mhz20031217/RISwitch/riswitch/vsrc/vga_ctrl.sv

`timescale 10ns/1ns
module vga_ctrl(
    input pclk,
    input reset,
    input [11:0] vga_data,
    output [9:0] h_addr,
    output [9:0] v_addr,
    output hsync,
    output vsync,
    output valid,
    output [3:0] vga_r,
    output [3:0] vga_g,
    output [3:0] vga_b
);

parameter h_frontporch = 96;
parameter h_active = 144;
parameter h_backporch = 784;
parameter h_total = 800;

parameter v_frontporch = 2;
parameter v_active = 35;
parameter v_backporch = 515;
parameter v_total = 525;

reg [9:0] x_cnt;
reg [9:0] y_cnt;
wire h_valid;
wire v_valid;

always @(posedge pclk) begin
    if (reset == 1'b1) begin
        x_cnt <= 1;
        y_cnt <= 1;
    end
    else begin
        if (x_cnt == h_total) begin
            x_cnt <= 1;
            if (y_cnt == v_total)
                y_cnt <= 1;
            else
                y_cnt <= y_cnt + 1;
        end
        else
            x_cnt <= x_cnt + 1;
    end
end

assign hsync = (x_cnt > h_frontporch);
assign vsync = (y_cnt > v_frontporch);

assign h_valid = (x_cnt > h_active) & (x_cnt <= h_backporch);
assign v_valid = (y_cnt > v_active) & (y_cnt <= v_backporch);
assign valid = h_valid & v_valid;

assign h_addr = h_valid ? (x_cnt - 10'd145) : {10{1'b0}};
assign v_addr = v_valid ? (y_cnt - 10'd36) : {10{1'b0}};

assign {vga_r, vga_g, vga_b} = (valid) ? vga_data : 12'b0;

endmodule
