mhz20031217/RISwitch/am-kernels/tests/fpga-simple/src/main.c

#include <am.h>
#include <klib.h>
#include <klib-macros.h>

void delay() {
  for (volatile int i = 0; i < 10; i ++);
}

void led_test() {
  for (volatile uint16_t i = 1; i; i <<= 1) {
    io_write(AM_LED, i);
    //delay();
  }
  io_write(AM_LED, 1234);
}

void seg_test() {
  volatile uint32_t v = 0xabcdef88;
  for (volatile int i = 0; i < 1000000; i ++) {
    io_write(AM_SEG, v);
    delay();
    v = (v << 4) | (v >> 28);
  }
}

int main(const char *args) {
  halt(SWITCH_EXIT_SUCCESS);
}
