mhz20031217/RISwitch/(commit log)

2023-09-10 NJU-ProjectN/fceux-am ics2021 initialized without tracing
    NJU-ProjectN/fceux-am c56157ba6627ae35eb1457c365ea7e6ed125aaf2 driver,sdl,sdl-video: fix the number of scanline
2023-09-10 > compile NEMU 221830012 茆弘之 Linux pc 5.15.0-79-generic #86-Ubuntu SMP Mon Jul 10 16:07:21 UTC 2023 x86_64 x86_64 x86_64 GNU/Linux 16:56:16 up 11 days, 22:02, 15 users, load average: 1.12, 0.72, 0.50
2023-09-10 > compile NEMU 221830012 茆弘之 Linux pc 5.15.0-79-generic #86-Ubuntu SMP Mon Jul 10 16:07:21 UTC 2023 x86_64 x86_64 x86_64 GNU/Linux 16:56:27 up 11 days, 22:02, 15 users, load average: 0.94, 0.70, 0.50
2023-09-10 > run NEMU 221830012 茆弘之 Linux pc 5.15.0-79-generic #86-Ubuntu SMP Mon Jul 10 16:07:21 UTC 2023 x86_64 x86_64 x86_64 GNU/Linux 16:56:28 up 11 days, 22:02, 15 users, load average: 0.94, 0.70, 0.50
2023-09-10 > compile NEMU 221830012 茆弘之 Linux pc 5.15.0-79-generic #86-Ubuntu SMP Mon Jul 10 16:07:21 UTC 2023 x86_64 x86_64 x86_64 GNU/Linux 16:56:39 up 11 days, 22:02, 15 users, load average: 1.10, 0.75, 0.52
2023-09-10 > gdb NEMU 221830012 茆弘之 Linux pc 5.15.0-79-generic #86-Ubuntu SMP Mon Jul 10 16:07:21 UTC 2023 x86_64 x86_64 x86_64 GNU/Linux 16:56:40 up 11 days, 22:02, 15 users, load average: 1.10, 0.75, 0.52
2023-09-10 > compile NEMU 221830012 茆弘之 Linux pc 5.15.0-79-generic #86-Ubuntu SMP Mon Jul 10 16:07:21 UTC 2023 x86_64 x86_64 x86_64 GNU/Linux 20:59:58 up 12 days, 2:05, 4 users, load average: 0.41, 0.45, 0.51
2023-09-10 > compile NEMU 221830012 茆弘之 Linux pc 5.15.0-79-generic #86-Ubuntu SMP Mon Jul 10 16:07:21 UTC 2023 x86_64 x86_64 x86_64 GNU/Linux 21:00:57 up 12 days, 2:06, 4 users, load average: 0.28, 0.41, 0.49
2023-09-10 > compile NEMU 221830012 茆弘之 Linux pc 5.15.0-79-generic #86-Ubuntu SMP Mon Jul 10 16:07:21 UTC 2023 x86_64 x86_64 x86_64 GNU/Linux 21:01:35 up 12 days, 2:07, 4 users, load average: 0.49, 0.44, 0.50
2023-09-10 > compile NEMU 221830012 茆弘之 Linux pc 5.15.0-79-generic #86-Ubuntu SMP Mon Jul 10 16:07:21 UTC 2023 x86_64 x86_64 x86_64 GNU/Linux 21:02:14 up 12 days, 2:08, 4 users, load average: 0.37, 0.41, 0.49
2023-09-10 > compile NEMU 221830012 茆弘之 Linux pc 5.15.0-79-generic #86-Ubuntu SMP Mon Jul 10 16:07:21 UTC 2023 x86_64 x86_64 x86_64 GNU/Linux 21:03:23 up 12 days, 2:09, 4 users, load average: 0.24, 0.36, 0.46
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2023-09-12 > compile NEMU 221830012 茆弘之 Linux pc 5.15.0-79-generic #86-Ubuntu SMP Mon Jul 10 16:07:21 UTC 2023 x86_64 x86_64 x86_64 GNU/Linux 11:46:47 up 13 days, 16:52, 4 users, load average: 1.14, 0.94, 0.77
2023-09-12 > compile NEMU 221830012 茆弘之 Linux pc 5.15.0-79-generic #86-Ubuntu SMP Mon Jul 10 16:07:21 UTC 2023 x86_64 x86_64 x86_64 GNU/Linux 11:48:33 up 13 days, 16:54, 4 users, load average: 1.05, 0.94, 0.79
2023-09-12 > compile NEMU 221830012 茆弘之 Linux pc 5.15.0-79-generic #86-Ubuntu SMP Mon Jul 10 16:07:21 UTC 2023 x86_64 x86_64 x86_64 GNU/Linux 11:49:17 up 13 days, 16:55, 4 users, load average: 0.63, 0.84, 0.76
2023-09-12 > run NEMU 221830012 茆弘之 Linux pc 5.15.0-79-generic #86-Ubuntu SMP Mon Jul 10 16:07:21 UTC 2023 x86_64 x86_64 x86_64 GNU/Linux 11:49:18 up 13 days, 16:55, 4 users, load average: 0.63, 0.84, 0.76
2023-09-12 > compile NEMU 221830012 茆弘之 Linux pc 5.15.0-79-generic #86-Ubuntu SMP Mon Jul 10 16:07:21 UTC 2023 x86_64 x86_64 x86_64 GNU/Linux 11:49:51 up 13 days, 16:55, 4 users, load average: 0.47, 0.78, 0.74
2023-09-12 > run NEMU 221830012 茆弘之 Linux pc 5.15.0-79-generic #86-Ubuntu SMP Mon Jul 10 16:07:21 UTC 2023 x86_64 x86_64 x86_64 GNU/Linux 11:49:52 up 13 days, 16:55, 4 users, load average: 0.47, 0.78, 0.74
2023-09-12 > compile NEMU 221830012 茆弘之 Linux pc 5.15.0-79-generic #86-Ubuntu SMP Mon Jul 10 16:07:21 UTC 2023 x86_64 x86_64 x86_64 GNU/Linux 11:50:08 up 13 days, 16:55, 4 users, load average: 0.69, 0.81, 0.75
2023-09-12 > run NEMU 221830012 茆弘之 Linux pc 5.15.0-79-generic #86-Ubuntu SMP Mon Jul 10 16:07:21 UTC 2023 x86_64 x86_64 x86_64 GNU/Linux 11:50:09 up 13 days, 16:55, 4 users, load average: 0.69, 0.81, 0.75
2023-09-12 > compile NEMU 221830012 茆弘之 Linux pc 5.15.0-79-generic #86-Ubuntu SMP Mon Jul 10 16:07:21 UTC 2023 x86_64 x86_64 x86_64 GNU/Linux 11:57:37 up 13 days, 17:03, 4 users, load average: 1.59, 1.10, 0.89
2023-09-12 > compile NEMU 221830012 茆弘之 Linux pc 5.15.0-79-generic #86-Ubuntu SMP Mon Jul 10 16:07:21 UTC 2023 x86_64 x86_64 x86_64 GNU/Linux 11:57:40 up 13 days, 17:03, 4 users, load average: 1.59, 1.10, 0.89
2023-09-12 > run NEMU 221830012 茆弘之 Linux pc 5.15.0-79-generic #86-Ubuntu SMP Mon Jul 10 16:07:21 UTC 2023 x86_64 x86_64 x86_64 GNU/Linux 11:57:41 up 13 days, 17:03, 4 users, load average: 1.55, 1.10, 0.89
2023-09-12 > compile NEMU 221830012 茆弘之 Linux pc 5.15.0-79-generic #86-Ubuntu SMP Mon Jul 10 16:07:21 UTC 2023 x86_64 x86_64 x86_64 GNU/Linux 13:32:41 up 13 days, 18:38, 4 users, load average: 0.21, 0.28, 0.44
2023-09-12 > run NEMU 221830012 茆弘之 Linux pc 5.15.0-79-generic #86-Ubuntu SMP Mon Jul 10 16:07:21 UTC 2023 x86_64 x86_64 x86_64 GNU/Linux 13:32:42 up 13 days, 18:38, 4 users, load average: 0.21, 0.28, 0.44
2023-09-12 > compile NEMU 221830012 茆弘之 Linux pc 5.15.0-79-generic #86-Ubuntu SMP Mon Jul 10 16:07:21 UTC 2023 x86_64 x86_64 x86_64 GNU/Linux 13:35:01 up 13 days, 18:40, 4 users, load average: 0.84, 0.43, 0.47
2023-09-12 > run NEMU 221830012 茆弘之 Linux pc 5.15.0-79-generic #86-Ubuntu SMP Mon Jul 10 16:07:21 UTC 2023 x86_64 x86_64 x86_64 GNU/Linux 13:35:01 up 13 days, 18:40, 4 users, load average: 0.84, 0.43, 0.47
2023-09-12 > compile NEMU 221830012 茆弘之 Linux pc 5.15.0-79-generic #86-Ubuntu SMP Mon Jul 10 16:07:21 UTC 2023 x86_64 x86_64 x86_64 GNU/Linux 13:35:54 up 13 days, 18:41, 4 users, load average: 0.70, 0.46, 0.48
2023-09-12 > run NEMU 221830012 茆弘之 Linux pc 5.15.0-79-generic #86-Ubuntu SMP Mon Jul 10 16:07:21 UTC 2023 x86_64 x86_64 x86_64 GNU/Linux 13:35:55 up 13 days, 18:41, 4 users, load average: 0.73, 0.47, 0.48
2023-09-12 > compile NEMU 221830012 茆弘之 Linux pc 5.15.0-79-generic #86-Ubuntu SMP Mon Jul 10 16:07:21 UTC 2023 x86_64 x86_64 x86_64 GNU/Linux 13:38:23 up 13 days, 18:44, 4 users, load average: 0.30, 0.41, 0.45
2023-09-12 > run NEMU 221830012 茆弘之 Linux pc 5.15.0-79-generic #86-Ubuntu SMP Mon Jul 10 16:07:21 UTC 2023 x86_64 x86_64 x86_64 GNU/Linux 13:38:23 up 13 days, 18:44, 4 users, load average: 0.30, 0.41, 0.45
2023-09-12 > compile NEMU 221830012 茆弘之 Linux pc 5.15.0-79-generic #86-Ubuntu SMP Mon Jul 10 16:07:21 UTC 2023 x86_64 x86_64 x86_64 GNU/Linux 13:39:31 up 13 days, 18:45, 4 users, load average: 0.52, 0.45, 0.46
2023-09-12 > run NEMU 221830012 茆弘之 Linux pc 5.15.0-79-generic #86-Ubuntu SMP Mon Jul 10 16:07:21 UTC 2023 x86_64 x86_64 x86_64 GNU/Linux 13:39:31 up 13 days, 18:45, 4 users, load average: 0.52, 0.45, 0.46
2023-09-12 > compile NEMU 221830012 茆弘之 Linux pc 5.15.0-79-generic #86-Ubuntu SMP Mon Jul 10 16:07:21 UTC 2023 x86_64 x86_64 x86_64 GNU/Linux 13:51:32 up 13 days, 18:57, 4 users, load average: 2.24, 1.31, 0.80
2023-09-12 > compile NEMU 221830012 茆弘之 Linux pc 5.15.0-79-generic #86-Ubuntu SMP Mon Jul 10 16:07:21 UTC 2023 x86_64 x86_64 x86_64 GNU/Linux 13:51:46 up 13 days, 18:57, 4 users, load average: 2.73, 1.46, 0.86
2023-09-12 > compile NEMU 221830012 茆弘之 Linux pc 5.15.0-79-generic #86-Ubuntu SMP Mon Jul 10 16:07:21 UTC 2023 x86_64 x86_64 x86_64 GNU/Linux 15:58:47 up 13 days, 21:04, 4 users, load average: 0.38, 0.58, 0.77
2023-09-12 > run NEMU 221830012 茆弘之 Linux pc 5.15.0-79-generic #86-Ubuntu SMP Mon Jul 10 16:07:21 UTC 2023 x86_64 x86_64 x86_64 GNU/Linux 15:58:47 up 13 days, 21:04, 4 users, load average: 0.38, 0.58, 0.77
2023-09-12 > compile NEMU 221830012 茆弘之 Linux pc 5.15.0-79-generic #86-Ubuntu SMP Mon Jul 10 16:07:21 UTC 2023 x86_64 x86_64 x86_64 GNU/Linux 16:04:29 up 13 days, 21:10, 4 users, load average: 0.41, 0.42, 0.63
2023-09-12 > run NEMU 221830012 茆弘之 Linux pc 5.15.0-79-generic #86-Ubuntu SMP Mon Jul 10 16:07:21 UTC 2023 x86_64 x86_64 x86_64 GNU/Linux 16:04:29 up 13 days, 21:10, 4 users, load average: 0.41, 0.42, 0.63
2023-09-12 > compile NEMU 221830012 茆弘之 Linux pc 5.15.0-79-generic #86-Ubuntu SMP Mon Jul 10 16:07:21 UTC 2023 x86_64 x86_64 x86_64 GNU/Linux 17:43:27 up 13 days, 22:49, 4 users, load average: 0.91, 0.77, 0.70
2023-09-12 > run NEMU 221830012 茆弘之 Linux pc 5.15.0-79-generic #86-Ubuntu SMP Mon Jul 10 16:07:21 UTC 2023 x86_64 x86_64 x86_64 GNU/Linux 17:43:28 up 13 days, 22:49, 4 users, load average: 0.91, 0.77, 0.70
2023-09-12 > compile NEMU 221830012 茆弘之 Linux pc 5.15.0-79-generic #86-Ubuntu SMP Mon Jul 10 16:07:21 UTC 2023 x86_64 x86_64 x86_64 GNU/Linux 17:44:16 up 13 days, 22:50, 4 users, load average: 0.89, 0.78, 0.71
2023-09-12 > run NEMU 221830012 茆弘之 Linux pc 5.15.0-79-generic #86-Ubuntu SMP Mon Jul 10 16:07:21 UTC 2023 x86_64 x86_64 x86_64 GNU/Linux 17:44:17 up 13 days, 22:50, 4 users, load average: 0.89, 0.78, 0.71
2023-09-12 > compile NEMU 221830012 茆弘之 Linux pc 5.15.0-79-generic #86-Ubuntu SMP Mon Jul 10 16:07:21 UTC 2023 x86_64 x86_64 x86_64 GNU/Linux 18:17:17 up 13 days, 23:23, 4 users, load average: 0.88, 0.65, 0.70
2023-09-12 > run NEMU 221830012 茆弘之 Linux pc 5.15.0-79-generic #86-Ubuntu SMP Mon Jul 10 16:07:21 UTC 2023 x86_64 x86_64 x86_64 GNU/Linux 18:17:17 up 13 days, 23:23, 4 users, load average: 0.88, 0.65, 0.70
2023-09-12 > compile NEMU 221830012 茆弘之 Linux pc 5.15.0-79-generic #86-Ubuntu SMP Mon Jul 10 16:07:21 UTC 2023 x86_64 x86_64 x86_64 GNU/Linux 22:28:09 up 14 days, 3:33, 4 users, load average: 1.01, 0.96, 0.79
2023-09-12 > run NEMU 221830012 茆弘之 Linux pc 5.15.0-79-generic #86-Ubuntu SMP Mon Jul 10 16:07:21 UTC 2023 x86_64 x86_64 x86_64 GNU/Linux 22:28:09 up 14 days, 3:33, 4 users, load average: 1.01, 0.96, 0.79
2023-09-14 > compile NEMU 221830012 茆弘之 Linux pc 5.15.0-82-generic #91-Ubuntu SMP Mon Aug 14 14:14:14 UTC 2023 x86_64 x86_64 x86_64 GNU/Linux 10:21:38 up 14:47, 4 users, load average: 0.67, 0.64, 0.70
2023-09-14 > run NEMU 221830012 茆弘之 Linux pc 5.15.0-82-generic #91-Ubuntu SMP Mon Aug 14 14:14:14 UTC 2023 x86_64 x86_64 x86_64 GNU/Linux 10:21:39 up 14:47, 4 users, load average: 0.70, 0.65, 0.70
2023-09-14 > compile NEMU 221830012 茆弘之 Linux pc 5.15.0-82-generic #91-Ubuntu SMP Mon Aug 14 14:14:14 UTC 2023 x86_64 x86_64 x86_64 GNU/Linux 10:24:07 up 14:50, 4 users, load average: 0.90, 0.78, 0.75
2023-09-14 > run NEMU 221830012 茆弘之 Linux pc 5.15.0-82-generic #91-Ubuntu SMP Mon Aug 14 14:14:14 UTC 2023 x86_64 x86_64 x86_64 GNU/Linux 10:24:08 up 14:50, 4 users, load average: 0.90, 0.78, 0.75
2023-09-14 > compile NEMU 221830012 茆弘之 Linux pc 5.15.0-82-generic #91-Ubuntu SMP Mon Aug 14 14:14:14 UTC 2023 x86_64 x86_64 x86_64 GNU/Linux 10:24:23 up 14:50, 4 users, load average: 0.70, 0.74, 0.73
2023-09-14 > gdb NEMU 221830012 茆弘之 Linux pc 5.15.0-82-generic #91-Ubuntu SMP Mon Aug 14 14:14:14 UTC 2023 x86_64 x86_64 x86_64 GNU/Linux 10:24:24 up 14:50, 4 users, load average: 0.73, 0.74, 0.73
2023-09-14 > compile NEMU 221830012 茆弘之 Linux pc 5.15.0-82-generic #91-Ubuntu SMP Mon Aug 14 14:14:14 UTC 2023 x86_64 x86_64 x86_64 GNU/Linux 10:31:03 up 14:57, 4 users, load average: 0.34, 0.51, 0.63
2023-09-14 > gdb NEMU 221830012 茆弘之 Linux pc 5.15.0-82-generic #91-Ubuntu SMP Mon Aug 14 14:14:14 UTC 2023 x86_64 x86_64 x86_64 GNU/Linux 10:31:04 up 14:57, 4 users, load average: 0.34, 0.51, 0.63
2023-09-14 > compile NEMU 221830012 茆弘之 Linux pc 5.15.0-82-generic #91-Ubuntu SMP Mon Aug 14 14:14:14 UTC 2023 x86_64 x86_64 x86_64 GNU/Linux 10:34:18 up 15:00, 4 users, load average: 0.25, 0.39, 0.56
2023-09-14 > gdb NEMU 221830012 茆弘之 Linux pc 5.15.0-82-generic #91-Ubuntu SMP Mon Aug 14 14:14:14 UTC 2023 x86_64 x86_64 x86_64 GNU/Linux 10:34:19 up 15:00, 4 users, load average: 0.31, 0.40, 0.56
2023-09-14 > compile NEMU 221830012 茆弘之 Linux pc 5.15.0-82-generic #91-Ubuntu SMP Mon Aug 14 14:14:14 UTC 2023 x86_64 x86_64 x86_64 GNU/Linux 10:34:57 up 15:00, 4 users, load average: 0.37, 0.40, 0.55
2023-09-14 > gdb NEMU 221830012 茆弘之 Linux pc 5.15.0-82-generic #91-Ubuntu SMP Mon Aug 14 14:14:14 UTC 2023 x86_64 x86_64 x86_64 GNU/Linux 10:34:58 up 15:00, 4 users, load average: 0.37, 0.40, 0.55
2023-09-14 > compile NEMU 221830012 茆弘之 Linux pc 5.15.0-82-generic #91-Ubuntu SMP Mon Aug 14 14:14:14 UTC 2023 x86_64 x86_64 x86_64 GNU/Linux 10:49:55 up 15:15, 4 users, load average: 0.55, 0.41, 0.45
2023-09-14 > gdb NEMU 221830012 茆弘之 Linux pc 5.15.0-82-generic #91-Ubuntu SMP Mon Aug 14 14:14:14 UTC 2023 x86_64 x86_64 x86_64 GNU/Linux 10:49:55 up 15:15, 4 users, load average: 0.59, 0.42, 0.46
2023-09-14 > compile NEMU 221830012 茆弘之 Linux pc 5.15.0-82-generic #91-Ubuntu SMP Mon Aug 14 14:14:14 UTC 2023 x86_64 x86_64 x86_64 GNU/Linux 10:56:26 up 15:22, 4 users, load average: 1.01, 0.79, 0.61
2023-09-14 > gdb NEMU 221830012 茆弘之 Linux pc 5.15.0-82-generic #91-Ubuntu SMP Mon Aug 14 14:14:14 UTC 2023 x86_64 x86_64 x86_64 GNU/Linux 10:56:27 up 15:22, 4 users, load average: 1.01, 0.79, 0.61
2023-09-14 > compile NEMU 221830012 茆弘之 Linux pc 5.15.0-82-generic #91-Ubuntu SMP Mon Aug 14 14:14:14 UTC 2023 x86_64 x86_64 x86_64 GNU/Linux 11:03:52 up 15:29, 4 users, load average: 0.86, 0.68, 0.60
2023-09-14 > gdb NEMU 221830012 茆弘之 Linux pc 5.15.0-82-generic #91-Ubuntu SMP Mon Aug 14 14:14:14 UTC 2023 x86_64 x86_64 x86_64 GNU/Linux 11:03:53 up 15:29, 4 users, load average: 0.86, 0.68, 0.60
2023-09-14 > compile NEMU 221830012 茆弘之 Linux pc 5.15.0-82-generic #91-Ubuntu SMP Mon Aug 14 14:14:14 UTC 2023 x86_64 x86_64 x86_64 GNU/Linux 11:07:00 up 15:33, 4 users, load average: 1.28, 1.20, 0.84
2023-09-14 > gdb NEMU 221830012 茆弘之 Linux pc 5.15.0-82-generic #91-Ubuntu SMP Mon Aug 14 14:14:14 UTC 2023 x86_64 x86_64 x86_64 GNU/Linux 11:07:01 up 15:33, 4 users, load average: 1.25, 1.19, 0.84
2023-09-14 > compile NEMU 221830012 茆弘之 Linux pc 5.15.0-82-generic #91-Ubuntu SMP Mon Aug 14 14:14:14 UTC 2023 x86_64 x86_64 x86_64 GNU/Linux 11:07:27 up 15:33, 4 users, load average: 2.45, 1.49, 0.95
2023-09-14 > gdb NEMU 221830012 茆弘之 Linux pc 5.15.0-82-generic #91-Ubuntu SMP Mon Aug 14 14:14:14 UTC 2023 x86_64 x86_64 x86_64 GNU/Linux 11:07:27 up 15:33, 4 users, load average: 2.45, 1.49, 0.95
2023-09-14 > compile NEMU 221830012 茆弘之 Linux pc 5.15.0-82-generic #91-Ubuntu SMP Mon Aug 14 14:14:14 UTC 2023 x86_64 x86_64 x86_64 GNU/Linux 11:10:14 up 15:36, 4 users, load average: 1.15, 1.32, 0.98
2023-09-14 > gdb NEMU 221830012 茆弘之 Linux pc 5.15.0-82-generic #91-Ubuntu SMP Mon Aug 14 14:14:14 UTC 2023 x86_64 x86_64 x86_64 GNU/Linux 11:10:15 up 15:36, 4 users, load average: 1.15, 1.32, 0.98
2023-09-14 > compile NEMU 221830012 茆弘之 Linux pc 5.15.0-82-generic #91-Ubuntu SMP Mon Aug 14 14:14:14 UTC 2023 x86_64 x86_64 x86_64 GNU/Linux 11:12:32 up 15:38, 4 users, load average: 0.38, 0.95, 0.89
2023-09-14 > gdb NEMU 221830012 茆弘之 Linux pc 5.15.0-82-generic #91-Ubuntu SMP Mon Aug 14 14:14:14 UTC 2023 x86_64 x86_64 x86_64 GNU/Linux 11:12:33 up 15:38, 4 users, load average: 0.38, 0.95, 0.89
2023-09-14 > compile NEMU 221830012 茆弘之 Linux pc 5.15.0-82-generic #91-Ubuntu SMP Mon Aug 14 14:14:14 UTC 2023 x86_64 x86_64 x86_64 GNU/Linux 11:14:28 up 15:40, 4 users, load average: 0.63, 0.82, 0.84
2023-09-14 > gdb NEMU 221830012 茆弘之 Linux pc 5.15.0-82-generic #91-Ubuntu SMP Mon Aug 14 14:14:14 UTC 2023 x86_64 x86_64 x86_64 GNU/Linux 11:14:29 up 15:40, 4 users, load average: 0.63, 0.82, 0.84
2023-09-14 > compile NEMU 221830012 茆弘之 Linux pc 5.15.0-82-generic #91-Ubuntu SMP Mon Aug 14 14:14:14 UTC 2023 x86_64 x86_64 x86_64 GNU/Linux 11:16:17 up 15:42, 4 users, load average: 0.90, 0.83, 0.84
2023-09-14 > gdb NEMU 221830012 茆弘之 Linux pc 5.15.0-82-generic #91-Ubuntu SMP Mon Aug 14 14:14:14 UTC 2023 x86_64 x86_64 x86_64 GNU/Linux 11:16:18 up 15:42, 4 users, load average: 0.90, 0.83, 0.84
2023-09-14 > compile NEMU 221830012 茆弘之 Linux pc 5.15.0-82-generic #91-Ubuntu SMP Mon Aug 14 14:14:14 UTC 2023 x86_64 x86_64 x86_64 GNU/Linux 11:27:33 up 15:53, 4 users, load average: 0.97, 0.68, 0.71
2023-09-14 > gdb NEMU 221830012 茆弘之 Linux pc 5.15.0-82-generic #91-Ubuntu SMP Mon Aug 14 14:14:14 UTC 2023 x86_64 x86_64 x86_64 GNU/Linux 11:27:34 up 15:53, 4 users, load average: 0.97, 0.68, 0.71
2023-09-14 > compile NEMU 221830012 茆弘之 Linux pc 5.15.0-82-generic #91-Ubuntu SMP Mon Aug 14 14:14:14 UTC 2023 x86_64 x86_64 x86_64 GNU/Linux 11:30:04 up 15:56, 4 users, load average: 0.99, 0.90, 0.79
2023-09-14 > gdb NEMU 221830012 茆弘之 Linux pc 5.15.0-82-generic #91-Ubuntu SMP Mon Aug 14 14:14:14 UTC 2023 x86_64 x86_64 x86_64 GNU/Linux 11:30:05 up 15:56, 4 users, load average: 0.99, 0.90, 0.79
2023-09-14 > compile NEMU 221830012 茆弘之 Linux pc 5.15.0-82-generic #91-Ubuntu SMP Mon Aug 14 14:14:14 UTC 2023 x86_64 x86_64 x86_64 GNU/Linux 11:30:32 up 15:56, 4 users, load average: 0.79, 0.86, 0.78
2023-09-14 > gdb NEMU 221830012 茆弘之 Linux pc 5.15.0-82-generic #91-Ubuntu SMP Mon Aug 14 14:14:14 UTC 2023 x86_64 x86_64 x86_64 GNU/Linux 11:30:33 up 15:56, 4 users, load average: 0.79, 0.86, 0.78
2023-09-14 > compile NEMU 221830012 茆弘之 Linux pc 5.15.0-82-generic #91-Ubuntu SMP Mon Aug 14 14:14:14 UTC 2023 x86_64 x86_64 x86_64 GNU/Linux 11:31:22 up 15:57, 4 users, load average: 0.66, 0.80, 0.77
2023-09-14 > gdb NEMU 221830012 茆弘之 Linux pc 5.15.0-82-generic #91-Ubuntu SMP Mon Aug 14 14:14:14 UTC 2023 x86_64 x86_64 x86_64 GNU/Linux 11:31:23 up 15:57, 4 users, load average: 0.66, 0.80, 0.77
2023-09-14 > compile NEMU 221830012 茆弘之 Linux pc 5.15.0-82-generic #91-Ubuntu SMP Mon Aug 14 14:14:14 UTC 2023 x86_64 x86_64 x86_64 GNU/Linux 11:31:58 up 15:57, 4 users, load average: 0.62, 0.78, 0.76
2023-09-14 > gdb NEMU 221830012 茆弘之 Linux pc 5.15.0-82-generic #91-Ubuntu SMP Mon Aug 14 14:14:14 UTC 2023 x86_64 x86_64 x86_64 GNU/Linux 11:31:58 up 15:57, 4 users, load average: 0.62, 0.78, 0.76
2023-09-14 > compile NEMU 221830012 茆弘之 Linux pc 5.15.0-82-generic #91-Ubuntu SMP Mon Aug 14 14:14:14 UTC 2023 x86_64 x86_64 x86_64 GNU/Linux 11:32:25 up 15:58, 4 users, load average: 0.98, 0.84, 0.78
2023-09-14 > gdb NEMU 221830012 茆弘之 Linux pc 5.15.0-82-generic #91-Ubuntu SMP Mon Aug 14 14:14:14 UTC 2023 x86_64 x86_64 x86_64 GNU/Linux 11:32:26 up 15:58, 4 users, load average: 0.98, 0.84, 0.78
2023-09-14 > compile NEMU 221830012 茆弘之 Linux pc 5.15.0-82-generic #91-Ubuntu SMP Mon Aug 14 14:14:14 UTC 2023 x86_64 x86_64 x86_64 GNU/Linux 11:34:51 up 16:00, 4 users, load average: 0.88, 0.82, 0.78
2023-09-14 > gdb NEMU 221830012 茆弘之 Linux pc 5.15.0-82-generic #91-Ubuntu SMP Mon Aug 14 14:14:14 UTC 2023 x86_64 x86_64 x86_64 GNU/Linux 11:34:52 up 16:00, 4 users, load average: 0.88, 0.82, 0.78
2023-09-14 > compile NEMU 221830012 茆弘之 Linux pc 5.15.0-82-generic #91-Ubuntu SMP Mon Aug 14 14:14:14 UTC 2023 x86_64 x86_64 x86_64 GNU/Linux 13:41:53 up 18:07, 4 users, load average: 0.36, 0.47, 0.59
2023-09-14 > run NEMU 221830012 茆弘之 Linux pc 5.15.0-82-generic #91-Ubuntu SMP Mon Aug 14 14:14:14 UTC 2023 x86_64 x86_64 x86_64 GNU/Linux 13:41:53 up 18:07, 4 users, load average: 0.41, 0.48, 0.59
2023-09-14 > compile NEMU 221830012 茆弘之 Linux pc 5.15.0-82-generic #91-Ubuntu SMP Mon Aug 14 14:14:14 UTC 2023 x86_64 x86_64 x86_64 GNU/Linux 14:22:02 up 18:48, 4 users, load average: 0.59, 0.60, 0.58
2023-09-14 > run NEMU 221830012 茆弘之 Linux pc 5.15.0-82-generic #91-Ubuntu SMP Mon Aug 14 14:14:14 UTC 2023 x86_64 x86_64 x86_64 GNU/Linux 14:22:03 up 18:48, 4 users, load average: 0.59, 0.60, 0.58
2023-09-14 > compile NEMU 221830012 茆弘之 Linux pc 5.15.0-82-generic #91-Ubuntu SMP Mon Aug 14 14:14:14 UTC 2023 x86_64 x86_64 x86_64 GNU/Linux 14:24:46 up 18:50, 4 users, load average: 1.18, 0.86, 0.68
2023-09-14 > run NEMU 221830012 茆弘之 Linux pc 5.15.0-82-generic #91-Ubuntu SMP Mon Aug 14 14:14:14 UTC 2023 x86_64 x86_64 x86_64 GNU/Linux 14:24:47 up 18:50, 4 users, load average: 1.18, 0.86, 0.68
2023-09-14 > compile NEMU 221830012 茆弘之 Linux pc 5.15.0-82-generic #91-Ubuntu SMP Mon Aug 14 14:14:14 UTC 2023 x86_64 x86_64 x86_64 GNU/Linux 14:25:02 up 18:51, 4 users, load average: 0.91, 0.81, 0.67
2023-09-14 > run NEMU 221830012 茆弘之 Linux pc 5.15.0-82-generic #91-Ubuntu SMP Mon Aug 14 14:14:14 UTC 2023 x86_64 x86_64 x86_64 GNU/Linux 14:25:03 up 18:51, 4 users, load average: 0.91, 0.81, 0.67
2023-09-14 > compile NEMU 221830012 茆弘之 Linux pc 5.15.0-82-generic #91-Ubuntu SMP Mon Aug 14 14:14:14 UTC 2023 x86_64 x86_64 x86_64 GNU/Linux 14:35:46 up 19:01, 4 users, load average: 0.41, 0.65, 0.67
2023-09-14 > run NEMU 221830012 茆弘之 Linux pc 5.15.0-82-generic #91-Ubuntu SMP Mon Aug 14 14:14:14 UTC 2023 x86_64 x86_64 x86_64 GNU/Linux 14:35:47 up 19:01, 4 users, load average: 0.41, 0.65, 0.67
2023-09-14 > compile NEMU 221830012 茆弘之 Linux pc 5.15.0-82-generic #91-Ubuntu SMP Mon Aug 14 14:14:14 UTC 2023 x86_64 x86_64 x86_64 GNU/Linux 14:59:49 up 19:25, 4 users, load average: 0.53, 0.53, 0.54
2023-09-14 > run NEMU 221830012 茆弘之 Linux pc 5.15.0-82-generic #91-Ubuntu SMP Mon Aug 14 14:14:14 UTC 2023 x86_64 x86_64 x86_64 GNU/Linux 14:59:49 up 19:25, 4 users, load average: 0.53, 0.53, 0.54
2023-09-14 > compile NEMU 221830012 茆弘之 Linux pc 5.15.0-82-generic #91-Ubuntu SMP Mon Aug 14 14:14:14 UTC 2023 x86_64 x86_64 x86_64 GNU/Linux 16:00:41 up 20:26, 4 users, load average: 1.18, 1.10, 0.73
2023-09-14 > run NEMU 221830012 茆弘之 Linux pc 5.15.0-82-generic #91-Ubuntu SMP Mon Aug 14 14:14:14 UTC 2023 x86_64 x86_64 x86_64 GNU/Linux 16:00:42 up 20:26, 4 users, load average: 1.18, 1.10, 0.73
2023-09-14 > compile NEMU 221830012 茆弘之 Linux pc 5.15.0-82-generic #91-Ubuntu SMP Mon Aug 14 14:14:14 UTC 2023 x86_64 x86_64 x86_64 GNU/Linux 22:26:35 up 1 day, 2:52, 4 users, load average: 0.61, 1.12, 0.98
2023-09-14 > run NEMU 221830012 茆弘之 Linux pc 5.15.0-82-generic #91-Ubuntu SMP Mon Aug 14 14:14:14 UTC 2023 x86_64 x86_64 x86_64 GNU/Linux 22:26:35 up 1 day, 2:52, 4 users, load average: 0.61, 1.12, 0.98
2023-09-14 > compile NEMU 221830012 茆弘之 Linux pc 5.15.0-82-generic #91-Ubuntu SMP Mon Aug 14 14:14:14 UTC 2023 x86_64 x86_64 x86_64 GNU/Linux 22:37:51 up 1 day, 3:03, 4 users, load average: 0.49, 0.59, 0.78
2023-09-14 > run NEMU 221830012 茆弘之 Linux pc 5.15.0-82-generic #91-Ubuntu SMP Mon Aug 14 14:14:14 UTC 2023 x86_64 x86_64 x86_64 GNU/Linux 22:37:51 up 1 day, 3:03, 4 users, load average: 0.49, 0.59, 0.78
2023-09-14 > compile NEMU 221830012 茆弘之 Linux pc 5.15.0-82-generic #91-Ubuntu SMP Mon Aug 14 14:14:14 UTC 2023 x86_64 x86_64 x86_64 GNU/Linux 23:07:08 up 1 day, 3:33, 4 users, load average: 0.20, 0.46, 0.58
2023-09-14 > run NEMU 221830012 茆弘之 Linux pc 5.15.0-82-generic #91-Ubuntu SMP Mon Aug 14 14:14:14 UTC 2023 x86_64 x86_64 x86_64 GNU/Linux 23:07:08 up 1 day, 3:33, 4 users, load average: 0.20, 0.46, 0.58
2023-09-14 > compile NEMU 221830012 茆弘之 Linux pc 5.15.0-82-generic #91-Ubuntu SMP Mon Aug 14 14:14:14 UTC 2023 x86_64 x86_64 x86_64 GNU/Linux 23:08:46 up 1 day, 3:34, 4 users, load average: 0.74, 0.53, 0.59
2023-09-14 > run NEMU 221830012 茆弘之 Linux pc 5.15.0-82-generic #91-Ubuntu SMP Mon Aug 14 14:14:14 UTC 2023 x86_64 x86_64 x86_64 GNU/Linux 23:08:46 up 1 day, 3:34, 4 users, load average: 0.74, 0.53, 0.59
2023-09-14 > compile NEMU 221830012 茆弘之 Linux pc 5.15.0-82-generic #91-Ubuntu SMP Mon Aug 14 14:14:14 UTC 2023 x86_64 x86_64 x86_64 GNU/Linux 23:09:20 up 1 day, 3:35, 4 users, load average: 0.96, 0.64, 0.62
2023-09-14 > run NEMU 221830012 茆弘之 Linux pc 5.15.0-82-generic #91-Ubuntu SMP Mon Aug 14 14:14:14 UTC 2023 x86_64 x86_64 x86_64 GNU/Linux 23:09:21 up 1 day, 3:35, 4 users, load average: 0.96, 0.64, 0.62
2023-09-14 > compile NEMU 221830012 茆弘之 Linux pc 5.15.0-82-generic #91-Ubuntu SMP Mon Aug 14 14:14:14 UTC 2023 x86_64 x86_64 x86_64 GNU/Linux 23:11:30 up 1 day, 3:37, 4 users, load average: 0.59, 0.64, 0.63
2023-09-14 > run NEMU 221830012 茆弘之 Linux pc 5.15.0-82-generic #91-Ubuntu SMP Mon Aug 14 14:14:14 UTC 2023 x86_64 x86_64 x86_64 GNU/Linux 23:11:31 up 1 day, 3:37, 4 users, load average: 0.59, 0.64, 0.63
2023-09-15 Fixed .gitignore to trace pa
2023-09-16 > compile NEMU 221830012 茆弘之 Linux pc 5.15.0-82-generic #91-Ubuntu SMP Mon Aug 14 14:14:14 UTC 2023 x86_64 x86_64 x86_64 GNU/Linux 19:06:25 up 2 days, 23:32, 4 users, load average: 0.65, 0.84, 0.81
2023-09-16 > run NEMU 221830012 茆弘之 Linux pc 5.15.0-82-generic #91-Ubuntu SMP Mon Aug 14 14:14:14 UTC 2023 x86_64 x86_64 x86_64 GNU/Linux 19:06:25 up 2 days, 23:32, 4 users, load average: 0.65, 0.84, 0.81
2023-09-16 > compile NEMU 221830012 茆弘之 Linux pc 5.15.0-82-generic #91-Ubuntu SMP Mon Aug 14 14:14:14 UTC 2023 x86_64 x86_64 x86_64 GNU/Linux 19:25:39 up 2 days, 23:51, 4 users, load average: 0.38, 0.49, 0.61
2023-09-16 > run NEMU 221830012 茆弘之 Linux pc 5.15.0-82-generic #91-Ubuntu SMP Mon Aug 14 14:14:14 UTC 2023 x86_64 x86_64 x86_64 GNU/Linux 19:25:40 up 2 days, 23:51, 4 users, load average: 0.38, 0.49, 0.61
2023-09-16 > compile NEMU 221830012 茆弘之 Linux pc 5.15.0-82-generic #91-Ubuntu SMP Mon Aug 14 14:14:14 UTC 2023 x86_64 x86_64 x86_64 GNU/Linux 20:04:58 up 3 days, 30 min, 4 users, load average: 0.54, 0.74, 0.78
2023-09-16 > run NEMU 221830012 茆弘之 Linux pc 5.15.0-82-generic #91-Ubuntu SMP Mon Aug 14 14:14:14 UTC 2023 x86_64 x86_64 x86_64 GNU/Linux 20:04:58 up 3 days, 30 min, 4 users, load average: 0.54, 0.74, 0.78
2023-09-16 > compile NEMU 221830012 茆弘之 Linux pc 5.15.0-82-generic #91-Ubuntu SMP Mon Aug 14 14:14:14 UTC 2023 x86_64 x86_64 x86_64 GNU/Linux 20:05:15 up 3 days, 31 min, 4 users, load average: 0.58, 0.74, 0.78
2023-09-16 > run NEMU 221830012 茆弘之 Linux pc 5.15.0-82-generic #91-Ubuntu SMP Mon Aug 14 14:14:14 UTC 2023 x86_64 x86_64 x86_64 GNU/Linux 20:05:16 up 3 days, 31 min, 4 users, load average: 0.58, 0.74, 0.78
2023-09-16 > compile NEMU 221830012 茆弘之 Linux pc 5.15.0-82-generic #91-Ubuntu SMP Mon Aug 14 14:14:14 UTC 2023 x86_64 x86_64 x86_64 GNU/Linux 20:08:42 up 3 days, 34 min, 4 users, load average: 0.69, 0.66, 0.73
2023-09-16 > run NEMU 221830012 茆弘之 Linux pc 5.15.0-82-generic #91-Ubuntu SMP Mon Aug 14 14:14:14 UTC 2023 x86_64 x86_64 x86_64 GNU/Linux 20:08:42 up 3 days, 34 min, 4 users, load average: 0.80, 0.68, 0.74
2023-09-16 > compile NEMU 221830012 茆弘之 Linux pc 5.15.0-82-generic #91-Ubuntu SMP Mon Aug 14 14:14:14 UTC 2023 x86_64 x86_64 x86_64 GNU/Linux 20:08:43 up 3 days, 34 min, 4 users, load average: 0.80, 0.68, 0.74
2023-09-16 > run NEMU 221830012 茆弘之 Linux pc 5.15.0-82-generic #91-Ubuntu SMP Mon Aug 14 14:14:14 UTC 2023 x86_64 x86_64 x86_64 GNU/Linux 20:08:43 up 3 days, 34 min, 4 users, load average: 0.80, 0.68, 0.74
2023-09-16 > compile NEMU 221830012 茆弘之 Linux pc 5.15.0-82-generic #91-Ubuntu SMP Mon Aug 14 14:14:14 UTC 2023 x86_64 x86_64 x86_64 GNU/Linux 20:08:44 up 3 days, 34 min, 4 users, load average: 0.80, 0.68, 0.74
2023-09-16 > run NEMU 221830012 茆弘之 Linux pc 5.15.0-82-generic #91-Ubuntu SMP Mon Aug 14 14:14:14 UTC 2023 x86_64 x86_64 x86_64 GNU/Linux 20:08:45 up 3 days, 34 min, 4 users, load average: 0.80, 0.68, 0.74
2023-09-16 > compile NEMU 221830012 茆弘之 Linux pc 5.15.0-82-generic #91-Ubuntu SMP Mon Aug 14 14:14:14 UTC 2023 x86_64 x86_64 x86_64 GNU/Linux 20:08:45 up 3 days, 34 min, 4 users, load average: 0.80, 0.68, 0.74
2023-09-16 > run NEMU 221830012 茆弘之 Linux pc 5.15.0-82-generic #91-Ubuntu SMP Mon Aug 14 14:14:14 UTC 2023 x86_64 x86_64 x86_64 GNU/Linux 20:08:46 up 3 days, 34 min, 4 users, load average: 0.80, 0.68, 0.74
2023-09-16 > compile NEMU 221830012 茆弘之 Linux pc 5.15.0-82-generic #91-Ubuntu SMP Mon Aug 14 14:14:14 UTC 2023 x86_64 x86_64 x86_64 GNU/Linux 20:08:46 up 3 days, 34 min, 4 users, load average: 0.80, 0.68, 0.74
2023-09-16 > run NEMU 221830012 茆弘之 Linux pc 5.15.0-82-generic #91-Ubuntu SMP Mon Aug 14 14:14:14 UTC 2023 x86_64 x86_64 x86_64 GNU/Linux 20:08:47 up 3 days, 34 min, 4 users, load average: 0.80, 0.68, 0.74
2023-09-16 > compile NEMU 221830012 茆弘之 Linux pc 5.15.0-82-generic #91-Ubuntu SMP Mon Aug 14 14:14:14 UTC 2023 x86_64 x86_64 x86_64 GNU/Linux 20:08:48 up 3 days, 34 min, 4 users, load average: 0.89, 0.71, 0.74
2023-09-16 > run NEMU 221830012 茆弘之 Linux pc 5.15.0-82-generic #91-Ubuntu SMP Mon Aug 14 14:14:14 UTC 2023 x86_64 x86_64 x86_64 GNU/Linux 20:08:48 up 3 days, 34 min, 4 users, load average: 0.89, 0.71, 0.74
2023-09-16 > compile NEMU 221830012 茆弘之 Linux pc 5.15.0-82-generic #91-Ubuntu SMP Mon Aug 14 14:14:14 UTC 2023 x86_64 x86_64 x86_64 GNU/Linux 20:08:49 up 3 days, 34 min, 4 users, load average: 0.89, 0.71, 0.74
2023-09-16 > run NEMU 221830012 茆弘之 Linux pc 5.15.0-82-generic #91-Ubuntu SMP Mon Aug 14 14:14:14 UTC 2023 x86_64 x86_64 x86_64 GNU/Linux 20:08:49 up 3 days, 34 min, 4 users, load average: 0.89, 0.71, 0.74
2023-09-16 > compile NEMU 221830012 茆弘之 Linux pc 5.15.0-82-generic #91-Ubuntu SMP Mon Aug 14 14:14:14 UTC 2023 x86_64 x86_64 x86_64 GNU/Linux 20:08:50 up 3 days, 34 min, 4 users, load average: 0.89, 0.71, 0.74
2023-09-16 > run NEMU 221830012 茆弘之 Linux pc 5.15.0-82-generic #91-Ubuntu SMP Mon Aug 14 14:14:14 UTC 2023 x86_64 x86_64 x86_64 GNU/Linux 20:08:50 up 3 days, 34 min, 4 users, load average: 0.89, 0.71, 0.74
2023-09-16 > compile NEMU 221830012 茆弘之 Linux pc 5.15.0-82-generic #91-Ubuntu SMP Mon Aug 14 14:14:14 UTC 2023 x86_64 x86_64 x86_64 GNU/Linux 20:08:51 up 3 days, 34 min, 4 users, load average: 0.89, 0.71, 0.74
2023-09-16 > run NEMU 221830012 茆弘之 Linux pc 5.15.0-82-generic #91-Ubuntu SMP Mon Aug 14 14:14:14 UTC 2023 x86_64 x86_64 x86_64 GNU/Linux 20:08:52 up 3 days, 34 min, 4 users, load average: 0.89, 0.71, 0.74
2023-09-16 > compile NEMU 221830012 茆弘之 Linux pc 5.15.0-82-generic #91-Ubuntu SMP Mon Aug 14 14:14:14 UTC 2023 x86_64 x86_64 x86_64 GNU/Linux 20:08:52 up 3 days, 34 min, 4 users, load average: 0.90, 0.71, 0.75
2023-09-16 > run NEMU 221830012 茆弘之 Linux pc 5.15.0-82-generic #91-Ubuntu SMP Mon Aug 14 14:14:14 UTC 2023 x86_64 x86_64 x86_64 GNU/Linux 20:08:53 up 3 days, 34 min, 4 users, load average: 0.90, 0.71, 0.75
2023-09-16 > compile NEMU 221830012 茆弘之 Linux pc 5.15.0-82-generic #91-Ubuntu SMP Mon Aug 14 14:14:14 UTC 2023 x86_64 x86_64 x86_64 GNU/Linux 20:08:54 up 3 days, 34 min, 4 users, load average: 0.90, 0.71, 0.75
2023-09-16 > run NEMU 221830012 茆弘之 Linux pc 5.15.0-82-generic #91-Ubuntu SMP Mon Aug 14 14:14:14 UTC 2023 x86_64 x86_64 x86_64 GNU/Linux 20:08:54 up 3 days, 34 min, 4 users, load average: 0.90, 0.71, 0.75
2023-09-16 > compile NEMU 221830012 茆弘之 Linux pc 5.15.0-82-generic #91-Ubuntu SMP Mon Aug 14 14:14:14 UTC 2023 x86_64 x86_64 x86_64 GNU/Linux 20:08:55 up 3 days, 34 min, 4 users, load average: 0.90, 0.71, 0.75
2023-09-16 > run NEMU 221830012 茆弘之 Linux pc 5.15.0-82-generic #91-Ubuntu SMP Mon Aug 14 14:14:14 UTC 2023 x86_64 x86_64 x86_64 GNU/Linux 20:08:55 up 3 days, 34 min, 4 users, load average: 0.90, 0.71, 0.75
2023-09-16 > compile NEMU 221830012 茆弘之 Linux pc 5.15.0-82-generic #91-Ubuntu SMP Mon Aug 14 14:14:14 UTC 2023 x86_64 x86_64 x86_64 GNU/Linux 20:08:56 up 3 days, 34 min, 4 users, load average: 0.90, 0.71, 0.75
2023-09-16 > run NEMU 221830012 茆弘之 Linux pc 5.15.0-82-generic #91-Ubuntu SMP Mon Aug 14 14:14:14 UTC 2023 x86_64 x86_64 x86_64 GNU/Linux 20:08:56 up 3 days, 34 min, 4 users, load average: 0.90, 0.71, 0.75
2023-09-16 > compile NEMU 221830012 茆弘之 Linux pc 5.15.0-82-generic #91-Ubuntu SMP Mon Aug 14 14:14:14 UTC 2023 x86_64 x86_64 x86_64 GNU/Linux 20:08:57 up 3 days, 34 min, 4 users, load average: 1.07, 0.75, 0.76
2023-09-16 > run NEMU 221830012 茆弘之 Linux pc 5.15.0-82-generic #91-Ubuntu SMP Mon Aug 14 14:14:14 UTC 2023 x86_64 x86_64 x86_64 GNU/Linux 20:08:58 up 3 days, 34 min, 4 users, load average: 1.07, 0.75, 0.76
2023-09-16 > compile NEMU 221830012 茆弘之 Linux pc 5.15.0-82-generic #91-Ubuntu SMP Mon Aug 14 14:14:14 UTC 2023 x86_64 x86_64 x86_64 GNU/Linux 20:08:58 up 3 days, 34 min, 4 users, load average: 1.07, 0.75, 0.76
2023-09-16 > run NEMU 221830012 茆弘之 Linux pc 5.15.0-82-generic #91-Ubuntu SMP Mon Aug 14 14:14:14 UTC 2023 x86_64 x86_64 x86_64 GNU/Linux 20:08:59 up 3 days, 34 min, 4 users, load average: 1.07, 0.75, 0.76
2023-09-16 > compile NEMU 221830012 茆弘之 Linux pc 5.15.0-82-generic #91-Ubuntu SMP Mon Aug 14 14:14:14 UTC 2023 x86_64 x86_64 x86_64 GNU/Linux 20:09:00 up 3 days, 34 min, 4 users, load average: 1.07, 0.75, 0.76
2023-09-16 > run NEMU 221830012 茆弘之 Linux pc 5.15.0-82-generic #91-Ubuntu SMP Mon Aug 14 14:14:14 UTC 2023 x86_64 x86_64 x86_64 GNU/Linux 20:09:00 up 3 days, 34 min, 4 users, load average: 1.07, 0.75, 0.76
2023-09-16 > compile NEMU 221830012 茆弘之 Linux pc 5.15.0-82-generic #91-Ubuntu SMP Mon Aug 14 14:14:14 UTC 2023 x86_64 x86_64 x86_64 GNU/Linux 20:09:01 up 3 days, 34 min, 4 users, load average: 1.07, 0.75, 0.76
2023-09-16 > run NEMU 221830012 茆弘之 Linux pc 5.15.0-82-generic #91-Ubuntu SMP Mon Aug 14 14:14:14 UTC 2023 x86_64 x86_64 x86_64 GNU/Linux 20:09:01 up 3 days, 34 min, 4 users, load average: 1.07, 0.75, 0.76
2023-09-16 > compile NEMU 221830012 茆弘之 Linux pc 5.15.0-82-generic #91-Ubuntu SMP Mon Aug 14 14:14:14 UTC 2023 x86_64 x86_64 x86_64 GNU/Linux 20:09:02 up 3 days, 34 min, 4 users, load average: 1.07, 0.75, 0.76
2023-09-16 > run NEMU 221830012 茆弘之 Linux pc 5.15.0-82-generic #91-Ubuntu SMP Mon Aug 14 14:14:14 UTC 2023 x86_64 x86_64 x86_64 GNU/Linux 20:09:02 up 3 days, 34 min, 4 users, load average: 1.06, 0.75, 0.76
2023-09-16 > compile NEMU 221830012 茆弘之 Linux pc 5.15.0-82-generic #91-Ubuntu SMP Mon Aug 14 14:14:14 UTC 2023 x86_64 x86_64 x86_64 GNU/Linux 20:09:03 up 3 days, 34 min, 4 users, load average: 1.06, 0.75, 0.76
2023-09-16 > run NEMU 221830012 茆弘之 Linux pc 5.15.0-82-generic #91-Ubuntu SMP Mon Aug 14 14:14:14 UTC 2023 x86_64 x86_64 x86_64 GNU/Linux 20:09:04 up 3 days, 34 min, 4 users, load average: 1.06, 0.75, 0.76
2023-09-16 > compile NEMU 221830012 茆弘之 Linux pc 5.15.0-82-generic #91-Ubuntu SMP Mon Aug 14 14:14:14 UTC 2023 x86_64 x86_64 x86_64 GNU/Linux 20:09:04 up 3 days, 34 min, 4 users, load average: 1.06, 0.75, 0.76
2023-09-16 > run NEMU 221830012 茆弘之 Linux pc 5.15.0-82-generic #91-Ubuntu SMP Mon Aug 14 14:14:14 UTC 2023 x86_64 x86_64 x86_64 GNU/Linux 20:09:05 up 3 days, 34 min, 4 users, load average: 1.06, 0.75, 0.76
2023-09-16 > compile NEMU 221830012 茆弘之 Linux pc 5.15.0-82-generic #91-Ubuntu SMP Mon Aug 14 14:14:14 UTC 2023 x86_64 x86_64 x86_64 GNU/Linux 20:09:06 up 3 days, 35 min, 4 users, load average: 1.06, 0.75, 0.76
2023-09-16 > run NEMU 221830012 茆弘之 Linux pc 5.15.0-82-generic #91-Ubuntu SMP Mon Aug 14 14:14:14 UTC 2023 x86_64 x86_64 x86_64 GNU/Linux 20:09:06 up 3 days, 35 min, 4 users, load average: 1.06, 0.75, 0.76
2023-09-16 > compile NEMU 221830012 茆弘之 Linux pc 5.15.0-82-generic #91-Ubuntu SMP Mon Aug 14 14:14:14 UTC 2023 x86_64 x86_64 x86_64 GNU/Linux 20:09:07 up 3 days, 35 min, 4 users, load average: 1.06, 0.75, 0.76
2023-09-16 > run NEMU 221830012 茆弘之 Linux pc 5.15.0-82-generic #91-Ubuntu SMP Mon Aug 14 14:14:14 UTC 2023 x86_64 x86_64 x86_64 GNU/Linux 20:09:07 up 3 days, 35 min, 4 users, load average: 1.06, 0.76, 0.76
2023-09-16 > compile NEMU 221830012 茆弘之 Linux pc 5.15.0-82-generic #91-Ubuntu SMP Mon Aug 14 14:14:14 UTC 2023 x86_64 x86_64 x86_64 GNU/Linux 20:09:08 up 3 days, 35 min, 4 users, load average: 1.06, 0.76, 0.76
2023-09-16 > run NEMU 221830012 茆弘之 Linux pc 5.15.0-82-generic #91-Ubuntu SMP Mon Aug 14 14:14:14 UTC 2023 x86_64 x86_64 x86_64 GNU/Linux 20:09:08 up 3 days, 35 min, 4 users, load average: 1.06, 0.76, 0.76
2023-09-16 > compile NEMU 221830012 茆弘之 Linux pc 5.15.0-82-generic #91-Ubuntu SMP Mon Aug 14 14:14:14 UTC 2023 x86_64 x86_64 x86_64 GNU/Linux 20:09:09 up 3 days, 35 min, 4 users, load average: 1.06, 0.76, 0.76
2023-09-16 > run NEMU 221830012 茆弘之 Linux pc 5.15.0-82-generic #91-Ubuntu SMP Mon Aug 14 14:14:14 UTC 2023 x86_64 x86_64 x86_64 GNU/Linux 20:09:10 up 3 days, 35 min, 4 users, load average: 1.06, 0.76, 0.76
2023-09-16 > compile NEMU 221830012 茆弘之 Linux pc 5.15.0-82-generic #91-Ubuntu SMP Mon Aug 14 14:14:14 UTC 2023 x86_64 x86_64 x86_64 GNU/Linux 20:09:10 up 3 days, 35 min, 4 users, load average: 1.06, 0.76, 0.76
2023-09-16 > run NEMU 221830012 茆弘之 Linux pc 5.15.0-82-generic #91-Ubuntu SMP Mon Aug 14 14:14:14 UTC 2023 x86_64 x86_64 x86_64 GNU/Linux 20:09:11 up 3 days, 35 min, 4 users, load average: 1.06, 0.76, 0.76
2023-09-16 > compile NEMU 221830012 茆弘之 Linux pc 5.15.0-82-generic #91-Ubuntu SMP Mon Aug 14 14:14:14 UTC 2023 x86_64 x86_64 x86_64 GNU/Linux 20:09:11 up 3 days, 35 min, 4 users, load average: 1.06, 0.76, 0.76
2023-09-16 > run NEMU 221830012 茆弘之 Linux pc 5.15.0-82-generic #91-Ubuntu SMP Mon Aug 14 14:14:14 UTC 2023 x86_64 x86_64 x86_64 GNU/Linux 20:09:12 up 3 days, 35 min, 4 users, load average: 1.06, 0.76, 0.76
2023-09-16 > compile NEMU 221830012 茆弘之 Linux pc 5.15.0-82-generic #91-Ubuntu SMP Mon Aug 14 14:14:14 UTC 2023 x86_64 x86_64 x86_64 GNU/Linux 20:09:13 up 3 days, 35 min, 4 users, load average: 1.22, 0.80, 0.77
2023-09-16 > run NEMU 221830012 茆弘之 Linux pc 5.15.0-82-generic #91-Ubuntu SMP Mon Aug 14 14:14:14 UTC 2023 x86_64 x86_64 x86_64 GNU/Linux 20:09:13 up 3 days, 35 min, 4 users, load average: 1.22, 0.80, 0.77
2023-09-16 > compile NEMU 221830012 茆弘之 Linux pc 5.15.0-82-generic #91-Ubuntu SMP Mon Aug 14 14:14:14 UTC 2023 x86_64 x86_64 x86_64 GNU/Linux 20:09:14 up 3 days, 35 min, 4 users, load average: 1.22, 0.80, 0.77
2023-09-16 > run NEMU 221830012 茆弘之 Linux pc 5.15.0-82-generic #91-Ubuntu SMP Mon Aug 14 14:14:14 UTC 2023 x86_64 x86_64 x86_64 GNU/Linux 20:09:14 up 3 days, 35 min, 4 users, load average: 1.22, 0.80, 0.77
2023-09-16 > compile NEMU 221830012 茆弘之 Linux pc 5.15.0-82-generic #91-Ubuntu SMP Mon Aug 14 14:14:14 UTC 2023 x86_64 x86_64 x86_64 GNU/Linux 20:09:15 up 3 days, 35 min, 4 users, load average: 1.22, 0.80, 0.77
2023-09-16 > run NEMU 221830012 茆弘之 Linux pc 5.15.0-82-generic #91-Ubuntu SMP Mon Aug 14 14:14:14 UTC 2023 x86_64 x86_64 x86_64 GNU/Linux 20:09:16 up 3 days, 35 min, 4 users, load average: 1.22, 0.80, 0.77
2023-09-16 > compile NEMU 221830012 茆弘之 Linux pc 5.15.0-82-generic #91-Ubuntu SMP Mon Aug 14 14:14:14 UTC 2023 x86_64 x86_64 x86_64 GNU/Linux 20:09:16 up 3 days, 35 min, 4 users, load average: 1.22, 0.80, 0.77
2023-09-16 > run NEMU 221830012 茆弘之 Linux pc 5.15.0-82-generic #91-Ubuntu SMP Mon Aug 14 14:14:14 UTC 2023 x86_64 x86_64 x86_64 GNU/Linux 20:09:17 up 3 days, 35 min, 4 users, load average: 1.22, 0.80, 0.77
2023-09-16 > compile NEMU 221830012 茆弘之 Linux pc 5.15.0-82-generic #91-Ubuntu SMP Mon Aug 14 14:14:14 UTC 2023 x86_64 x86_64 x86_64 GNU/Linux 20:09:17 up 3 days, 35 min, 4 users, load average: 1.20, 0.80, 0.77
2023-09-16 > run NEMU 221830012 茆弘之 Linux pc 5.15.0-82-generic #91-Ubuntu SMP Mon Aug 14 14:14:14 UTC 2023 x86_64 x86_64 x86_64 GNU/Linux 20:09:18 up 3 days, 35 min, 4 users, load average: 1.20, 0.80, 0.77
2023-09-16 > compile NEMU 221830012 茆弘之 Linux pc 5.15.0-82-generic #91-Ubuntu SMP Mon Aug 14 14:14:14 UTC 2023 x86_64 x86_64 x86_64 GNU/Linux 20:09:19 up 3 days, 35 min, 4 users, load average: 1.20, 0.80, 0.77
2023-09-16 > run NEMU 221830012 茆弘之 Linux pc 5.15.0-82-generic #91-Ubuntu SMP Mon Aug 14 14:14:14 UTC 2023 x86_64 x86_64 x86_64 GNU/Linux 20:09:19 up 3 days, 35 min, 4 users, load average: 1.20, 0.80, 0.77
2023-09-16 > compile NEMU 221830012 茆弘之 Linux pc 5.15.0-82-generic #91-Ubuntu SMP Mon Aug 14 14:14:14 UTC 2023 x86_64 x86_64 x86_64 GNU/Linux 20:09:20 up 3 days, 35 min, 4 users, load average: 1.20, 0.80, 0.77
2023-09-16 > compile NEMU 221830012 茆弘之 Linux pc 5.15.0-82-generic #91-Ubuntu SMP Mon Aug 14 14:14:14 UTC 2023 x86_64 x86_64 x86_64 GNU/Linux 20:09:25 up 3 days, 35 min, 4 users, load average: 1.10, 0.79, 0.77
2023-09-16 > compile NEMU 221830012 茆弘之 Linux pc 5.15.0-82-generic #91-Ubuntu SMP Mon Aug 14 14:14:14 UTC 2023 x86_64 x86_64 x86_64 GNU/Linux 20:09:26 up 3 days, 35 min, 4 users, load average: 1.10, 0.79, 0.77
2023-09-16 > run NEMU 221830012 茆弘之 Linux pc 5.15.0-82-generic #91-Ubuntu SMP Mon Aug 14 14:14:14 UTC 2023 x86_64 x86_64 x86_64 GNU/Linux 20:09:30 up 3 days, 35 min, 4 users, load average: 3.74, 1.34, 0.95
2023-09-16 > compile NEMU 221830012 茆弘之 Linux pc 5.15.0-82-generic #91-Ubuntu SMP Mon Aug 14 14:14:14 UTC 2023 x86_64 x86_64 x86_64 GNU/Linux 20:10:02 up 3 days, 35 min, 4 users, load average: 2.33, 1.22, 0.92
2023-09-16 > run NEMU 221830012 茆弘之 Linux pc 5.15.0-82-generic #91-Ubuntu SMP Mon Aug 14 14:14:14 UTC 2023 x86_64 x86_64 x86_64 GNU/Linux 20:10:02 up 3 days, 35 min, 4 users, load average: 2.22, 1.22, 0.92
2023-09-16 > compile NEMU 221830012 茆弘之 Linux pc 5.15.0-82-generic #91-Ubuntu SMP Mon Aug 14 14:14:14 UTC 2023 x86_64 x86_64 x86_64 GNU/Linux 20:10:03 up 3 days, 35 min, 4 users, load average: 2.22, 1.22, 0.92
2023-09-16 > run NEMU 221830012 茆弘之 Linux pc 5.15.0-82-generic #91-Ubuntu SMP Mon Aug 14 14:14:14 UTC 2023 x86_64 x86_64 x86_64 GNU/Linux 20:10:03 up 3 days, 35 min, 4 users, load average: 2.22, 1.22, 0.92
2023-09-16 > compile NEMU 221830012 茆弘之 Linux pc 5.15.0-82-generic #91-Ubuntu SMP Mon Aug 14 14:14:14 UTC 2023 x86_64 x86_64 x86_64 GNU/Linux 20:10:04 up 3 days, 35 min, 4 users, load average: 2.22, 1.22, 0.92
2023-09-16 > run NEMU 221830012 茆弘之 Linux pc 5.15.0-82-generic #91-Ubuntu SMP Mon Aug 14 14:14:14 UTC 2023 x86_64 x86_64 x86_64 GNU/Linux 20:10:05 up 3 days, 35 min, 4 users, load average: 2.22, 1.22, 0.92
2023-09-16 > compile NEMU 221830012 茆弘之 Linux pc 5.15.0-82-generic #91-Ubuntu SMP Mon Aug 14 14:14:14 UTC 2023 x86_64 x86_64 x86_64 GNU/Linux 20:10:05 up 3 days, 36 min, 4 users, load average: 2.22, 1.22, 0.92
2023-09-16 > run NEMU 221830012 茆弘之 Linux pc 5.15.0-82-generic #91-Ubuntu SMP Mon Aug 14 14:14:14 UTC 2023 x86_64 x86_64 x86_64 GNU/Linux 20:10:06 up 3 days, 36 min, 4 users, load average: 2.22, 1.22, 0.92
2023-09-16 > compile NEMU 221830012 茆弘之 Linux pc 5.15.0-82-generic #91-Ubuntu SMP Mon Aug 14 14:14:14 UTC 2023 x86_64 x86_64 x86_64 GNU/Linux 20:10:06 up 3 days, 36 min, 4 users, load average: 2.22, 1.22, 0.92
2023-09-16 > run NEMU 221830012 茆弘之 Linux pc 5.15.0-82-generic #91-Ubuntu SMP Mon Aug 14 14:14:14 UTC 2023 x86_64 x86_64 x86_64 GNU/Linux 20:10:07 up 3 days, 36 min, 4 users, load average: 2.22, 1.22, 0.92
2023-09-16 > compile NEMU 221830012 茆弘之 Linux pc 5.15.0-82-generic #91-Ubuntu SMP Mon Aug 14 14:14:14 UTC 2023 x86_64 x86_64 x86_64 GNU/Linux 20:10:08 up 3 days, 36 min, 4 users, load average: 2.28, 1.25, 0.93
2023-09-16 > run NEMU 221830012 茆弘之 Linux pc 5.15.0-82-generic #91-Ubuntu SMP Mon Aug 14 14:14:14 UTC 2023 x86_64 x86_64 x86_64 GNU/Linux 20:10:08 up 3 days, 36 min, 4 users, load average: 2.28, 1.25, 0.93
2023-09-16 > compile NEMU 221830012 茆弘之 Linux pc 5.15.0-82-generic #91-Ubuntu SMP Mon Aug 14 14:14:14 UTC 2023 x86_64 x86_64 x86_64 GNU/Linux 20:10:09 up 3 days, 36 min, 4 users, load average: 2.28, 1.25, 0.93
2023-09-16 > run NEMU 221830012 茆弘之 Linux pc 5.15.0-82-generic #91-Ubuntu SMP Mon Aug 14 14:14:14 UTC 2023 x86_64 x86_64 x86_64 GNU/Linux 20:10:09 up 3 days, 36 min, 4 users, load average: 2.28, 1.25, 0.93
2023-09-16 > compile NEMU 221830012 茆弘之 Linux pc 5.15.0-82-generic #91-Ubuntu SMP Mon Aug 14 14:14:14 UTC 2023 x86_64 x86_64 x86_64 GNU/Linux 20:10:10 up 3 days, 36 min, 4 users, load average: 2.28, 1.25, 0.93
2023-09-16 > run NEMU 221830012 茆弘之 Linux pc 5.15.0-82-generic #91-Ubuntu SMP Mon Aug 14 14:14:14 UTC 2023 x86_64 x86_64 x86_64 GNU/Linux 20:10:11 up 3 days, 36 min, 4 users, load average: 2.28, 1.25, 0.93
2023-09-16 > compile NEMU 221830012 茆弘之 Linux pc 5.15.0-82-generic #91-Ubuntu SMP Mon Aug 14 14:14:14 UTC 2023 x86_64 x86_64 x86_64 GNU/Linux 20:10:11 up 3 days, 36 min, 4 users, load average: 2.28, 1.25, 0.93
2023-09-16 > run NEMU 221830012 茆弘之 Linux pc 5.15.0-82-generic #91-Ubuntu SMP Mon Aug 14 14:14:14 UTC 2023 x86_64 x86_64 x86_64 GNU/Linux 20:10:12 up 3 days, 36 min, 4 users, load average: 2.28, 1.25, 0.93
2023-09-16 > compile NEMU 221830012 茆弘之 Linux pc 5.15.0-82-generic #91-Ubuntu SMP Mon Aug 14 14:14:14 UTC 2023 x86_64 x86_64 x86_64 GNU/Linux 20:10:12 up 3 days, 36 min, 4 users, load average: 2.18, 1.25, 0.93
2023-09-16 > run NEMU 221830012 茆弘之 Linux pc 5.15.0-82-generic #91-Ubuntu SMP Mon Aug 14 14:14:14 UTC 2023 x86_64 x86_64 x86_64 GNU/Linux 20:10:13 up 3 days, 36 min, 4 users, load average: 2.18, 1.25, 0.93
2023-09-16 > compile NEMU 221830012 茆弘之 Linux pc 5.15.0-82-generic #91-Ubuntu SMP Mon Aug 14 14:14:14 UTC 2023 x86_64 x86_64 x86_64 GNU/Linux 20:10:14 up 3 days, 36 min, 4 users, load average: 2.18, 1.25, 0.93
2023-09-16 > run NEMU 221830012 茆弘之 Linux pc 5.15.0-82-generic #91-Ubuntu SMP Mon Aug 14 14:14:14 UTC 2023 x86_64 x86_64 x86_64 GNU/Linux 20:10:14 up 3 days, 36 min, 4 users, load average: 2.18, 1.25, 0.93
2023-09-16 > compile NEMU 221830012 茆弘之 Linux pc 5.15.0-82-generic #91-Ubuntu SMP Mon Aug 14 14:14:14 UTC 2023 x86_64 x86_64 x86_64 GNU/Linux 20:10:15 up 3 days, 36 min, 4 users, load average: 2.18, 1.25, 0.93
2023-09-16 > run NEMU 221830012 茆弘之 Linux pc 5.15.0-82-generic #91-Ubuntu SMP Mon Aug 14 14:14:14 UTC 2023 x86_64 x86_64 x86_64 GNU/Linux 20:10:15 up 3 days, 36 min, 4 users, load average: 2.18, 1.25, 0.93
2023-09-16 > compile NEMU 221830012 茆弘之 Linux pc 5.15.0-82-generic #91-Ubuntu SMP Mon Aug 14 14:14:14 UTC 2023 x86_64 x86_64 x86_64 GNU/Linux 20:10:16 up 3 days, 36 min, 4 users, load average: 2.18, 1.25, 0.93
2023-09-16 > run NEMU 221830012 茆弘之 Linux pc 5.15.0-82-generic #91-Ubuntu SMP Mon Aug 14 14:14:14 UTC 2023 x86_64 x86_64 x86_64 GNU/Linux 20:10:16 up 3 days, 36 min, 4 users, load average: 2.18, 1.25, 0.93
2023-09-16 > compile NEMU 221830012 茆弘之 Linux pc 5.15.0-82-generic #91-Ubuntu SMP Mon Aug 14 14:14:14 UTC 2023 x86_64 x86_64 x86_64 GNU/Linux 20:10:17 up 3 days, 36 min, 4 users, load average: 2.25, 1.27, 0.95
2023-09-16 > run NEMU 221830012 茆弘之 Linux pc 5.15.0-82-generic #91-Ubuntu SMP Mon Aug 14 14:14:14 UTC 2023 x86_64 x86_64 x86_64 GNU/Linux 20:10:18 up 3 days, 36 min, 4 users, load average: 2.25, 1.27, 0.95
2023-09-16 > compile NEMU 221830012 茆弘之 Linux pc 5.15.0-82-generic #91-Ubuntu SMP Mon Aug 14 14:14:14 UTC 2023 x86_64 x86_64 x86_64 GNU/Linux 20:10:18 up 3 days, 36 min, 4 users, load average: 2.25, 1.27, 0.95
2023-09-16 > run NEMU 221830012 茆弘之 Linux pc 5.15.0-82-generic #91-Ubuntu SMP Mon Aug 14 14:14:14 UTC 2023 x86_64 x86_64 x86_64 GNU/Linux 20:10:19 up 3 days, 36 min, 4 users, load average: 2.25, 1.27, 0.95
2023-09-16 > compile NEMU 221830012 茆弘之 Linux pc 5.15.0-82-generic #91-Ubuntu SMP Mon Aug 14 14:14:14 UTC 2023 x86_64 x86_64 x86_64 GNU/Linux 20:10:19 up 3 days, 36 min, 4 users, load average: 2.25, 1.27, 0.95
2023-09-16 > run NEMU 221830012 茆弘之 Linux pc 5.15.0-82-generic #91-Ubuntu SMP Mon Aug 14 14:14:14 UTC 2023 x86_64 x86_64 x86_64 GNU/Linux 20:10:20 up 3 days, 36 min, 4 users, load average: 2.25, 1.27, 0.95
2023-09-16 > compile NEMU 221830012 茆弘之 Linux pc 5.15.0-82-generic #91-Ubuntu SMP Mon Aug 14 14:14:14 UTC 2023 x86_64 x86_64 x86_64 GNU/Linux 20:10:21 up 3 days, 36 min, 4 users, load average: 2.25, 1.27, 0.95
2023-09-16 > run NEMU 221830012 茆弘之 Linux pc 5.15.0-82-generic #91-Ubuntu SMP Mon Aug 14 14:14:14 UTC 2023 x86_64 x86_64 x86_64 GNU/Linux 20:10:21 up 3 days, 36 min, 4 users, load average: 2.25, 1.27, 0.95
2023-09-16 > compile NEMU 221830012 茆弘之 Linux pc 5.15.0-82-generic #91-Ubuntu SMP Mon Aug 14 14:14:14 UTC 2023 x86_64 x86_64 x86_64 GNU/Linux 20:10:22 up 3 days, 36 min, 4 users, load average: 2.25, 1.27, 0.95
2023-09-16 > run NEMU 221830012 茆弘之 Linux pc 5.15.0-82-generic #91-Ubuntu SMP Mon Aug 14 14:14:14 UTC 2023 x86_64 x86_64 x86_64 GNU/Linux 20:10:22 up 3 days, 36 min, 4 users, load average: 2.14, 1.27, 0.95
2023-09-16 > compile NEMU 221830012 茆弘之 Linux pc 5.15.0-82-generic #91-Ubuntu SMP Mon Aug 14 14:14:14 UTC 2023 x86_64 x86_64 x86_64 GNU/Linux 20:10:23 up 3 days, 36 min, 4 users, load average: 2.14, 1.27, 0.95
2023-09-16 > run NEMU 221830012 茆弘之 Linux pc 5.15.0-82-generic #91-Ubuntu SMP Mon Aug 14 14:14:14 UTC 2023 x86_64 x86_64 x86_64 GNU/Linux 20:10:24 up 3 days, 36 min, 4 users, load average: 2.14, 1.27, 0.95
2023-09-16 > compile NEMU 221830012 茆弘之 Linux pc 5.15.0-82-generic #91-Ubuntu SMP Mon Aug 14 14:14:14 UTC 2023 x86_64 x86_64 x86_64 GNU/Linux 20:10:24 up 3 days, 36 min, 4 users, load average: 2.14, 1.27, 0.95
2023-09-16 > run NEMU 221830012 茆弘之 Linux pc 5.15.0-82-generic #91-Ubuntu SMP Mon Aug 14 14:14:14 UTC 2023 x86_64 x86_64 x86_64 GNU/Linux 20:10:25 up 3 days, 36 min, 4 users, load average: 2.14, 1.27, 0.95
2023-09-16 > compile NEMU 221830012 茆弘之 Linux pc 5.15.0-82-generic #91-Ubuntu SMP Mon Aug 14 14:14:14 UTC 2023 x86_64 x86_64 x86_64 GNU/Linux 20:10:25 up 3 days, 36 min, 4 users, load average: 2.14, 1.27, 0.95
2023-09-16 > run NEMU 221830012 茆弘之 Linux pc 5.15.0-82-generic #91-Ubuntu SMP Mon Aug 14 14:14:14 UTC 2023 x86_64 x86_64 x86_64 GNU/Linux 20:10:26 up 3 days, 36 min, 4 users, load average: 2.14, 1.27, 0.95
2023-09-16 > compile NEMU 221830012 茆弘之 Linux pc 5.15.0-82-generic #91-Ubuntu SMP Mon Aug 14 14:14:14 UTC 2023 x86_64 x86_64 x86_64 GNU/Linux 20:10:27 up 3 days, 36 min, 4 users, load average: 2.14, 1.27, 0.95
2023-09-16 > run NEMU 221830012 茆弘之 Linux pc 5.15.0-82-generic #91-Ubuntu SMP Mon Aug 14 14:14:14 UTC 2023 x86_64 x86_64 x86_64 GNU/Linux 20:10:27 up 3 days, 36 min, 4 users, load average: 2.05, 1.26, 0.95
2023-09-16 > compile NEMU 221830012 茆弘之 Linux pc 5.15.0-82-generic #91-Ubuntu SMP Mon Aug 14 14:14:14 UTC 2023 x86_64 x86_64 x86_64 GNU/Linux 20:10:28 up 3 days, 36 min, 4 users, load average: 2.05, 1.26, 0.95
2023-09-16 > run NEMU 221830012 茆弘之 Linux pc 5.15.0-82-generic #91-Ubuntu SMP Mon Aug 14 14:14:14 UTC 2023 x86_64 x86_64 x86_64 GNU/Linux 20:10:28 up 3 days, 36 min, 4 users, load average: 2.05, 1.26, 0.95
2023-09-16 > compile NEMU 221830012 茆弘之 Linux pc 5.15.0-82-generic #91-Ubuntu SMP Mon Aug 14 14:14:14 UTC 2023 x86_64 x86_64 x86_64 GNU/Linux 20:10:29 up 3 days, 36 min, 4 users, load average: 2.05, 1.26, 0.95
2023-09-16 > run NEMU 221830012 茆弘之 Linux pc 5.15.0-82-generic #91-Ubuntu SMP Mon Aug 14 14:14:14 UTC 2023 x86_64 x86_64 x86_64 GNU/Linux 20:10:29 up 3 days, 36 min, 4 users, load average: 2.05, 1.26, 0.95
2023-09-16 > compile NEMU 221830012 茆弘之 Linux pc 5.15.0-82-generic #91-Ubuntu SMP Mon Aug 14 14:14:14 UTC 2023 x86_64 x86_64 x86_64 GNU/Linux 20:10:30 up 3 days, 36 min, 4 users, load average: 2.05, 1.26, 0.95
2023-09-16 > run NEMU 221830012 茆弘之 Linux pc 5.15.0-82-generic #91-Ubuntu SMP Mon Aug 14 14:14:14 UTC 2023 x86_64 x86_64 x86_64 GNU/Linux 20:10:31 up 3 days, 36 min, 4 users, load average: 2.05, 1.26, 0.95
2023-09-16 > compile NEMU 221830012 茆弘之 Linux pc 5.15.0-82-generic #91-Ubuntu SMP Mon Aug 14 14:14:14 UTC 2023 x86_64 x86_64 x86_64 GNU/Linux 20:10:31 up 3 days, 36 min, 4 users, load average: 2.05, 1.26, 0.95
2023-09-16 > run NEMU 221830012 茆弘之 Linux pc 5.15.0-82-generic #91-Ubuntu SMP Mon Aug 14 14:14:14 UTC 2023 x86_64 x86_64 x86_64 GNU/Linux 20:10:32 up 3 days, 36 min, 4 users, load average: 2.05, 1.26, 0.95
2023-09-16 > compile NEMU 221830012 茆弘之 Linux pc 5.15.0-82-generic #91-Ubuntu SMP Mon Aug 14 14:14:14 UTC 2023 x86_64 x86_64 x86_64 GNU/Linux 20:10:33 up 3 days, 36 min, 4 users, load average: 1.97, 1.26, 0.95
2023-09-16 > run NEMU 221830012 茆弘之 Linux pc 5.15.0-82-generic #91-Ubuntu SMP Mon Aug 14 14:14:14 UTC 2023 x86_64 x86_64 x86_64 GNU/Linux 20:10:33 up 3 days, 36 min, 4 users, load average: 1.97, 1.26, 0.95
2023-09-16 > compile NEMU 221830012 茆弘之 Linux pc 5.15.0-82-generic #91-Ubuntu SMP Mon Aug 14 14:14:14 UTC 2023 x86_64 x86_64 x86_64 GNU/Linux 20:10:34 up 3 days, 36 min, 4 users, load average: 1.97, 1.26, 0.95
2023-09-16 > run NEMU 221830012 茆弘之 Linux pc 5.15.0-82-generic #91-Ubuntu SMP Mon Aug 14 14:14:14 UTC 2023 x86_64 x86_64 x86_64 GNU/Linux 20:10:34 up 3 days, 36 min, 4 users, load average: 1.97, 1.26, 0.95
2023-09-16 > compile NEMU 221830012 茆弘之 Linux pc 5.15.0-82-generic #91-Ubuntu SMP Mon Aug 14 14:14:14 UTC 2023 x86_64 x86_64 x86_64 GNU/Linux 20:10:35 up 3 days, 36 min, 4 users, load average: 1.97, 1.26, 0.95
2023-09-16 > run NEMU 221830012 茆弘之 Linux pc 5.15.0-82-generic #91-Ubuntu SMP Mon Aug 14 14:14:14 UTC 2023 x86_64 x86_64 x86_64 GNU/Linux 20:10:35 up 3 days, 36 min, 4 users, load average: 1.97, 1.26, 0.95
2023-09-16 > compile NEMU 221830012 茆弘之 Linux pc 5.15.0-82-generic #91-Ubuntu SMP Mon Aug 14 14:14:14 UTC 2023 x86_64 x86_64 x86_64 GNU/Linux 20:10:36 up 3 days, 36 min, 4 users, load average: 1.97, 1.26, 0.95
2023-09-16 > run NEMU 221830012 茆弘之 Linux pc 5.15.0-82-generic #91-Ubuntu SMP Mon Aug 14 14:14:14 UTC 2023 x86_64 x86_64 x86_64 GNU/Linux 20:10:37 up 3 days, 36 min, 4 users, load average: 1.97, 1.26, 0.95
2023-09-16 > compile NEMU 221830012 茆弘之 Linux pc 5.15.0-82-generic #91-Ubuntu SMP Mon Aug 14 14:14:14 UTC 2023 x86_64 x86_64 x86_64 GNU/Linux 20:10:37 up 3 days, 36 min, 4 users, load average: 1.89, 1.26, 0.95
2023-09-16 > run NEMU 221830012 茆弘之 Linux pc 5.15.0-82-generic #91-Ubuntu SMP Mon Aug 14 14:14:14 UTC 2023 x86_64 x86_64 x86_64 GNU/Linux 20:10:38 up 3 days, 36 min, 4 users, load average: 1.89, 1.26, 0.95
2023-09-16 > compile NEMU 221830012 茆弘之 Linux pc 5.15.0-82-generic #91-Ubuntu SMP Mon Aug 14 14:14:14 UTC 2023 x86_64 x86_64 x86_64 GNU/Linux 20:10:38 up 3 days, 36 min, 4 users, load average: 1.89, 1.26, 0.95
2023-09-16 > run NEMU 221830012 茆弘之 Linux pc 5.15.0-82-generic #91-Ubuntu SMP Mon Aug 14 14:14:14 UTC 2023 x86_64 x86_64 x86_64 GNU/Linux 20:10:39 up 3 days, 36 min, 4 users, load average: 1.89, 1.26, 0.95
2023-09-16 > compile NEMU 221830012 茆弘之 Linux pc 5.15.0-82-generic #91-Ubuntu SMP Mon Aug 14 14:14:14 UTC 2023 x86_64 x86_64 x86_64 GNU/Linux 20:10:40 up 3 days, 36 min, 4 users, load average: 1.89, 1.26, 0.95
2023-09-16 > run NEMU 221830012 茆弘之 Linux pc 5.15.0-82-generic #91-Ubuntu SMP Mon Aug 14 14:14:14 UTC 2023 x86_64 x86_64 x86_64 GNU/Linux 20:10:40 up 3 days, 36 min, 4 users, load average: 1.89, 1.26, 0.95
2023-09-16 > compile NEMU 221830012 茆弘之 Linux pc 5.15.0-82-generic #91-Ubuntu SMP Mon Aug 14 14:14:14 UTC 2023 x86_64 x86_64 x86_64 GNU/Linux 20:10:41 up 3 days, 36 min, 4 users, load average: 1.89, 1.26, 0.95
2023-09-16 > run NEMU 221830012 茆弘之 Linux pc 5.15.0-82-generic #91-Ubuntu SMP Mon Aug 14 14:14:14 UTC 2023 x86_64 x86_64 x86_64 GNU/Linux 20:10:41 up 3 days, 36 min, 4 users, load average: 1.89, 1.26, 0.95
2023-09-16 > compile NEMU 221830012 茆弘之 Linux pc 5.15.0-82-generic #91-Ubuntu SMP Mon Aug 14 14:14:14 UTC 2023 x86_64 x86_64 x86_64 GNU/Linux 20:10:42 up 3 days, 36 min, 4 users, load average: 1.89, 1.26, 0.95
2023-09-16 > run NEMU 221830012 茆弘之 Linux pc 5.15.0-82-generic #91-Ubuntu SMP Mon Aug 14 14:14:14 UTC 2023 x86_64 x86_64 x86_64 GNU/Linux 20:10:43 up 3 days, 36 min, 4 users, load average: 1.90, 1.27, 0.95
2023-09-16 > compile NEMU 221830012 茆弘之 Linux pc 5.15.0-82-generic #91-Ubuntu SMP Mon Aug 14 14:14:14 UTC 2023 x86_64 x86_64 x86_64 GNU/Linux 20:52:41 up 3 days, 1:18, 4 users, load average: 0.28, 0.35, 0.61
2023-09-16 > run NEMU 221830012 茆弘之 Linux pc 5.15.0-82-generic #91-Ubuntu SMP Mon Aug 14 14:14:14 UTC 2023 x86_64 x86_64 x86_64 GNU/Linux 20:52:42 up 3 days, 1:18, 4 users, load average: 0.28, 0.35, 0.61
2023-09-16 > compile NEMU 221830012 茆弘之 Linux pc 5.15.0-82-generic #91-Ubuntu SMP Mon Aug 14 14:14:14 UTC 2023 x86_64 x86_64 x86_64 GNU/Linux 20:53:54 up 3 days, 1:19, 4 users, load average: 0.67, 0.45, 0.62
2023-09-16 > run NEMU 221830012 茆弘之 Linux pc 5.15.0-82-generic #91-Ubuntu SMP Mon Aug 14 14:14:14 UTC 2023 x86_64 x86_64 x86_64 GNU/Linux 20:53:55 up 3 days, 1:19, 4 users, load average: 0.67, 0.45, 0.62
2023-09-16 > compile NEMU 221830012 茆弘之 Linux pc 5.15.0-82-generic #91-Ubuntu SMP Mon Aug 14 14:14:14 UTC 2023 x86_64 x86_64 x86_64 GNU/Linux 20:54:39 up 3 days, 1:20, 4 users, load average: 0.73, 0.50, 0.64
2023-09-16 > run NEMU 221830012 茆弘之 Linux pc 5.15.0-82-generic #91-Ubuntu SMP Mon Aug 14 14:14:14 UTC 2023 x86_64 x86_64 x86_64 GNU/Linux 20:54:39 up 3 days, 1:20, 4 users, load average: 0.76, 0.51, 0.64
2023-09-16 > compile NEMU 221830012 茆弘之 Linux pc 5.15.0-82-generic #91-Ubuntu SMP Mon Aug 14 14:14:14 UTC 2023 x86_64 x86_64 x86_64 GNU/Linux 21:00:56 up 3 days, 1:26, 4 users, load average: 0.46, 0.59, 0.64
2023-09-16 > run NEMU 221830012 茆弘之 Linux pc 5.15.0-82-generic #91-Ubuntu SMP Mon Aug 14 14:14:14 UTC 2023 x86_64 x86_64 x86_64 GNU/Linux 21:00:57 up 3 days, 1:26, 4 users, load average: 0.46, 0.59, 0.64
2023-09-16 > compile NEMU 221830012 茆弘之 Linux pc 5.15.0-82-generic #91-Ubuntu SMP Mon Aug 14 14:14:14 UTC 2023 x86_64 x86_64 x86_64 GNU/Linux 21:01:06 up 3 days, 1:27, 4 users, load average: 0.39, 0.57, 0.63
2023-09-16 > run NEMU 221830012 茆弘之 Linux pc 5.15.0-82-generic #91-Ubuntu SMP Mon Aug 14 14:14:14 UTC 2023 x86_64 x86_64 x86_64 GNU/Linux 21:01:07 up 3 days, 1:27, 4 users, load average: 0.39, 0.57, 0.63
2023-09-16 > compile NEMU 221830012 茆弘之 Linux pc 5.15.0-82-generic #91-Ubuntu SMP Mon Aug 14 14:14:14 UTC 2023 x86_64 x86_64 x86_64 GNU/Linux 21:25:59 up 3 days, 1:51, 4 users, load average: 0.37, 0.69, 0.71
2023-09-16 > run NEMU 221830012 茆弘之 Linux pc 5.15.0-82-generic #91-Ubuntu SMP Mon Aug 14 14:14:14 UTC 2023 x86_64 x86_64 x86_64 GNU/Linux 21:25:59 up 3 days, 1:51, 4 users, load average: 0.37, 0.69, 0.71
2023-09-16 > compile NEMU 221830012 茆弘之 Linux pc 5.15.0-82-generic #91-Ubuntu SMP Mon Aug 14 14:14:14 UTC 2023 x86_64 x86_64 x86_64 GNU/Linux 21:26:00 up 3 days, 1:51, 4 users, load average: 0.37, 0.69, 0.71
2023-09-16 > run NEMU 221830012 茆弘之 Linux pc 5.15.0-82-generic #91-Ubuntu SMP Mon Aug 14 14:14:14 UTC 2023 x86_64 x86_64 x86_64 GNU/Linux 21:26:01 up 3 days, 1:51, 4 users, load average: 0.37, 0.69, 0.71
2023-09-16 > compile NEMU 221830012 茆弘之 Linux pc 5.15.0-82-generic #91-Ubuntu SMP Mon Aug 14 14:14:14 UTC 2023 x86_64 x86_64 x86_64 GNU/Linux 21:26:01 up 3 days, 1:51, 4 users, load average: 0.50, 0.71, 0.72
2023-09-16 > run NEMU 221830012 茆弘之 Linux pc 5.15.0-82-generic #91-Ubuntu SMP Mon Aug 14 14:14:14 UTC 2023 x86_64 x86_64 x86_64 GNU/Linux 21:26:02 up 3 days, 1:51, 4 users, load average: 0.50, 0.71, 0.72
2023-09-16 > compile NEMU 221830012 茆弘之 Linux pc 5.15.0-82-generic #91-Ubuntu SMP Mon Aug 14 14:14:14 UTC 2023 x86_64 x86_64 x86_64 GNU/Linux 21:26:02 up 3 days, 1:51, 4 users, load average: 0.50, 0.71, 0.72
2023-09-16 > run NEMU 221830012 茆弘之 Linux pc 5.15.0-82-generic #91-Ubuntu SMP Mon Aug 14 14:14:14 UTC 2023 x86_64 x86_64 x86_64 GNU/Linux 21:26:03 up 3 days, 1:51, 4 users, load average: 0.50, 0.71, 0.72
2023-09-16 > compile NEMU 221830012 茆弘之 Linux pc 5.15.0-82-generic #91-Ubuntu SMP Mon Aug 14 14:14:14 UTC 2023 x86_64 x86_64 x86_64 GNU/Linux 21:26:04 up 3 days, 1:51, 4 users, load average: 0.50, 0.71, 0.72
2023-09-16 > run NEMU 221830012 茆弘之 Linux pc 5.15.0-82-generic #91-Ubuntu SMP Mon Aug 14 14:14:14 UTC 2023 x86_64 x86_64 x86_64 GNU/Linux 21:26:04 up 3 days, 1:51, 4 users, load average: 0.50, 0.71, 0.72
2023-09-16 > compile NEMU 221830012 茆弘之 Linux pc 5.15.0-82-generic #91-Ubuntu SMP Mon Aug 14 14:14:14 UTC 2023 x86_64 x86_64 x86_64 GNU/Linux 21:26:05 up 3 days, 1:51, 4 users, load average: 0.50, 0.71, 0.72
2023-09-16 > run NEMU 221830012 茆弘之 Linux pc 5.15.0-82-generic #91-Ubuntu SMP Mon Aug 14 14:14:14 UTC 2023 x86_64 x86_64 x86_64 GNU/Linux 21:26:05 up 3 days, 1:52, 4 users, load average: 0.50, 0.71, 0.72
2023-09-16 > compile NEMU 221830012 茆弘之 Linux pc 5.15.0-82-generic #91-Ubuntu SMP Mon Aug 14 14:14:14 UTC 2023 x86_64 x86_64 x86_64 GNU/Linux 21:26:06 up 3 days, 1:52, 4 users, load average: 0.62, 0.74, 0.73
2023-09-16 > run NEMU 221830012 茆弘之 Linux pc 5.15.0-82-generic #91-Ubuntu SMP Mon Aug 14 14:14:14 UTC 2023 x86_64 x86_64 x86_64 GNU/Linux 21:26:07 up 3 days, 1:52, 4 users, load average: 0.62, 0.74, 0.73
2023-09-16 > compile NEMU 221830012 茆弘之 Linux pc 5.15.0-82-generic #91-Ubuntu SMP Mon Aug 14 14:14:14 UTC 2023 x86_64 x86_64 x86_64 GNU/Linux 21:26:07 up 3 days, 1:52, 4 users, load average: 0.62, 0.74, 0.73
2023-09-16 > run NEMU 221830012 茆弘之 Linux pc 5.15.0-82-generic #91-Ubuntu SMP Mon Aug 14 14:14:14 UTC 2023 x86_64 x86_64 x86_64 GNU/Linux 21:26:08 up 3 days, 1:52, 4 users, load average: 0.62, 0.74, 0.73
2023-09-16 > compile NEMU 221830012 茆弘之 Linux pc 5.15.0-82-generic #91-Ubuntu SMP Mon Aug 14 14:14:14 UTC 2023 x86_64 x86_64 x86_64 GNU/Linux 21:26:08 up 3 days, 1:52, 4 users, load average: 0.62, 0.74, 0.73
2023-09-16 > run NEMU 221830012 茆弘之 Linux pc 5.15.0-82-generic #91-Ubuntu SMP Mon Aug 14 14:14:14 UTC 2023 x86_64 x86_64 x86_64 GNU/Linux 21:26:09 up 3 days, 1:52, 4 users, load average: 0.62, 0.74, 0.73
2023-09-16 > compile NEMU 221830012 茆弘之 Linux pc 5.15.0-82-generic #91-Ubuntu SMP Mon Aug 14 14:14:14 UTC 2023 x86_64 x86_64 x86_64 GNU/Linux 21:26:10 up 3 days, 1:52, 4 users, load average: 0.62, 0.74, 0.73
2023-09-16 > run NEMU 221830012 茆弘之 Linux pc 5.15.0-82-generic #91-Ubuntu SMP Mon Aug 14 14:14:14 UTC 2023 x86_64 x86_64 x86_64 GNU/Linux 21:26:10 up 3 days, 1:52, 4 users, load average: 0.62, 0.74, 0.73
2023-09-16 > compile NEMU 221830012 茆弘之 Linux pc 5.15.0-82-generic #91-Ubuntu SMP Mon Aug 14 14:14:14 UTC 2023 x86_64 x86_64 x86_64 GNU/Linux 21:26:11 up 3 days, 1:52, 4 users, load average: 0.81, 0.77, 0.74
2023-09-16 > run NEMU 221830012 茆弘之 Linux pc 5.15.0-82-generic #91-Ubuntu SMP Mon Aug 14 14:14:14 UTC 2023 x86_64 x86_64 x86_64 GNU/Linux 21:26:11 up 3 days, 1:52, 4 users, load average: 0.81, 0.77, 0.74
2023-09-16 > compile NEMU 221830012 茆弘之 Linux pc 5.15.0-82-generic #91-Ubuntu SMP Mon Aug 14 14:14:14 UTC 2023 x86_64 x86_64 x86_64 GNU/Linux 21:26:12 up 3 days, 1:52, 4 users, load average: 0.81, 0.77, 0.74
2023-09-16 > run NEMU 221830012 茆弘之 Linux pc 5.15.0-82-generic #91-Ubuntu SMP Mon Aug 14 14:14:14 UTC 2023 x86_64 x86_64 x86_64 GNU/Linux 21:26:12 up 3 days, 1:52, 4 users, load average: 0.81, 0.77, 0.74
2023-09-16 > compile NEMU 221830012 茆弘之 Linux pc 5.15.0-82-generic #91-Ubuntu SMP Mon Aug 14 14:14:14 UTC 2023 x86_64 x86_64 x86_64 GNU/Linux 21:26:13 up 3 days, 1:52, 4 users, load average: 0.81, 0.77, 0.74
2023-09-16 > run NEMU 221830012 茆弘之 Linux pc 5.15.0-82-generic #91-Ubuntu SMP Mon Aug 14 14:14:14 UTC 2023 x86_64 x86_64 x86_64 GNU/Linux 21:26:14 up 3 days, 1:52, 4 users, load average: 0.81, 0.77, 0.74
2023-09-16 > compile NEMU 221830012 茆弘之 Linux pc 5.15.0-82-generic #91-Ubuntu SMP Mon Aug 14 14:14:14 UTC 2023 x86_64 x86_64 x86_64 GNU/Linux 21:26:14 up 3 days, 1:52, 4 users, load average: 0.81, 0.77, 0.74
2023-09-16 > run NEMU 221830012 茆弘之 Linux pc 5.15.0-82-generic #91-Ubuntu SMP Mon Aug 14 14:14:14 UTC 2023 x86_64 x86_64 x86_64 GNU/Linux 21:26:15 up 3 days, 1:52, 4 users, load average: 0.81, 0.77, 0.74
2023-09-16 > compile NEMU 221830012 茆弘之 Linux pc 5.15.0-82-generic #91-Ubuntu SMP Mon Aug 14 14:14:14 UTC 2023 x86_64 x86_64 x86_64 GNU/Linux 21:26:15 up 3 days, 1:52, 4 users, load average: 0.81, 0.77, 0.74
2023-09-16 > run NEMU 221830012 茆弘之 Linux pc 5.15.0-82-generic #91-Ubuntu SMP Mon Aug 14 14:14:14 UTC 2023 x86_64 x86_64 x86_64 GNU/Linux 21:26:16 up 3 days, 1:52, 4 users, load average: 0.83, 0.78, 0.74
2023-09-16 > compile NEMU 221830012 茆弘之 Linux pc 5.15.0-82-generic #91-Ubuntu SMP Mon Aug 14 14:14:14 UTC 2023 x86_64 x86_64 x86_64 GNU/Linux 21:26:17 up 3 days, 1:52, 4 users, load average: 0.83, 0.78, 0.74
2023-09-16 > run NEMU 221830012 茆弘之 Linux pc 5.15.0-82-generic #91-Ubuntu SMP Mon Aug 14 14:14:14 UTC 2023 x86_64 x86_64 x86_64 GNU/Linux 21:26:17 up 3 days, 1:52, 4 users, load average: 0.83, 0.78, 0.74
2023-09-16 > compile NEMU 221830012 茆弘之 Linux pc 5.15.0-82-generic #91-Ubuntu SMP Mon Aug 14 14:14:14 UTC 2023 x86_64 x86_64 x86_64 GNU/Linux 21:26:18 up 3 days, 1:52, 4 users, load average: 0.83, 0.78, 0.74
2023-09-16 > run NEMU 221830012 茆弘之 Linux pc 5.15.0-82-generic #91-Ubuntu SMP Mon Aug 14 14:14:14 UTC 2023 x86_64 x86_64 x86_64 GNU/Linux 21:26:18 up 3 days, 1:52, 4 users, load average: 0.83, 0.78, 0.74
2023-09-16 > compile NEMU 221830012 茆弘之 Linux pc 5.15.0-82-generic #91-Ubuntu SMP Mon Aug 14 14:14:14 UTC 2023 x86_64 x86_64 x86_64 GNU/Linux 21:26:19 up 3 days, 1:52, 4 users, load average: 0.83, 0.78, 0.74
2023-09-16 > run NEMU 221830012 茆弘之 Linux pc 5.15.0-82-generic #91-Ubuntu SMP Mon Aug 14 14:14:14 UTC 2023 x86_64 x86_64 x86_64 GNU/Linux 21:26:19 up 3 days, 1:52, 4 users, load average: 0.83, 0.78, 0.74
2023-09-16 > compile NEMU 221830012 茆弘之 Linux pc 5.15.0-82-generic #91-Ubuntu SMP Mon Aug 14 14:14:14 UTC 2023 x86_64 x86_64 x86_64 GNU/Linux 21:26:20 up 3 days, 1:52, 4 users, load average: 0.83, 0.78, 0.74
2023-09-16 > run NEMU 221830012 茆弘之 Linux pc 5.15.0-82-generic #91-Ubuntu SMP Mon Aug 14 14:14:14 UTC 2023 x86_64 x86_64 x86_64 GNU/Linux 21:26:21 up 3 days, 1:52, 4 users, load average: 0.92, 0.80, 0.75
2023-09-16 > compile NEMU 221830012 茆弘之 Linux pc 5.15.0-82-generic #91-Ubuntu SMP Mon Aug 14 14:14:14 UTC 2023 x86_64 x86_64 x86_64 GNU/Linux 21:26:21 up 3 days, 1:52, 4 users, load average: 0.92, 0.80, 0.75
2023-09-16 > run NEMU 221830012 茆弘之 Linux pc 5.15.0-82-generic #91-Ubuntu SMP Mon Aug 14 14:14:14 UTC 2023 x86_64 x86_64 x86_64 GNU/Linux 21:26:22 up 3 days, 1:52, 4 users, load average: 0.92, 0.80, 0.75
2023-09-16 > compile NEMU 221830012 茆弘之 Linux pc 5.15.0-82-generic #91-Ubuntu SMP Mon Aug 14 14:14:14 UTC 2023 x86_64 x86_64 x86_64 GNU/Linux 21:26:23 up 3 days, 1:52, 4 users, load average: 0.92, 0.80, 0.75
2023-09-16 > run NEMU 221830012 茆弘之 Linux pc 5.15.0-82-generic #91-Ubuntu SMP Mon Aug 14 14:14:14 UTC 2023 x86_64 x86_64 x86_64 GNU/Linux 21:26:23 up 3 days, 1:52, 4 users, load average: 0.92, 0.80, 0.75
2023-09-16 > compile NEMU 221830012 茆弘之 Linux pc 5.15.0-82-generic #91-Ubuntu SMP Mon Aug 14 14:14:14 UTC 2023 x86_64 x86_64 x86_64 GNU/Linux 21:26:24 up 3 days, 1:52, 4 users, load average: 0.92, 0.80, 0.75
2023-09-16 > run NEMU 221830012 茆弘之 Linux pc 5.15.0-82-generic #91-Ubuntu SMP Mon Aug 14 14:14:14 UTC 2023 x86_64 x86_64 x86_64 GNU/Linux 21:26:24 up 3 days, 1:52, 4 users, load average: 0.92, 0.80, 0.75
2023-09-16 > compile NEMU 221830012 茆弘之 Linux pc 5.15.0-82-generic #91-Ubuntu SMP Mon Aug 14 14:14:14 UTC 2023 x86_64 x86_64 x86_64 GNU/Linux 21:26:25 up 3 days, 1:52, 4 users, load average: 0.92, 0.80, 0.75
2023-09-16 > run NEMU 221830012 茆弘之 Linux pc 5.15.0-82-generic #91-Ubuntu SMP Mon Aug 14 14:14:14 UTC 2023 x86_64 x86_64 x86_64 GNU/Linux 21:26:25 up 3 days, 1:52, 4 users, load average: 0.92, 0.80, 0.75
2023-09-16 > compile NEMU 221830012 茆弘之 Linux pc 5.15.0-82-generic #91-Ubuntu SMP Mon Aug 14 14:14:14 UTC 2023 x86_64 x86_64 x86_64 GNU/Linux 21:26:26 up 3 days, 1:52, 4 users, load average: 0.93, 0.80, 0.75
2023-09-16 > run NEMU 221830012 茆弘之 Linux pc 5.15.0-82-generic #91-Ubuntu SMP Mon Aug 14 14:14:14 UTC 2023 x86_64 x86_64 x86_64 GNU/Linux 21:26:27 up 3 days, 1:52, 4 users, load average: 0.93, 0.80, 0.75
2023-09-16 > compile NEMU 221830012 茆弘之 Linux pc 5.15.0-82-generic #91-Ubuntu SMP Mon Aug 14 14:14:14 UTC 2023 x86_64 x86_64 x86_64 GNU/Linux 21:26:27 up 3 days, 1:52, 4 users, load average: 0.93, 0.80, 0.75
2023-09-16 > run NEMU 221830012 茆弘之 Linux pc 5.15.0-82-generic #91-Ubuntu SMP Mon Aug 14 14:14:14 UTC 2023 x86_64 x86_64 x86_64 GNU/Linux 21:26:28 up 3 days, 1:52, 4 users, load average: 0.93, 0.80, 0.75
2023-09-16 > compile NEMU 221830012 茆弘之 Linux pc 5.15.0-82-generic #91-Ubuntu SMP Mon Aug 14 14:14:14 UTC 2023 x86_64 x86_64 x86_64 GNU/Linux 21:26:28 up 3 days, 1:52, 4 users, load average: 0.93, 0.80, 0.75
2023-09-16 > run NEMU 221830012 茆弘之 Linux pc 5.15.0-82-generic #91-Ubuntu SMP Mon Aug 14 14:14:14 UTC 2023 x86_64 x86_64 x86_64 GNU/Linux 21:26:29 up 3 days, 1:52, 4 users, load average: 0.93, 0.80, 0.75
2023-09-16 > compile NEMU 221830012 茆弘之 Linux pc 5.15.0-82-generic #91-Ubuntu SMP Mon Aug 14 14:14:14 UTC 2023 x86_64 x86_64 x86_64 GNU/Linux 21:26:30 up 3 days, 1:52, 4 users, load average: 0.93, 0.80, 0.75
2023-09-16 > run NEMU 221830012 茆弘之 Linux pc 5.15.0-82-generic #91-Ubuntu SMP Mon Aug 14 14:14:14 UTC 2023 x86_64 x86_64 x86_64 GNU/Linux 21:26:30 up 3 days, 1:52, 4 users, load average: 0.93, 0.80, 0.75
2023-09-16 > compile NEMU 221830012 茆弘之 Linux pc 5.15.0-82-generic #91-Ubuntu SMP Mon Aug 14 14:14:14 UTC 2023 x86_64 x86_64 x86_64 GNU/Linux 21:26:31 up 3 days, 1:52, 4 users, load average: 1.01, 0.82, 0.75
2023-09-16 > run NEMU 221830012 茆弘之 Linux pc 5.15.0-82-generic #91-Ubuntu SMP Mon Aug 14 14:14:14 UTC 2023 x86_64 x86_64 x86_64 GNU/Linux 21:26:31 up 3 days, 1:52, 4 users, load average: 1.01, 0.82, 0.75
2023-09-16 > compile NEMU 221830012 茆弘之 Linux pc 5.15.0-82-generic #91-Ubuntu SMP Mon Aug 14 14:14:14 UTC 2023 x86_64 x86_64 x86_64 GNU/Linux 21:26:32 up 3 days, 1:52, 4 users, load average: 1.01, 0.82, 0.75
2023-09-16 > run NEMU 221830012 茆弘之 Linux pc 5.15.0-82-generic #91-Ubuntu SMP Mon Aug 14 14:14:14 UTC 2023 x86_64 x86_64 x86_64 GNU/Linux 21:26:33 up 3 days, 1:52, 4 users, load average: 1.01, 0.82, 0.75
2023-09-16 > compile NEMU 221830012 茆弘之 Linux pc 5.15.0-82-generic #91-Ubuntu SMP Mon Aug 14 14:14:14 UTC 2023 x86_64 x86_64 x86_64 GNU/Linux 21:26:33 up 3 days, 1:52, 4 users, load average: 1.01, 0.82, 0.75
2023-09-16 > run NEMU 221830012 茆弘之 Linux pc 5.15.0-82-generic #91-Ubuntu SMP Mon Aug 14 14:14:14 UTC 2023 x86_64 x86_64 x86_64 GNU/Linux 21:26:34 up 3 days, 1:52, 4 users, load average: 1.01, 0.82, 0.75
2023-09-16 > compile NEMU 221830012 茆弘之 Linux pc 5.15.0-82-generic #91-Ubuntu SMP Mon Aug 14 14:14:14 UTC 2023 x86_64 x86_64 x86_64 GNU/Linux 21:26:34 up 3 days, 1:52, 4 users, load average: 1.01, 0.82, 0.75
2023-09-16 > run NEMU 221830012 茆弘之 Linux pc 5.15.0-82-generic #91-Ubuntu SMP Mon Aug 14 14:14:14 UTC 2023 x86_64 x86_64 x86_64 GNU/Linux 21:26:35 up 3 days, 1:52, 4 users, load average: 1.01, 0.82, 0.75
2023-09-16 > compile NEMU 221830012 茆弘之 Linux pc 5.15.0-82-generic #91-Ubuntu SMP Mon Aug 14 14:14:14 UTC 2023 x86_64 x86_64 x86_64 GNU/Linux 21:26:36 up 3 days, 1:52, 4 users, load average: 1.01, 0.82, 0.75
2023-09-16 > run NEMU 221830012 茆弘之 Linux pc 5.15.0-82-generic #91-Ubuntu SMP Mon Aug 14 14:14:14 UTC 2023 x86_64 x86_64 x86_64 GNU/Linux 21:26:36 up 3 days, 1:52, 4 users, load average: 1.09, 0.84, 0.76
2023-09-16 > compile NEMU 221830012 茆弘之 Linux pc 5.15.0-82-generic #91-Ubuntu SMP Mon Aug 14 14:14:14 UTC 2023 x86_64 x86_64 x86_64 GNU/Linux 21:26:37 up 3 days, 1:52, 4 users, load average: 1.09, 0.84, 0.76
2023-09-16 > run NEMU 221830012 茆弘之 Linux pc 5.15.0-82-generic #91-Ubuntu SMP Mon Aug 14 14:14:14 UTC 2023 x86_64 x86_64 x86_64 GNU/Linux 21:26:37 up 3 days, 1:52, 4 users, load average: 1.09, 0.84, 0.76
2023-09-16 > compile NEMU 221830012 茆弘之 Linux pc 5.15.0-82-generic #91-Ubuntu SMP Mon Aug 14 14:14:14 UTC 2023 x86_64 x86_64 x86_64 GNU/Linux 21:26:38 up 3 days, 1:52, 4 users, load average: 1.09, 0.84, 0.76
2023-09-16 > run NEMU 221830012 茆弘之 Linux pc 5.15.0-82-generic #91-Ubuntu SMP Mon Aug 14 14:14:14 UTC 2023 x86_64 x86_64 x86_64 GNU/Linux 21:26:38 up 3 days, 1:52, 4 users, load average: 1.09, 0.84, 0.76
2023-09-16 > compile NEMU 221830012 茆弘之 Linux pc 5.15.0-82-generic #91-Ubuntu SMP Mon Aug 14 14:14:14 UTC 2023 x86_64 x86_64 x86_64 GNU/Linux 21:26:39 up 3 days, 1:52, 4 users, load average: 1.09, 0.84, 0.76
2023-09-16 > run NEMU 221830012 茆弘之 Linux pc 5.15.0-82-generic #91-Ubuntu SMP Mon Aug 14 14:14:14 UTC 2023 x86_64 x86_64 x86_64 GNU/Linux 21:26:40 up 3 days, 1:52, 4 users, load average: 1.09, 0.84, 0.76
2023-09-16 > compile NEMU 221830012 茆弘之 Linux pc 5.15.0-82-generic #91-Ubuntu SMP Mon Aug 14 14:14:14 UTC 2023 x86_64 x86_64 x86_64 GNU/Linux 21:49:54 up 3 days, 2:15, 4 users, load average: 0.61, 0.52, 0.55
2023-09-16 > run NEMU 221830012 茆弘之 Linux pc 5.15.0-82-generic #91-Ubuntu SMP Mon Aug 14 14:14:14 UTC 2023 x86_64 x86_64 x86_64 GNU/Linux 21:49:55 up 3 days, 2:15, 4 users, load average: 0.61, 0.52, 0.55
2023-09-17 > compile NEMU 221830012 茆弘之 Linux pc 5.15.0-82-generic #91-Ubuntu SMP Mon Aug 14 14:14:14 UTC 2023 x86_64 x86_64 x86_64 GNU/Linux 13:08:31 up 3 days, 17:34, 4 users, load average: 0.85, 0.73, 0.67
2023-09-17 > compile NEMU 221830012 茆弘之 Linux pc 5.15.0-82-generic #91-Ubuntu SMP Mon Aug 14 14:14:14 UTC 2023 x86_64 x86_64 x86_64 GNU/Linux 13:08:42 up 3 days, 17:34, 4 users, load average: 0.88, 0.73, 0.67
2023-09-17 > compile NEMU 221830012 茆弘之 Linux pc 5.15.0-82-generic #91-Ubuntu SMP Mon Aug 14 14:14:14 UTC 2023 x86_64 x86_64 x86_64 GNU/Linux 13:43:34 up 3 days, 18:09, 4 users, load average: 0.66, 0.64, 0.58
2023-09-17 > compile NEMU 221830012 茆弘之 Linux pc 5.15.0-82-generic #91-Ubuntu SMP Mon Aug 14 14:14:14 UTC 2023 x86_64 x86_64 x86_64 GNU/Linux 13:43:58 up 3 days, 18:09, 4 users, load average: 0.71, 0.66, 0.58
2023-09-17 > compile NEMU 221830012 茆弘之 Linux pc 5.15.0-82-generic #91-Ubuntu SMP Mon Aug 14 14:14:14 UTC 2023 x86_64 x86_64 x86_64 GNU/Linux 16:39:57 up 3 days, 21:05, 6 users, load average: 0.76, 0.90, 0.89
2023-09-17 > compile NEMU 221830012 茆弘之 Linux pc 5.15.0-82-generic #91-Ubuntu SMP Mon Aug 14 14:14:14 UTC 2023 x86_64 x86_64 x86_64 GNU/Linux 16:41:37 up 3 days, 21:07, 6 users, load average: 0.56, 0.80, 0.85
2023-09-17 > compile NEMU 221830012 茆弘之 Linux pc 5.15.0-82-generic #91-Ubuntu SMP Mon Aug 14 14:14:14 UTC 2023 x86_64 x86_64 x86_64 GNU/Linux 17:14:20 up 3 days, 21:40, 6 users, load average: 0.47, 0.69, 0.70
2023-09-17 > run NEMU 221830012 茆弘之 Linux pc 5.15.0-82-generic #91-Ubuntu SMP Mon Aug 14 14:14:14 UTC 2023 x86_64 x86_64 x86_64 GNU/Linux 17:14:20 up 3 days, 21:40, 6 users, load average: 0.47, 0.69, 0.70
2023-09-17 > compile NEMU 221830012 茆弘之 Linux pc 5.15.0-82-generic #91-Ubuntu SMP Mon Aug 14 14:14:14 UTC 2023 x86_64 x86_64 x86_64 GNU/Linux 18:09:01 up 3 days, 22:34, 6 users, load average: 0.57, 0.57, 0.52
2023-09-17 > run NEMU 221830012 茆弘之 Linux pc 5.15.0-82-generic #91-Ubuntu SMP Mon Aug 14 14:14:14 UTC 2023 x86_64 x86_64 x86_64 GNU/Linux 18:09:02 up 3 days, 22:34, 6 users, load average: 0.57, 0.57, 0.52
2023-09-17 > compile NEMU 221830012 茆弘之 Linux pc 5.15.0-82-generic #91-Ubuntu SMP Mon Aug 14 14:14:14 UTC 2023 x86_64 x86_64 x86_64 GNU/Linux 18:10:43 up 3 days, 22:36, 6 users, load average: 0.54, 0.57, 0.52
2023-09-17 > run NEMU 221830012 茆弘之 Linux pc 5.15.0-82-generic #91-Ubuntu SMP Mon Aug 14 14:14:14 UTC 2023 x86_64 x86_64 x86_64 GNU/Linux 18:10:44 up 3 days, 22:36, 6 users, load average: 0.54, 0.57, 0.52
2023-09-17 > compile NEMU 221830012 茆弘之 Linux pc 5.15.0-82-generic #91-Ubuntu SMP Mon Aug 14 14:14:14 UTC 2023 x86_64 x86_64 x86_64 GNU/Linux 18:12:22 up 3 days, 22:38, 6 users, load average: 0.60, 0.58, 0.54
2023-09-17 > run NEMU 221830012 茆弘之 Linux pc 5.15.0-82-generic #91-Ubuntu SMP Mon Aug 14 14:14:14 UTC 2023 x86_64 x86_64 x86_64 GNU/Linux 18:12:22 up 3 days, 22:38, 6 users, load average: 0.60, 0.58, 0.54
2023-09-17 > compile NEMU 221830012 茆弘之 Linux pc 5.15.0-82-generic #91-Ubuntu SMP Mon Aug 14 14:14:14 UTC 2023 x86_64 x86_64 x86_64 GNU/Linux 18:20:14 up 3 days, 22:46, 6 users, load average: 0.77, 0.57, 0.52
2023-09-17 > run NEMU 221830012 茆弘之 Linux pc 5.15.0-82-generic #91-Ubuntu SMP Mon Aug 14 14:14:14 UTC 2023 x86_64 x86_64 x86_64 GNU/Linux 18:20:14 up 3 days, 22:46, 6 users, load average: 0.77, 0.57, 0.52
2023-09-17 > compile NEMU 221830012 茆弘之 Linux pc 5.15.0-82-generic #91-Ubuntu SMP Mon Aug 14 14:14:14 UTC 2023 x86_64 x86_64 x86_64 GNU/Linux 18:23:02 up 3 days, 22:48, 6 users, load average: 0.74, 0.58, 0.53
2023-09-17 > gdb NEMU 221830012 茆弘之 Linux pc 5.15.0-82-generic #91-Ubuntu SMP Mon Aug 14 14:14:14 UTC 2023 x86_64 x86_64 x86_64 GNU/Linux 18:23:02 up 3 days, 22:48, 6 users, load average: 0.74, 0.58, 0.53
2023-09-17 > compile NEMU 221830012 茆弘之 Linux pc 5.15.0-82-generic #91-Ubuntu SMP Mon Aug 14 14:14:14 UTC 2023 x86_64 x86_64 x86_64 GNU/Linux 18:25:13 up 3 days, 22:51, 6 users, load average: 0.82, 0.73, 0.60
2023-09-17 > gdb NEMU 221830012 茆弘之 Linux pc 5.15.0-82-generic #91-Ubuntu SMP Mon Aug 14 14:14:14 UTC 2023 x86_64 x86_64 x86_64 GNU/Linux 18:25:13 up 3 days, 22:51, 6 users, load average: 0.82, 0.73, 0.60
2023-09-17 > compile NEMU 221830012 茆弘之 Linux pc 5.15.0-82-generic #91-Ubuntu SMP Mon Aug 14 14:14:14 UTC 2023 x86_64 x86_64 x86_64 GNU/Linux 18:26:03 up 3 days, 22:51, 6 users, load average: 0.55, 0.66, 0.58
2023-09-17 > gdb NEMU 221830012 茆弘之 Linux pc 5.15.0-82-generic #91-Ubuntu SMP Mon Aug 14 14:14:14 UTC 2023 x86_64 x86_64 x86_64 GNU/Linux 18:26:04 up 3 days, 22:51, 6 users, load average: 0.55, 0.66, 0.58
2023-09-17 > compile NEMU 221830012 茆弘之 Linux pc 5.15.0-82-generic #91-Ubuntu SMP Mon Aug 14 14:14:14 UTC 2023 x86_64 x86_64 x86_64 GNU/Linux 19:04:00 up 3 days, 23:29, 6 users, load average: 0.94, 0.49, 0.35
2023-09-17 > run NEMU 221830012 茆弘之 Linux pc 5.15.0-82-generic #91-Ubuntu SMP Mon Aug 14 14:14:14 UTC 2023 x86_64 x86_64 x86_64 GNU/Linux 19:04:00 up 3 days, 23:29, 6 users, load average: 0.94, 0.49, 0.35
2023-09-17 > compile NEMU 221830012 茆弘之 Linux pc 5.15.0-82-generic #91-Ubuntu SMP Mon Aug 14 14:14:14 UTC 2023 x86_64 x86_64 x86_64 GNU/Linux 19:05:00 up 3 days, 23:30, 6 users, load average: 0.93, 0.57, 0.38
2023-09-17 > gdb NEMU 221830012 茆弘之 Linux pc 5.15.0-82-generic #91-Ubuntu SMP Mon Aug 14 14:14:14 UTC 2023 x86_64 x86_64 x86_64 GNU/Linux 19:05:01 up 3 days, 23:30, 6 users, load average: 0.93, 0.57, 0.38
2023-09-17 > compile NEMU 221830012 茆弘之 Linux pc 5.15.0-82-generic #91-Ubuntu SMP Mon Aug 14 14:14:14 UTC 2023 x86_64 x86_64 x86_64 GNU/Linux 19:15:51 up 3 days, 23:41, 6 users, load average: 1.40, 0.91, 0.60
2023-09-17 > run NEMU 221830012 茆弘之 Linux pc 5.15.0-82-generic #91-Ubuntu SMP Mon Aug 14 14:14:14 UTC 2023 x86_64 x86_64 x86_64 GNU/Linux 19:15:52 up 3 days, 23:41, 6 users, load average: 1.40, 0.91, 0.60
2023-09-17 > compile NEMU 221830012 茆弘之 Linux pc 5.15.0-82-generic #91-Ubuntu SMP Mon Aug 14 14:14:14 UTC 2023 x86_64 x86_64 x86_64 GNU/Linux 19:17:38 up 3 days, 23:43, 6 users, load average: 0.85, 0.90, 0.64
2023-09-17 > gdb NEMU 221830012 茆弘之 Linux pc 5.15.0-82-generic #91-Ubuntu SMP Mon Aug 14 14:14:14 UTC 2023 x86_64 x86_64 x86_64 GNU/Linux 19:17:39 up 3 days, 23:43, 6 users, load average: 0.85, 0.90, 0.64
2023-09-17 > compile NEMU 221830012 茆弘之 Linux pc 5.15.0-82-generic #91-Ubuntu SMP Mon Aug 14 14:14:14 UTC 2023 x86_64 x86_64 x86_64 GNU/Linux 19:17:45 up 3 days, 23:43, 6 users, load average: 0.78, 0.89, 0.63
2023-09-17 > run NEMU 221830012 茆弘之 Linux pc 5.15.0-82-generic #91-Ubuntu SMP Mon Aug 14 14:14:14 UTC 2023 x86_64 x86_64 x86_64 GNU/Linux 19:17:46 up 3 days, 23:43, 6 users, load average: 0.78, 0.89, 0.63
2023-09-17 > compile NEMU 221830012 茆弘之 Linux pc 5.15.0-82-generic #91-Ubuntu SMP Mon Aug 14 14:14:14 UTC 2023 x86_64 x86_64 x86_64 GNU/Linux 19:25:04 up 3 days, 23:50, 6 users, load average: 0.51, 0.66, 0.63
2023-09-17 > run NEMU 221830012 茆弘之 Linux pc 5.15.0-82-generic #91-Ubuntu SMP Mon Aug 14 14:14:14 UTC 2023 x86_64 x86_64 x86_64 GNU/Linux 19:25:05 up 3 days, 23:50, 6 users, load average: 0.51, 0.66, 0.63
2023-09-17 > compile NEMU 221830012 茆弘之 Linux pc 5.15.0-82-generic #91-Ubuntu SMP Mon Aug 14 14:14:14 UTC 2023 x86_64 x86_64 x86_64 GNU/Linux 19:27:38 up 3 days, 23:53, 6 users, load average: 0.65, 0.68, 0.64
2023-09-17 > run NEMU 221830012 茆弘之 Linux pc 5.15.0-82-generic #91-Ubuntu SMP Mon Aug 14 14:14:14 UTC 2023 x86_64 x86_64 x86_64 GNU/Linux 19:27:39 up 3 days, 23:53, 6 users, load average: 0.65, 0.68, 0.64
2023-09-17 > compile NEMU 221830012 茆弘之 Linux pc 5.15.0-82-generic #91-Ubuntu SMP Mon Aug 14 14:14:14 UTC 2023 x86_64 x86_64 x86_64 GNU/Linux 19:29:32 up 3 days, 23:55, 6 users, load average: 0.90, 0.76, 0.67
2023-09-17 > run NEMU 221830012 茆弘之 Linux pc 5.15.0-82-generic #91-Ubuntu SMP Mon Aug 14 14:14:14 UTC 2023 x86_64 x86_64 x86_64 GNU/Linux 19:29:33 up 3 days, 23:55, 6 users, load average: 0.90, 0.76, 0.67
2023-09-17 > compile NEMU 221830012 茆弘之 Linux pc 5.15.0-82-generic #91-Ubuntu SMP Mon Aug 14 14:14:14 UTC 2023 x86_64 x86_64 x86_64 GNU/Linux 19:37:26 up 4 days, 3 min, 6 users, load average: 0.74, 0.73, 0.71
2023-09-17 > run NEMU 221830012 茆弘之 Linux pc 5.15.0-82-generic #91-Ubuntu SMP Mon Aug 14 14:14:14 UTC 2023 x86_64 x86_64 x86_64 GNU/Linux 19:37:27 up 4 days, 3 min, 6 users, load average: 0.74, 0.73, 0.71
2023-09-17 > compile NEMU 221830012 茆弘之 Linux pc 5.15.0-82-generic #91-Ubuntu SMP Mon Aug 14 14:14:14 UTC 2023 x86_64 x86_64 x86_64 GNU/Linux 19:39:35 up 4 days, 5 min, 6 users, load average: 1.11, 0.86, 0.76
2023-09-17 > run NEMU 221830012 茆弘之 Linux pc 5.15.0-82-generic #91-Ubuntu SMP Mon Aug 14 14:14:14 UTC 2023 x86_64 x86_64 x86_64 GNU/Linux 19:39:35 up 4 days, 5 min, 6 users, load average: 1.11, 0.86, 0.76
2023-09-17 > compile NEMU 221830012 茆弘之 Linux pc 5.15.0-82-generic #91-Ubuntu SMP Mon Aug 14 14:14:14 UTC 2023 x86_64 x86_64 x86_64 GNU/Linux 19:46:02 up 4 days, 11 min, 6 users, load average: 0.60, 0.69, 0.72
2023-09-17 > run NEMU 221830012 茆弘之 Linux pc 5.15.0-82-generic #91-Ubuntu SMP Mon Aug 14 14:14:14 UTC 2023 x86_64 x86_64 x86_64 GNU/Linux 19:46:03 up 4 days, 11 min, 6 users, load average: 0.60, 0.69, 0.72
2023-09-17 > compile NEMU 221830012 茆弘之 Linux pc 5.15.0-82-generic #91-Ubuntu SMP Mon Aug 14 14:14:14 UTC 2023 x86_64 x86_64 x86_64 GNU/Linux 19:50:09 up 4 days, 16 min, 6 users, load average: 0.71, 0.71, 0.73
2023-09-17 > run NEMU 221830012 茆弘之 Linux pc 5.15.0-82-generic #91-Ubuntu SMP Mon Aug 14 14:14:14 UTC 2023 x86_64 x86_64 x86_64 GNU/Linux 19:50:09 up 4 days, 16 min, 6 users, load average: 0.90, 0.75, 0.74
2023-09-17 > compile NEMU 221830012 茆弘之 Linux pc 5.15.0-82-generic #91-Ubuntu SMP Mon Aug 14 14:14:14 UTC 2023 x86_64 x86_64 x86_64 GNU/Linux 19:51:17 up 4 days, 17 min, 6 users, load average: 1.32, 0.91, 0.79
2023-09-17 > run NEMU 221830012 茆弘之 Linux pc 5.15.0-82-generic #91-Ubuntu SMP Mon Aug 14 14:14:14 UTC 2023 x86_64 x86_64 x86_64 GNU/Linux 19:51:17 up 4 days, 17 min, 6 users, load average: 1.32, 0.91, 0.79
2023-09-17 > compile NEMU 221830012 茆弘之 Linux pc 5.15.0-82-generic #91-Ubuntu SMP Mon Aug 14 14:14:14 UTC 2023 x86_64 x86_64 x86_64 GNU/Linux 19:51:43 up 4 days, 17 min, 6 users, load average: 0.98, 0.86, 0.78
2023-09-17 > run NEMU 221830012 茆弘之 Linux pc 5.15.0-82-generic #91-Ubuntu SMP Mon Aug 14 14:14:14 UTC 2023 x86_64 x86_64 x86_64 GNU/Linux 19:51:44 up 4 days, 17 min, 6 users, load average: 0.98, 0.86, 0.78
2023-09-17 > compile NEMU 221830012 茆弘之 Linux pc 5.15.0-82-generic #91-Ubuntu SMP Mon Aug 14 14:14:14 UTC 2023 x86_64 x86_64 x86_64 GNU/Linux 19:52:01 up 4 days, 17 min, 6 users, load average: 0.91, 0.86, 0.78
2023-09-17 > run NEMU 221830012 茆弘之 Linux pc 5.15.0-82-generic #91-Ubuntu SMP Mon Aug 14 14:14:14 UTC 2023 x86_64 x86_64 x86_64 GNU/Linux 19:52:01 up 4 days, 17 min, 6 users, load average: 0.91, 0.86, 0.78
2023-09-17 > compile NEMU 221830012 茆弘之 Linux pc 5.15.0-82-generic #91-Ubuntu SMP Mon Aug 14 14:14:14 UTC 2023 x86_64 x86_64 x86_64 GNU/Linux 19:52:02 up 4 days, 17 min, 6 users, load average: 0.91, 0.86, 0.78
2023-09-17 > run NEMU 221830012 茆弘之 Linux pc 5.15.0-82-generic #91-Ubuntu SMP Mon Aug 14 14:14:14 UTC 2023 x86_64 x86_64 x86_64 GNU/Linux 19:52:02 up 4 days, 17 min, 6 users, load average: 0.91, 0.86, 0.78
2023-09-17 > compile NEMU 221830012 茆弘之 Linux pc 5.15.0-82-generic #91-Ubuntu SMP Mon Aug 14 14:14:14 UTC 2023 x86_64 x86_64 x86_64 GNU/Linux 19:52:03 up 4 days, 17 min, 6 users, load average: 0.91, 0.86, 0.78
2023-09-17 > run NEMU 221830012 茆弘之 Linux pc 5.15.0-82-generic #91-Ubuntu SMP Mon Aug 14 14:14:14 UTC 2023 x86_64 x86_64 x86_64 GNU/Linux 19:52:04 up 4 days, 17 min, 6 users, load average: 0.91, 0.86, 0.78
2023-09-17 > compile NEMU 221830012 茆弘之 Linux pc 5.15.0-82-generic #91-Ubuntu SMP Mon Aug 14 14:14:14 UTC 2023 x86_64 x86_64 x86_64 GNU/Linux 19:52:04 up 4 days, 17 min, 6 users, load average: 0.91, 0.86, 0.78
2023-09-17 > run NEMU 221830012 茆弘之 Linux pc 5.15.0-82-generic #91-Ubuntu SMP Mon Aug 14 14:14:14 UTC 2023 x86_64 x86_64 x86_64 GNU/Linux 19:52:05 up 4 days, 17 min, 6 users, load average: 1.24, 0.92, 0.81
2023-09-17 > compile NEMU 221830012 茆弘之 Linux pc 5.15.0-82-generic #91-Ubuntu SMP Mon Aug 14 14:14:14 UTC 2023 x86_64 x86_64 x86_64 GNU/Linux 19:52:05 up 4 days, 18 min, 6 users, load average: 1.24, 0.92, 0.81
2023-09-17 > run NEMU 221830012 茆弘之 Linux pc 5.15.0-82-generic #91-Ubuntu SMP Mon Aug 14 14:14:14 UTC 2023 x86_64 x86_64 x86_64 GNU/Linux 19:52:06 up 4 days, 18 min, 6 users, load average: 1.24, 0.92, 0.81
2023-09-17 > compile NEMU 221830012 茆弘之 Linux pc 5.15.0-82-generic #91-Ubuntu SMP Mon Aug 14 14:14:14 UTC 2023 x86_64 x86_64 x86_64 GNU/Linux 19:52:07 up 4 days, 18 min, 6 users, load average: 1.24, 0.92, 0.81
2023-09-17 > run NEMU 221830012 茆弘之 Linux pc 5.15.0-82-generic #91-Ubuntu SMP Mon Aug 14 14:14:14 UTC 2023 x86_64 x86_64 x86_64 GNU/Linux 19:52:07 up 4 days, 18 min, 6 users, load average: 1.24, 0.92, 0.81
2023-09-17 > compile NEMU 221830012 茆弘之 Linux pc 5.15.0-82-generic #91-Ubuntu SMP Mon Aug 14 14:14:14 UTC 2023 x86_64 x86_64 x86_64 GNU/Linux 19:52:08 up 4 days, 18 min, 6 users, load average: 1.24, 0.92, 0.81
2023-09-17 > run NEMU 221830012 茆弘之 Linux pc 5.15.0-82-generic #91-Ubuntu SMP Mon Aug 14 14:14:14 UTC 2023 x86_64 x86_64 x86_64 GNU/Linux 19:52:08 up 4 days, 18 min, 6 users, load average: 1.24, 0.92, 0.81
2023-09-17 > compile NEMU 221830012 茆弘之 Linux pc 5.15.0-82-generic #91-Ubuntu SMP Mon Aug 14 14:14:14 UTC 2023 x86_64 x86_64 x86_64 GNU/Linux 19:52:09 up 4 days, 18 min, 6 users, load average: 1.24, 0.92, 0.81
2023-09-17 > run NEMU 221830012 茆弘之 Linux pc 5.15.0-82-generic #91-Ubuntu SMP Mon Aug 14 14:14:14 UTC 2023 x86_64 x86_64 x86_64 GNU/Linux 19:52:09 up 4 days, 18 min, 6 users, load average: 1.22, 0.93, 0.81
2023-09-17 > compile NEMU 221830012 茆弘之 Linux pc 5.15.0-82-generic #91-Ubuntu SMP Mon Aug 14 14:14:14 UTC 2023 x86_64 x86_64 x86_64 GNU/Linux 19:52:10 up 4 days, 18 min, 6 users, load average: 1.22, 0.93, 0.81
2023-09-17 > run NEMU 221830012 茆弘之 Linux pc 5.15.0-82-generic #91-Ubuntu SMP Mon Aug 14 14:14:14 UTC 2023 x86_64 x86_64 x86_64 GNU/Linux 19:52:10 up 4 days, 18 min, 6 users, load average: 1.22, 0.93, 0.81
2023-09-17 > compile NEMU 221830012 茆弘之 Linux pc 5.15.0-82-generic #91-Ubuntu SMP Mon Aug 14 14:14:14 UTC 2023 x86_64 x86_64 x86_64 GNU/Linux 19:52:11 up 4 days, 18 min, 6 users, load average: 1.22, 0.93, 0.81
2023-09-17 > run NEMU 221830012 茆弘之 Linux pc 5.15.0-82-generic #91-Ubuntu SMP Mon Aug 14 14:14:14 UTC 2023 x86_64 x86_64 x86_64 GNU/Linux 19:52:12 up 4 days, 18 min, 6 users, load average: 1.22, 0.93, 0.81
2023-09-17 > compile NEMU 221830012 茆弘之 Linux pc 5.15.0-82-generic #91-Ubuntu SMP Mon Aug 14 14:14:14 UTC 2023 x86_64 x86_64 x86_64 GNU/Linux 19:52:12 up 4 days, 18 min, 6 users, load average: 1.22, 0.93, 0.81
2023-09-17 > run NEMU 221830012 茆弘之 Linux pc 5.15.0-82-generic #91-Ubuntu SMP Mon Aug 14 14:14:14 UTC 2023 x86_64 x86_64 x86_64 GNU/Linux 19:52:13 up 4 days, 18 min, 6 users, load average: 1.22, 0.93, 0.81
2023-09-17 > compile NEMU 221830012 茆弘之 Linux pc 5.15.0-82-generic #91-Ubuntu SMP Mon Aug 14 14:14:14 UTC 2023 x86_64 x86_64 x86_64 GNU/Linux 19:52:13 up 4 days, 18 min, 6 users, load average: 1.22, 0.93, 0.81
2023-09-17 > run NEMU 221830012 茆弘之 Linux pc 5.15.0-82-generic #91-Ubuntu SMP Mon Aug 14 14:14:14 UTC 2023 x86_64 x86_64 x86_64 GNU/Linux 19:52:14 up 4 days, 18 min, 6 users, load average: 1.22, 0.93, 0.81
2023-09-17 > compile NEMU 221830012 茆弘之 Linux pc 5.15.0-82-generic #91-Ubuntu SMP Mon Aug 14 14:14:14 UTC 2023 x86_64 x86_64 x86_64 GNU/Linux 19:52:14 up 4 days, 18 min, 6 users, load average: 1.20, 0.93, 0.81
2023-09-17 > run NEMU 221830012 茆弘之 Linux pc 5.15.0-82-generic #91-Ubuntu SMP Mon Aug 14 14:14:14 UTC 2023 x86_64 x86_64 x86_64 GNU/Linux 19:52:15 up 4 days, 18 min, 6 users, load average: 1.20, 0.93, 0.81
2023-09-17 > compile NEMU 221830012 茆弘之 Linux pc 5.15.0-82-generic #91-Ubuntu SMP Mon Aug 14 14:14:14 UTC 2023 x86_64 x86_64 x86_64 GNU/Linux 19:52:16 up 4 days, 18 min, 6 users, load average: 1.20, 0.93, 0.81
2023-09-17 > run NEMU 221830012 茆弘之 Linux pc 5.15.0-82-generic #91-Ubuntu SMP Mon Aug 14 14:14:14 UTC 2023 x86_64 x86_64 x86_64 GNU/Linux 19:52:16 up 4 days, 18 min, 6 users, load average: 1.20, 0.93, 0.81
2023-09-17 > compile NEMU 221830012 茆弘之 Linux pc 5.15.0-82-generic #91-Ubuntu SMP Mon Aug 14 14:14:14 UTC 2023 x86_64 x86_64 x86_64 GNU/Linux 19:52:17 up 4 days, 18 min, 6 users, load average: 1.20, 0.93, 0.81
2023-09-17 > run NEMU 221830012 茆弘之 Linux pc 5.15.0-82-generic #91-Ubuntu SMP Mon Aug 14 14:14:14 UTC 2023 x86_64 x86_64 x86_64 GNU/Linux 19:52:17 up 4 days, 18 min, 6 users, load average: 1.20, 0.93, 0.81
2023-09-17 > compile NEMU 221830012 茆弘之 Linux pc 5.15.0-82-generic #91-Ubuntu SMP Mon Aug 14 14:14:14 UTC 2023 x86_64 x86_64 x86_64 GNU/Linux 19:52:18 up 4 days, 18 min, 6 users, load average: 1.20, 0.93, 0.81
2023-09-17 > run NEMU 221830012 茆弘之 Linux pc 5.15.0-82-generic #91-Ubuntu SMP Mon Aug 14 14:14:14 UTC 2023 x86_64 x86_64 x86_64 GNU/Linux 19:52:18 up 4 days, 18 min, 6 users, load average: 1.20, 0.93, 0.81
2023-09-17 > compile NEMU 221830012 茆弘之 Linux pc 5.15.0-82-generic #91-Ubuntu SMP Mon Aug 14 14:14:14 UTC 2023 x86_64 x86_64 x86_64 GNU/Linux 19:52:19 up 4 days, 18 min, 6 users, load average: 1.20, 0.93, 0.81
2023-09-17 > run NEMU 221830012 茆弘之 Linux pc 5.15.0-82-generic #91-Ubuntu SMP Mon Aug 14 14:14:14 UTC 2023 x86_64 x86_64 x86_64 GNU/Linux 19:52:20 up 4 days, 18 min, 6 users, load average: 1.26, 0.95, 0.82
2023-09-17 > compile NEMU 221830012 茆弘之 Linux pc 5.15.0-82-generic #91-Ubuntu SMP Mon Aug 14 14:14:14 UTC 2023 x86_64 x86_64 x86_64 GNU/Linux 19:52:20 up 4 days, 18 min, 6 users, load average: 1.26, 0.95, 0.82
2023-09-17 > run NEMU 221830012 茆弘之 Linux pc 5.15.0-82-generic #91-Ubuntu SMP Mon Aug 14 14:14:14 UTC 2023 x86_64 x86_64 x86_64 GNU/Linux 19:52:21 up 4 days, 18 min, 6 users, load average: 1.26, 0.95, 0.82
2023-09-17 > compile NEMU 221830012 茆弘之 Linux pc 5.15.0-82-generic #91-Ubuntu SMP Mon Aug 14 14:14:14 UTC 2023 x86_64 x86_64 x86_64 GNU/Linux 19:52:21 up 4 days, 18 min, 6 users, load average: 1.26, 0.95, 0.82
2023-09-17 > run NEMU 221830012 茆弘之 Linux pc 5.15.0-82-generic #91-Ubuntu SMP Mon Aug 14 14:14:14 UTC 2023 x86_64 x86_64 x86_64 GNU/Linux 19:52:22 up 4 days, 18 min, 6 users, load average: 1.26, 0.95, 0.82
2023-09-17 > compile NEMU 221830012 茆弘之 Linux pc 5.15.0-82-generic #91-Ubuntu SMP Mon Aug 14 14:14:14 UTC 2023 x86_64 x86_64 x86_64 GNU/Linux 19:52:23 up 4 days, 18 min, 6 users, load average: 1.26, 0.95, 0.82
2023-09-17 > run NEMU 221830012 茆弘之 Linux pc 5.15.0-82-generic #91-Ubuntu SMP Mon Aug 14 14:14:14 UTC 2023 x86_64 x86_64 x86_64 GNU/Linux 19:52:23 up 4 days, 18 min, 6 users, load average: 1.26, 0.95, 0.82
2023-09-17 > compile NEMU 221830012 茆弘之 Linux pc 5.15.0-82-generic #91-Ubuntu SMP Mon Aug 14 14:14:14 UTC 2023 x86_64 x86_64 x86_64 GNU/Linux 19:52:24 up 4 days, 18 min, 6 users, load average: 1.26, 0.95, 0.82
2023-09-17 > run NEMU 221830012 茆弘之 Linux pc 5.15.0-82-generic #91-Ubuntu SMP Mon Aug 14 14:14:14 UTC 2023 x86_64 x86_64 x86_64 GNU/Linux 19:52:24 up 4 days, 18 min, 6 users, load average: 1.26, 0.95, 0.82
2023-09-17 > compile NEMU 221830012 茆弘之 Linux pc 5.15.0-82-generic #91-Ubuntu SMP Mon Aug 14 14:14:14 UTC 2023 x86_64 x86_64 x86_64 GNU/Linux 19:52:25 up 4 days, 18 min, 6 users, load average: 1.40, 0.98, 0.83
2023-09-17 > run NEMU 221830012 茆弘之 Linux pc 5.15.0-82-generic #91-Ubuntu SMP Mon Aug 14 14:14:14 UTC 2023 x86_64 x86_64 x86_64 GNU/Linux 19:52:25 up 4 days, 18 min, 6 users, load average: 1.40, 0.98, 0.83
2023-09-17 > compile NEMU 221830012 茆弘之 Linux pc 5.15.0-82-generic #91-Ubuntu SMP Mon Aug 14 14:14:14 UTC 2023 x86_64 x86_64 x86_64 GNU/Linux 19:52:26 up 4 days, 18 min, 6 users, load average: 1.40, 0.98, 0.83
2023-09-17 > run NEMU 221830012 茆弘之 Linux pc 5.15.0-82-generic #91-Ubuntu SMP Mon Aug 14 14:14:14 UTC 2023 x86_64 x86_64 x86_64 GNU/Linux 19:52:26 up 4 days, 18 min, 6 users, load average: 1.40, 0.98, 0.83
2023-09-17 > compile NEMU 221830012 茆弘之 Linux pc 5.15.0-82-generic #91-Ubuntu SMP Mon Aug 14 14:14:14 UTC 2023 x86_64 x86_64 x86_64 GNU/Linux 19:52:27 up 4 days, 18 min, 6 users, load average: 1.40, 0.98, 0.83
2023-09-17 > run NEMU 221830012 茆弘之 Linux pc 5.15.0-82-generic #91-Ubuntu SMP Mon Aug 14 14:14:14 UTC 2023 x86_64 x86_64 x86_64 GNU/Linux 19:52:27 up 4 days, 18 min, 6 users, load average: 1.40, 0.98, 0.83
2023-09-17 > compile NEMU 221830012 茆弘之 Linux pc 5.15.0-82-generic #91-Ubuntu SMP Mon Aug 14 14:14:14 UTC 2023 x86_64 x86_64 x86_64 GNU/Linux 19:52:28 up 4 days, 18 min, 6 users, load average: 1.40, 0.98, 0.83
2023-09-17 > run NEMU 221830012 茆弘之 Linux pc 5.15.0-82-generic #91-Ubuntu SMP Mon Aug 14 14:14:14 UTC 2023 x86_64 x86_64 x86_64 GNU/Linux 19:52:29 up 4 days, 18 min, 6 users, load average: 1.40, 0.98, 0.83
2023-09-17 > compile NEMU 221830012 茆弘之 Linux pc 5.15.0-82-generic #91-Ubuntu SMP Mon Aug 14 14:14:14 UTC 2023 x86_64 x86_64 x86_64 GNU/Linux 19:52:29 up 4 days, 18 min, 6 users, load average: 1.53, 1.01, 0.84
2023-09-17 > run NEMU 221830012 茆弘之 Linux pc 5.15.0-82-generic #91-Ubuntu SMP Mon Aug 14 14:14:14 UTC 2023 x86_64 x86_64 x86_64 GNU/Linux 19:52:30 up 4 days, 18 min, 6 users, load average: 1.53, 1.01, 0.84
2023-09-17 > compile NEMU 221830012 茆弘之 Linux pc 5.15.0-82-generic #91-Ubuntu SMP Mon Aug 14 14:14:14 UTC 2023 x86_64 x86_64 x86_64 GNU/Linux 19:52:30 up 4 days, 18 min, 6 users, load average: 1.53, 1.01, 0.84
2023-09-17 > run NEMU 221830012 茆弘之 Linux pc 5.15.0-82-generic #91-Ubuntu SMP Mon Aug 14 14:14:14 UTC 2023 x86_64 x86_64 x86_64 GNU/Linux 19:52:31 up 4 days, 18 min, 6 users, load average: 1.53, 1.01, 0.84
2023-09-17 > compile NEMU 221830012 茆弘之 Linux pc 5.15.0-82-generic #91-Ubuntu SMP Mon Aug 14 14:14:14 UTC 2023 x86_64 x86_64 x86_64 GNU/Linux 19:52:32 up 4 days, 18 min, 6 users, load average: 1.53, 1.01, 0.84
2023-09-17 > run NEMU 221830012 茆弘之 Linux pc 5.15.0-82-generic #91-Ubuntu SMP Mon Aug 14 14:14:14 UTC 2023 x86_64 x86_64 x86_64 GNU/Linux 19:52:32 up 4 days, 18 min, 6 users, load average: 1.53, 1.01, 0.84
2023-09-17 > compile NEMU 221830012 茆弘之 Linux pc 5.15.0-82-generic #91-Ubuntu SMP Mon Aug 14 14:14:14 UTC 2023 x86_64 x86_64 x86_64 GNU/Linux 19:52:33 up 4 days, 18 min, 6 users, load average: 1.53, 1.01, 0.84
2023-09-17 > run NEMU 221830012 茆弘之 Linux pc 5.15.0-82-generic #91-Ubuntu SMP Mon Aug 14 14:14:14 UTC 2023 x86_64 x86_64 x86_64 GNU/Linux 19:52:33 up 4 days, 18 min, 6 users, load average: 1.53, 1.01, 0.84
2023-09-17 > compile NEMU 221830012 茆弘之 Linux pc 5.15.0-82-generic #91-Ubuntu SMP Mon Aug 14 14:14:14 UTC 2023 x86_64 x86_64 x86_64 GNU/Linux 19:52:34 up 4 days, 18 min, 6 users, load average: 1.53, 1.01, 0.84
2023-09-17 > run NEMU 221830012 茆弘之 Linux pc 5.15.0-82-generic #91-Ubuntu SMP Mon Aug 14 14:14:14 UTC 2023 x86_64 x86_64 x86_64 GNU/Linux 19:52:34 up 4 days, 18 min, 6 users, load average: 1.65, 1.05, 0.85
2023-09-17 > compile NEMU 221830012 茆弘之 Linux pc 5.15.0-82-generic #91-Ubuntu SMP Mon Aug 14 14:14:14 UTC 2023 x86_64 x86_64 x86_64 GNU/Linux 19:52:35 up 4 days, 18 min, 6 users, load average: 1.65, 1.05, 0.85
2023-09-17 > run NEMU 221830012 茆弘之 Linux pc 5.15.0-82-generic #91-Ubuntu SMP Mon Aug 14 14:14:14 UTC 2023 x86_64 x86_64 x86_64 GNU/Linux 19:52:35 up 4 days, 18 min, 6 users, load average: 1.65, 1.05, 0.85
2023-09-17 > compile NEMU 221830012 茆弘之 Linux pc 5.15.0-82-generic #91-Ubuntu SMP Mon Aug 14 14:14:14 UTC 2023 x86_64 x86_64 x86_64 GNU/Linux 19:52:36 up 4 days, 18 min, 6 users, load average: 1.65, 1.05, 0.85
2023-09-17 > run NEMU 221830012 茆弘之 Linux pc 5.15.0-82-generic #91-Ubuntu SMP Mon Aug 14 14:14:14 UTC 2023 x86_64 x86_64 x86_64 GNU/Linux 19:52:37 up 4 days, 18 min, 6 users, load average: 1.65, 1.05, 0.85
2023-09-17 > compile NEMU 221830012 茆弘之 Linux pc 5.15.0-82-generic #91-Ubuntu SMP Mon Aug 14 14:14:14 UTC 2023 x86_64 x86_64 x86_64 GNU/Linux 19:52:37 up 4 days, 18 min, 6 users, load average: 1.65, 1.05, 0.85
2023-09-17 > run NEMU 221830012 茆弘之 Linux pc 5.15.0-82-generic #91-Ubuntu SMP Mon Aug 14 14:14:14 UTC 2023 x86_64 x86_64 x86_64 GNU/Linux 19:52:38 up 4 days, 18 min, 6 users, load average: 1.65, 1.05, 0.85
2023-09-17 > compile NEMU 221830012 茆弘之 Linux pc 5.15.0-82-generic #91-Ubuntu SMP Mon Aug 14 14:14:14 UTC 2023 x86_64 x86_64 x86_64 GNU/Linux 19:52:38 up 4 days, 18 min, 6 users, load average: 1.65, 1.05, 0.85
2023-09-17 > run NEMU 221830012 茆弘之 Linux pc 5.15.0-82-generic #91-Ubuntu SMP Mon Aug 14 14:14:14 UTC 2023 x86_64 x86_64 x86_64 GNU/Linux 19:52:39 up 4 days, 18 min, 6 users, load average: 1.65, 1.05, 0.85
2023-09-17 > compile NEMU 221830012 茆弘之 Linux pc 5.15.0-82-generic #91-Ubuntu SMP Mon Aug 14 14:14:14 UTC 2023 x86_64 x86_64 x86_64 GNU/Linux 19:52:39 up 4 days, 18 min, 6 users, load average: 1.68, 1.06, 0.86
2023-09-17 > run NEMU 221830012 茆弘之 Linux pc 5.15.0-82-generic #91-Ubuntu SMP Mon Aug 14 14:14:14 UTC 2023 x86_64 x86_64 x86_64 GNU/Linux 19:52:40 up 4 days, 18 min, 6 users, load average: 1.68, 1.06, 0.86
2023-09-17 > compile NEMU 221830012 茆弘之 Linux pc 5.15.0-82-generic #91-Ubuntu SMP Mon Aug 14 14:14:14 UTC 2023 x86_64 x86_64 x86_64 GNU/Linux 19:52:41 up 4 days, 18 min, 6 users, load average: 1.68, 1.06, 0.86
2023-09-17 > run NEMU 221830012 茆弘之 Linux pc 5.15.0-82-generic #91-Ubuntu SMP Mon Aug 14 14:14:14 UTC 2023 x86_64 x86_64 x86_64 GNU/Linux 19:52:41 up 4 days, 18 min, 6 users, load average: 1.68, 1.06, 0.86
2023-09-17 > compile NEMU 221830012 茆弘之 Linux pc 5.15.0-82-generic #91-Ubuntu SMP Mon Aug 14 14:14:14 UTC 2023 x86_64 x86_64 x86_64 GNU/Linux 19:53:42 up 4 days, 19 min, 6 users, load average: 1.00, 0.99, 0.84
2023-09-17 > run NEMU 221830012 茆弘之 Linux pc 5.15.0-82-generic #91-Ubuntu SMP Mon Aug 14 14:14:14 UTC 2023 x86_64 x86_64 x86_64 GNU/Linux 19:53:43 up 4 days, 19 min, 6 users, load average: 1.00, 0.99, 0.84
2023-09-17 > compile NEMU 221830012 茆弘之 Linux pc 5.15.0-82-generic #91-Ubuntu SMP Mon Aug 14 14:14:14 UTC 2023 x86_64 x86_64 x86_64 GNU/Linux 19:53:43 up 4 days, 19 min, 6 users, load average: 1.00, 0.99, 0.84
2023-09-17 > run NEMU 221830012 茆弘之 Linux pc 5.15.0-82-generic #91-Ubuntu SMP Mon Aug 14 14:14:14 UTC 2023 x86_64 x86_64 x86_64 GNU/Linux 19:53:44 up 4 days, 19 min, 6 users, load average: 1.00, 0.99, 0.84
2023-09-17 > compile NEMU 221830012 茆弘之 Linux pc 5.15.0-82-generic #91-Ubuntu SMP Mon Aug 14 14:14:14 UTC 2023 x86_64 x86_64 x86_64 GNU/Linux 19:53:44 up 4 days, 19 min, 6 users, load average: 1.08, 1.00, 0.85
2023-09-17 > run NEMU 221830012 茆弘之 Linux pc 5.15.0-82-generic #91-Ubuntu SMP Mon Aug 14 14:14:14 UTC 2023 x86_64 x86_64 x86_64 GNU/Linux 19:53:45 up 4 days, 19 min, 6 users, load average: 1.08, 1.00, 0.85
2023-09-17 > compile NEMU 221830012 茆弘之 Linux pc 5.15.0-82-generic #91-Ubuntu SMP Mon Aug 14 14:14:14 UTC 2023 x86_64 x86_64 x86_64 GNU/Linux 19:53:46 up 4 days, 19 min, 6 users, load average: 1.08, 1.00, 0.85
2023-09-17 > run NEMU 221830012 茆弘之 Linux pc 5.15.0-82-generic #91-Ubuntu SMP Mon Aug 14 14:14:14 UTC 2023 x86_64 x86_64 x86_64 GNU/Linux 19:53:46 up 4 days, 19 min, 6 users, load average: 1.08, 1.00, 0.85
2023-09-17 > compile NEMU 221830012 茆弘之 Linux pc 5.15.0-82-generic #91-Ubuntu SMP Mon Aug 14 14:14:14 UTC 2023 x86_64 x86_64 x86_64 GNU/Linux 19:53:47 up 4 days, 19 min, 6 users, load average: 1.08, 1.00, 0.85
2023-09-17 > run NEMU 221830012 茆弘之 Linux pc 5.15.0-82-generic #91-Ubuntu SMP Mon Aug 14 14:14:14 UTC 2023 x86_64 x86_64 x86_64 GNU/Linux 19:53:47 up 4 days, 19 min, 6 users, load average: 1.08, 1.00, 0.85
2023-09-17 > compile NEMU 221830012 茆弘之 Linux pc 5.15.0-82-generic #91-Ubuntu SMP Mon Aug 14 14:14:14 UTC 2023 x86_64 x86_64 x86_64 GNU/Linux 19:53:48 up 4 days, 19 min, 6 users, load average: 1.08, 1.00, 0.85
2023-09-17 > run NEMU 221830012 茆弘之 Linux pc 5.15.0-82-generic #91-Ubuntu SMP Mon Aug 14 14:14:14 UTC 2023 x86_64 x86_64 x86_64 GNU/Linux 19:53:48 up 4 days, 19 min, 6 users, load average: 1.08, 1.00, 0.85
2023-09-17 > compile NEMU 221830012 茆弘之 Linux pc 5.15.0-82-generic #91-Ubuntu SMP Mon Aug 14 14:14:14 UTC 2023 x86_64 x86_64 x86_64 GNU/Linux 19:53:49 up 4 days, 19 min, 6 users, load average: 1.08, 1.00, 0.85
2023-09-17 > run NEMU 221830012 茆弘之 Linux pc 5.15.0-82-generic #91-Ubuntu SMP Mon Aug 14 14:14:14 UTC 2023 x86_64 x86_64 x86_64 GNU/Linux 19:53:49 up 4 days, 19 min, 6 users, load average: 1.07, 1.00, 0.85
2023-09-17 > compile NEMU 221830012 茆弘之 Linux pc 5.15.0-82-generic #91-Ubuntu SMP Mon Aug 14 14:14:14 UTC 2023 x86_64 x86_64 x86_64 GNU/Linux 19:53:50 up 4 days, 19 min, 6 users, load average: 1.07, 1.00, 0.85
2023-09-17 > run NEMU 221830012 茆弘之 Linux pc 5.15.0-82-generic #91-Ubuntu SMP Mon Aug 14 14:14:14 UTC 2023 x86_64 x86_64 x86_64 GNU/Linux 19:53:51 up 4 days, 19 min, 6 users, load average: 1.07, 1.00, 0.85
2023-09-17 > compile NEMU 221830012 茆弘之 Linux pc 5.15.0-82-generic #91-Ubuntu SMP Mon Aug 14 14:14:14 UTC 2023 x86_64 x86_64 x86_64 GNU/Linux 19:53:51 up 4 days, 19 min, 6 users, load average: 1.07, 1.00, 0.85
2023-09-17 > run NEMU 221830012 茆弘之 Linux pc 5.15.0-82-generic #91-Ubuntu SMP Mon Aug 14 14:14:14 UTC 2023 x86_64 x86_64 x86_64 GNU/Linux 19:53:52 up 4 days, 19 min, 6 users, load average: 1.07, 1.00, 0.85
2023-09-17 > compile NEMU 221830012 茆弘之 Linux pc 5.15.0-82-generic #91-Ubuntu SMP Mon Aug 14 14:14:14 UTC 2023 x86_64 x86_64 x86_64 GNU/Linux 19:53:52 up 4 days, 19 min, 6 users, load average: 1.07, 1.00, 0.85
2023-09-17 > run NEMU 221830012 茆弘之 Linux pc 5.15.0-82-generic #91-Ubuntu SMP Mon Aug 14 14:14:14 UTC 2023 x86_64 x86_64 x86_64 GNU/Linux 19:53:53 up 4 days, 19 min, 6 users, load average: 1.07, 1.00, 0.85
2023-09-17 > compile NEMU 221830012 茆弘之 Linux pc 5.15.0-82-generic #91-Ubuntu SMP Mon Aug 14 14:14:14 UTC 2023 x86_64 x86_64 x86_64 GNU/Linux 19:53:53 up 4 days, 19 min, 6 users, load average: 1.07, 1.00, 0.85
2023-09-17 > run NEMU 221830012 茆弘之 Linux pc 5.15.0-82-generic #91-Ubuntu SMP Mon Aug 14 14:14:14 UTC 2023 x86_64 x86_64 x86_64 GNU/Linux 19:53:54 up 4 days, 19 min, 6 users, load average: 1.07, 1.00, 0.85
2023-09-17 > compile NEMU 221830012 茆弘之 Linux pc 5.15.0-82-generic #91-Ubuntu SMP Mon Aug 14 14:14:14 UTC 2023 x86_64 x86_64 x86_64 GNU/Linux 19:53:55 up 4 days, 19 min, 6 users, load average: 1.06, 1.00, 0.85
2023-09-17 > run NEMU 221830012 茆弘之 Linux pc 5.15.0-82-generic #91-Ubuntu SMP Mon Aug 14 14:14:14 UTC 2023 x86_64 x86_64 x86_64 GNU/Linux 19:53:55 up 4 days, 19 min, 6 users, load average: 1.06, 1.00, 0.85
2023-09-17 > compile NEMU 221830012 茆弘之 Linux pc 5.15.0-82-generic #91-Ubuntu SMP Mon Aug 14 14:14:14 UTC 2023 x86_64 x86_64 x86_64 GNU/Linux 19:53:56 up 4 days, 19 min, 6 users, load average: 1.06, 1.00, 0.85
2023-09-17 > run NEMU 221830012 茆弘之 Linux pc 5.15.0-82-generic #91-Ubuntu SMP Mon Aug 14 14:14:14 UTC 2023 x86_64 x86_64 x86_64 GNU/Linux 19:53:56 up 4 days, 19 min, 6 users, load average: 1.06, 1.00, 0.85
2023-09-17 > compile NEMU 221830012 茆弘之 Linux pc 5.15.0-82-generic #91-Ubuntu SMP Mon Aug 14 14:14:14 UTC 2023 x86_64 x86_64 x86_64 GNU/Linux 19:53:57 up 4 days, 19 min, 6 users, load average: 1.06, 1.00, 0.85
2023-09-17 > run NEMU 221830012 茆弘之 Linux pc 5.15.0-82-generic #91-Ubuntu SMP Mon Aug 14 14:14:14 UTC 2023 x86_64 x86_64 x86_64 GNU/Linux 19:53:57 up 4 days, 19 min, 6 users, load average: 1.06, 1.00, 0.85
2023-09-17 > compile NEMU 221830012 茆弘之 Linux pc 5.15.0-82-generic #91-Ubuntu SMP Mon Aug 14 14:14:14 UTC 2023 x86_64 x86_64 x86_64 GNU/Linux 19:53:58 up 4 days, 19 min, 6 users, load average: 1.06, 1.00, 0.85
2023-09-17 > run NEMU 221830012 茆弘之 Linux pc 5.15.0-82-generic #91-Ubuntu SMP Mon Aug 14 14:14:14 UTC 2023 x86_64 x86_64 x86_64 GNU/Linux 19:53:58 up 4 days, 19 min, 6 users, load average: 1.06, 1.00, 0.85
2023-09-17 > compile NEMU 221830012 茆弘之 Linux pc 5.15.0-82-generic #91-Ubuntu SMP Mon Aug 14 14:14:14 UTC 2023 x86_64 x86_64 x86_64 GNU/Linux 19:53:59 up 4 days, 19 min, 6 users, load average: 1.06, 1.00, 0.85
2023-09-17 > run NEMU 221830012 茆弘之 Linux pc 5.15.0-82-generic #91-Ubuntu SMP Mon Aug 14 14:14:14 UTC 2023 x86_64 x86_64 x86_64 GNU/Linux 19:54:00 up 4 days, 19 min, 6 users, load average: 1.06, 1.00, 0.85
2023-09-17 > compile NEMU 221830012 茆弘之 Linux pc 5.15.0-82-generic #91-Ubuntu SMP Mon Aug 14 14:14:14 UTC 2023 x86_64 x86_64 x86_64 GNU/Linux 19:54:00 up 4 days, 19 min, 6 users, load average: 1.06, 1.00, 0.85
2023-09-17 > run NEMU 221830012 茆弘之 Linux pc 5.15.0-82-generic #91-Ubuntu SMP Mon Aug 14 14:14:14 UTC 2023 x86_64 x86_64 x86_64 GNU/Linux 19:54:01 up 4 days, 19 min, 6 users, load average: 1.06, 1.00, 0.85
2023-09-17 > compile NEMU 221830012 茆弘之 Linux pc 5.15.0-82-generic #91-Ubuntu SMP Mon Aug 14 14:14:14 UTC 2023 x86_64 x86_64 x86_64 GNU/Linux 19:54:02 up 4 days, 19 min, 6 users, load average: 1.06, 1.00, 0.85
2023-09-17 > run NEMU 221830012 茆弘之 Linux pc 5.15.0-82-generic #91-Ubuntu SMP Mon Aug 14 14:14:14 UTC 2023 x86_64 x86_64 x86_64 GNU/Linux 19:54:02 up 4 days, 19 min, 6 users, load average: 1.06, 1.00, 0.85
2023-09-17 > compile NEMU 221830012 茆弘之 Linux pc 5.15.0-82-generic #91-Ubuntu SMP Mon Aug 14 14:14:14 UTC 2023 x86_64 x86_64 x86_64 GNU/Linux 19:54:03 up 4 days, 19 min, 6 users, load average: 1.06, 1.00, 0.85
2023-09-17 > run NEMU 221830012 茆弘之 Linux pc 5.15.0-82-generic #91-Ubuntu SMP Mon Aug 14 14:14:14 UTC 2023 x86_64 x86_64 x86_64 GNU/Linux 19:54:03 up 4 days, 19 min, 6 users, load average: 1.06, 1.00, 0.85
2023-09-17 > compile NEMU 221830012 茆弘之 Linux pc 5.15.0-82-generic #91-Ubuntu SMP Mon Aug 14 14:14:14 UTC 2023 x86_64 x86_64 x86_64 GNU/Linux 19:54:04 up 4 days, 19 min, 6 users, load average: 1.06, 1.00, 0.85
2023-09-17 > run NEMU 221830012 茆弘之 Linux pc 5.15.0-82-generic #91-Ubuntu SMP Mon Aug 14 14:14:14 UTC 2023 x86_64 x86_64 x86_64 GNU/Linux 19:54:04 up 4 days, 19 min, 6 users, load average: 1.06, 1.00, 0.85
2023-09-17 > compile NEMU 221830012 茆弘之 Linux pc 5.15.0-82-generic #91-Ubuntu SMP Mon Aug 14 14:14:14 UTC 2023 x86_64 x86_64 x86_64 GNU/Linux 19:54:05 up 4 days, 19 min, 6 users, load average: 1.13, 1.02, 0.86
2023-09-17 > run NEMU 221830012 茆弘之 Linux pc 5.15.0-82-generic #91-Ubuntu SMP Mon Aug 14 14:14:14 UTC 2023 x86_64 x86_64 x86_64 GNU/Linux 19:54:05 up 4 days, 20 min, 6 users, load average: 1.13, 1.02, 0.86
2023-09-17 > compile NEMU 221830012 茆弘之 Linux pc 5.15.0-82-generic #91-Ubuntu SMP Mon Aug 14 14:14:14 UTC 2023 x86_64 x86_64 x86_64 GNU/Linux 19:54:06 up 4 days, 20 min, 6 users, load average: 1.13, 1.02, 0.86
2023-09-17 > run NEMU 221830012 茆弘之 Linux pc 5.15.0-82-generic #91-Ubuntu SMP Mon Aug 14 14:14:14 UTC 2023 x86_64 x86_64 x86_64 GNU/Linux 19:54:06 up 4 days, 20 min, 6 users, load average: 1.13, 1.02, 0.86
2023-09-17 > compile NEMU 221830012 茆弘之 Linux pc 5.15.0-82-generic #91-Ubuntu SMP Mon Aug 14 14:14:14 UTC 2023 x86_64 x86_64 x86_64 GNU/Linux 19:54:07 up 4 days, 20 min, 6 users, load average: 1.13, 1.02, 0.86
2023-09-17 > run NEMU 221830012 茆弘之 Linux pc 5.15.0-82-generic #91-Ubuntu SMP Mon Aug 14 14:14:14 UTC 2023 x86_64 x86_64 x86_64 GNU/Linux 19:54:08 up 4 days, 20 min, 6 users, load average: 1.13, 1.02, 0.86
2023-09-17 > compile NEMU 221830012 茆弘之 Linux pc 5.15.0-82-generic #91-Ubuntu SMP Mon Aug 14 14:14:14 UTC 2023 x86_64 x86_64 x86_64 GNU/Linux 19:54:08 up 4 days, 20 min, 6 users, load average: 1.13, 1.02, 0.86
2023-09-17 > run NEMU 221830012 茆弘之 Linux pc 5.15.0-82-generic #91-Ubuntu SMP Mon Aug 14 14:14:14 UTC 2023 x86_64 x86_64 x86_64 GNU/Linux 19:54:09 up 4 days, 20 min, 6 users, load average: 1.13, 1.02, 0.86
2023-09-17 > compile NEMU 221830012 茆弘之 Linux pc 5.15.0-82-generic #91-Ubuntu SMP Mon Aug 14 14:14:14 UTC 2023 x86_64 x86_64 x86_64 GNU/Linux 19:54:09 up 4 days, 20 min, 6 users, load average: 1.20, 1.04, 0.87
2023-09-17 > run NEMU 221830012 茆弘之 Linux pc 5.15.0-82-generic #91-Ubuntu SMP Mon Aug 14 14:14:14 UTC 2023 x86_64 x86_64 x86_64 GNU/Linux 19:54:10 up 4 days, 20 min, 6 users, load average: 1.20, 1.04, 0.87
2023-09-17 > compile NEMU 221830012 茆弘之 Linux pc 5.15.0-82-generic #91-Ubuntu SMP Mon Aug 14 14:14:14 UTC 2023 x86_64 x86_64 x86_64 GNU/Linux 19:54:10 up 4 days, 20 min, 6 users, load average: 1.20, 1.04, 0.87
2023-09-17 > run NEMU 221830012 茆弘之 Linux pc 5.15.0-82-generic #91-Ubuntu SMP Mon Aug 14 14:14:14 UTC 2023 x86_64 x86_64 x86_64 GNU/Linux 19:54:11 up 4 days, 20 min, 6 users, load average: 1.20, 1.04, 0.87
2023-09-17 > compile NEMU 221830012 茆弘之 Linux pc 5.15.0-82-generic #91-Ubuntu SMP Mon Aug 14 14:14:14 UTC 2023 x86_64 x86_64 x86_64 GNU/Linux 19:54:12 up 4 days, 20 min, 6 users, load average: 1.20, 1.04, 0.87
2023-09-17 > run NEMU 221830012 茆弘之 Linux pc 5.15.0-82-generic #91-Ubuntu SMP Mon Aug 14 14:14:14 UTC 2023 x86_64 x86_64 x86_64 GNU/Linux 19:54:12 up 4 days, 20 min, 6 users, load average: 1.20, 1.04, 0.87
2023-09-17 > compile NEMU 221830012 茆弘之 Linux pc 5.15.0-82-generic #91-Ubuntu SMP Mon Aug 14 14:14:14 UTC 2023 x86_64 x86_64 x86_64 GNU/Linux 19:54:13 up 4 days, 20 min, 6 users, load average: 1.20, 1.04, 0.87
2023-09-17 > run NEMU 221830012 茆弘之 Linux pc 5.15.0-82-generic #91-Ubuntu SMP Mon Aug 14 14:14:14 UTC 2023 x86_64 x86_64 x86_64 GNU/Linux 19:54:13 up 4 days, 20 min, 6 users, load average: 1.20, 1.04, 0.87
2023-09-17 > compile NEMU 221830012 茆弘之 Linux pc 5.15.0-82-generic #91-Ubuntu SMP Mon Aug 14 14:14:14 UTC 2023 x86_64 x86_64 x86_64 GNU/Linux 19:54:14 up 4 days, 20 min, 6 users, load average: 1.20, 1.04, 0.87
2023-09-17 > run NEMU 221830012 茆弘之 Linux pc 5.15.0-82-generic #91-Ubuntu SMP Mon Aug 14 14:14:14 UTC 2023 x86_64 x86_64 x86_64 GNU/Linux 19:54:14 up 4 days, 20 min, 6 users, load average: 1.20, 1.04, 0.87
2023-09-17 > compile NEMU 221830012 茆弘之 Linux pc 5.15.0-82-generic #91-Ubuntu SMP Mon Aug 14 14:14:14 UTC 2023 x86_64 x86_64 x86_64 GNU/Linux 19:54:15 up 4 days, 20 min, 6 users, load average: 1.19, 1.04, 0.87
2023-09-17 > run NEMU 221830012 茆弘之 Linux pc 5.15.0-82-generic #91-Ubuntu SMP Mon Aug 14 14:14:14 UTC 2023 x86_64 x86_64 x86_64 GNU/Linux 19:54:15 up 4 days, 20 min, 6 users, load average: 1.19, 1.04, 0.87
2023-09-17 > compile NEMU 221830012 茆弘之 Linux pc 5.15.0-82-generic #91-Ubuntu SMP Mon Aug 14 14:14:14 UTC 2023 x86_64 x86_64 x86_64 GNU/Linux 19:54:16 up 4 days, 20 min, 6 users, load average: 1.19, 1.04, 0.87
2023-09-17 > run NEMU 221830012 茆弘之 Linux pc 5.15.0-82-generic #91-Ubuntu SMP Mon Aug 14 14:14:14 UTC 2023 x86_64 x86_64 x86_64 GNU/Linux 19:54:17 up 4 days, 20 min, 6 users, load average: 1.19, 1.04, 0.87
2023-09-17 > compile NEMU 221830012 茆弘之 Linux pc 5.15.0-82-generic #91-Ubuntu SMP Mon Aug 14 14:14:14 UTC 2023 x86_64 x86_64 x86_64 GNU/Linux 19:54:17 up 4 days, 20 min, 6 users, load average: 1.19, 1.04, 0.87
2023-09-17 > run NEMU 221830012 茆弘之 Linux pc 5.15.0-82-generic #91-Ubuntu SMP Mon Aug 14 14:14:14 UTC 2023 x86_64 x86_64 x86_64 GNU/Linux 19:54:18 up 4 days, 20 min, 6 users, load average: 1.19, 1.04, 0.87
2023-09-17 > compile NEMU 221830012 茆弘之 Linux pc 5.15.0-82-generic #91-Ubuntu SMP Mon Aug 14 14:14:14 UTC 2023 x86_64 x86_64 x86_64 GNU/Linux 19:54:18 up 4 days, 20 min, 6 users, load average: 1.19, 1.04, 0.87
2023-09-17 > run NEMU 221830012 茆弘之 Linux pc 5.15.0-82-generic #91-Ubuntu SMP Mon Aug 14 14:14:14 UTC 2023 x86_64 x86_64 x86_64 GNU/Linux 19:54:19 up 4 days, 20 min, 6 users, load average: 1.19, 1.04, 0.87
2023-09-17 > compile NEMU 221830012 茆弘之 Linux pc 5.15.0-82-generic #91-Ubuntu SMP Mon Aug 14 14:14:14 UTC 2023 x86_64 x86_64 x86_64 GNU/Linux 19:54:20 up 4 days, 20 min, 6 users, load average: 1.33, 1.07, 0.88
2023-09-17 > run NEMU 221830012 茆弘之 Linux pc 5.15.0-82-generic #91-Ubuntu SMP Mon Aug 14 14:14:14 UTC 2023 x86_64 x86_64 x86_64 GNU/Linux 19:54:20 up 4 days, 20 min, 6 users, load average: 1.33, 1.07, 0.88
2023-09-17 > compile NEMU 221830012 茆弘之 Linux pc 5.15.0-82-generic #91-Ubuntu SMP Mon Aug 14 14:14:14 UTC 2023 x86_64 x86_64 x86_64 GNU/Linux 19:54:21 up 4 days, 20 min, 6 users, load average: 1.33, 1.07, 0.88
2023-09-17 > run NEMU 221830012 茆弘之 Linux pc 5.15.0-82-generic #91-Ubuntu SMP Mon Aug 14 14:14:14 UTC 2023 x86_64 x86_64 x86_64 GNU/Linux 19:54:21 up 4 days, 20 min, 6 users, load average: 1.33, 1.07, 0.88
2023-09-17 > compile NEMU 221830012 茆弘之 Linux pc 5.15.0-82-generic #91-Ubuntu SMP Mon Aug 14 14:14:14 UTC 2023 x86_64 x86_64 x86_64 GNU/Linux 19:54:22 up 4 days, 20 min, 6 users, load average: 1.33, 1.07, 0.88
2023-09-17 > compile NEMU 221830012 茆弘之 Linux pc 5.15.0-82-generic #91-Ubuntu SMP Mon Aug 14 14:14:14 UTC 2023 x86_64 x86_64 x86_64 GNU/Linux 19:54:30 up 4 days, 20 min, 6 users, load average: 1.20, 1.05, 0.87
2023-09-17 > run NEMU 221830012 茆弘之 Linux pc 5.15.0-82-generic #91-Ubuntu SMP Mon Aug 14 14:14:14 UTC 2023 x86_64 x86_64 x86_64 GNU/Linux 19:54:30 up 4 days, 20 min, 6 users, load average: 1.20, 1.05, 0.87
2023-09-17 > compile NEMU 221830012 茆弘之 Linux pc 5.15.0-82-generic #91-Ubuntu SMP Mon Aug 14 14:14:14 UTC 2023 x86_64 x86_64 x86_64 GNU/Linux 19:54:37 up 4 days, 20 min, 6 users, load average: 1.10, 1.03, 0.87
2023-09-17 > run NEMU 221830012 茆弘之 Linux pc 5.15.0-82-generic #91-Ubuntu SMP Mon Aug 14 14:14:14 UTC 2023 x86_64 x86_64 x86_64 GNU/Linux 19:54:37 up 4 days, 20 min, 6 users, load average: 1.10, 1.03, 0.87
2023-09-17 > compile NEMU 221830012 茆弘之 Linux pc 5.15.0-82-generic #91-Ubuntu SMP Mon Aug 14 14:14:14 UTC 2023 x86_64 x86_64 x86_64 GNU/Linux 19:57:09 up 4 days, 23 min, 6 users, load average: 0.33, 0.75, 0.79
2023-09-17 > run NEMU 221830012 茆弘之 Linux pc 5.15.0-82-generic #91-Ubuntu SMP Mon Aug 14 14:14:14 UTC 2023 x86_64 x86_64 x86_64 GNU/Linux 19:57:10 up 4 days, 23 min, 6 users, load average: 0.46, 0.78, 0.80
2023-09-17 > compile NEMU 221830012 茆弘之 Linux pc 5.15.0-82-generic #91-Ubuntu SMP Mon Aug 14 14:14:14 UTC 2023 x86_64 x86_64 x86_64 GNU/Linux 19:57:19 up 4 days, 23 min, 6 users, load average: 0.50, 0.78, 0.80
2023-09-17 > run NEMU 221830012 茆弘之 Linux pc 5.15.0-82-generic #91-Ubuntu SMP Mon Aug 14 14:14:14 UTC 2023 x86_64 x86_64 x86_64 GNU/Linux 19:57:19 up 4 days, 23 min, 6 users, load average: 0.50, 0.78, 0.80
2023-09-17 > compile NEMU 221830012 茆弘之 Linux pc 5.15.0-82-generic #91-Ubuntu SMP Mon Aug 14 14:14:14 UTC 2023 x86_64 x86_64 x86_64 GNU/Linux 20:02:27 up 4 days, 28 min, 6 users, load average: 0.51, 0.69, 0.76
2023-09-17 > compile NEMU 221830012 茆弘之 Linux pc 5.15.0-82-generic #91-Ubuntu SMP Mon Aug 14 14:14:14 UTC 2023 x86_64 x86_64 x86_64 GNU/Linux 20:02:54 up 4 days, 28 min, 6 users, load average: 0.75, 0.73, 0.77
2023-09-17 > compile NEMU 221830012 茆弘之 Linux pc 5.15.0-82-generic #91-Ubuntu SMP Mon Aug 14 14:14:14 UTC 2023 x86_64 x86_64 x86_64 GNU/Linux 20:05:47 up 4 days, 31 min, 6 users, load average: 0.34, 0.57, 0.70
2023-09-17 > run NEMU 221830012 茆弘之 Linux pc 5.15.0-82-generic #91-Ubuntu SMP Mon Aug 14 14:14:14 UTC 2023 x86_64 x86_64 x86_64 GNU/Linux 20:07:25 up 4 days, 33 min, 6 users, load average: 1.62, 0.92, 0.82
2023-09-17 > compile NEMU 221830012 茆弘之 Linux pc 5.15.0-82-generic #91-Ubuntu SMP Mon Aug 14 14:14:14 UTC 2023 x86_64 x86_64 x86_64 GNU/Linux 20:52:35 up 4 days, 1:18, 6 users, load average: 0.53, 0.63, 0.64
2023-09-17 > run NEMU 221830012 茆弘之 Linux pc 5.15.0-82-generic #91-Ubuntu SMP Mon Aug 14 14:14:14 UTC 2023 x86_64 x86_64 x86_64 GNU/Linux 20:52:36 up 4 days, 1:18, 6 users, load average: 0.53, 0.63, 0.64
2023-09-17 > compile NEMU 221830012 茆弘之 Linux pc 5.15.0-82-generic #91-Ubuntu SMP Mon Aug 14 14:14:14 UTC 2023 x86_64 x86_64 x86_64 GNU/Linux 22:12:01 up 4 days, 2:37, 6 users, load average: 0.95, 0.96, 0.85
2023-09-17 > run NEMU 221830012 茆弘之 Linux pc 5.15.0-82-generic #91-Ubuntu SMP Mon Aug 14 14:14:14 UTC 2023 x86_64 x86_64 x86_64 GNU/Linux 22:12:03 up 4 days, 2:37, 6 users, load average: 0.95, 0.96, 0.85
2023-09-17 > compile NEMU 221830012 茆弘之 Linux pc 5.15.0-82-generic #91-Ubuntu SMP Mon Aug 14 14:14:14 UTC 2023 x86_64 x86_64 x86_64 GNU/Linux 22:12:05 up 4 days, 2:37, 6 users, load average: 0.95, 0.96, 0.85
2023-09-17 > run NEMU 221830012 茆弘之 Linux pc 5.15.0-82-generic #91-Ubuntu SMP Mon Aug 14 14:14:14 UTC 2023 x86_64 x86_64 x86_64 GNU/Linux 22:12:07 up 4 days, 2:38, 6 users, load average: 0.96, 0.96, 0.85
2023-09-17 > compile NEMU 221830012 茆弘之 Linux pc 5.15.0-82-generic #91-Ubuntu SMP Mon Aug 14 14:14:14 UTC 2023 x86_64 x86_64 x86_64 GNU/Linux 22:12:08 up 4 days, 2:38, 6 users, load average: 0.96, 0.96, 0.85
2023-09-17 > run NEMU 221830012 茆弘之 Linux pc 5.15.0-82-generic #91-Ubuntu SMP Mon Aug 14 14:14:14 UTC 2023 x86_64 x86_64 x86_64 GNU/Linux 22:12:10 up 4 days, 2:38, 6 users, load average: 0.96, 0.96, 0.85
2023-09-17 > compile NEMU 221830012 茆弘之 Linux pc 5.15.0-82-generic #91-Ubuntu SMP Mon Aug 14 14:14:14 UTC 2023 x86_64 x86_64 x86_64 GNU/Linux 22:12:11 up 4 days, 2:38, 6 users, load average: 0.96, 0.96, 0.85
2023-09-17 > run NEMU 221830012 茆弘之 Linux pc 5.15.0-82-generic #91-Ubuntu SMP Mon Aug 14 14:14:14 UTC 2023 x86_64 x86_64 x86_64 GNU/Linux 22:12:13 up 4 days, 2:38, 6 users, load average: 0.96, 0.96, 0.85
2023-09-17 > compile NEMU 221830012 茆弘之 Linux pc 5.15.0-82-generic #91-Ubuntu SMP Mon Aug 14 14:14:14 UTC 2023 x86_64 x86_64 x86_64 GNU/Linux 22:12:14 up 4 days, 2:38, 6 users, load average: 0.96, 0.96, 0.85
2023-09-17 > run NEMU 221830012 茆弘之 Linux pc 5.15.0-82-generic #91-Ubuntu SMP Mon Aug 14 14:14:14 UTC 2023 x86_64 x86_64 x86_64 GNU/Linux 22:12:16 up 4 days, 2:38, 6 users, load average: 0.96, 0.96, 0.85
2023-09-17 > compile NEMU 221830012 茆弘之 Linux pc 5.15.0-82-generic #91-Ubuntu SMP Mon Aug 14 14:14:14 UTC 2023 x86_64 x86_64 x86_64 GNU/Linux 22:12:17 up 4 days, 2:38, 6 users, load average: 1.04, 0.98, 0.85
2023-09-17 > run NEMU 221830012 茆弘之 Linux pc 5.15.0-82-generic #91-Ubuntu SMP Mon Aug 14 14:14:14 UTC 2023 x86_64 x86_64 x86_64 GNU/Linux 22:12:19 up 4 days, 2:38, 6 users, load average: 1.04, 0.98, 0.85
2023-09-17 > compile NEMU 221830012 茆弘之 Linux pc 5.15.0-82-generic #91-Ubuntu SMP Mon Aug 14 14:14:14 UTC 2023 x86_64 x86_64 x86_64 GNU/Linux 22:12:20 up 4 days, 2:38, 6 users, load average: 1.04, 0.98, 0.85
2023-09-17 > run NEMU 221830012 茆弘之 Linux pc 5.15.0-82-generic #91-Ubuntu SMP Mon Aug 14 14:14:14 UTC 2023 x86_64 x86_64 x86_64 GNU/Linux 22:12:22 up 4 days, 2:38, 6 users, load average: 1.12, 1.00, 0.86
2023-09-17 > compile NEMU 221830012 茆弘之 Linux pc 5.15.0-82-generic #91-Ubuntu SMP Mon Aug 14 14:14:14 UTC 2023 x86_64 x86_64 x86_64 GNU/Linux 22:12:23 up 4 days, 2:38, 6 users, load average: 1.12, 1.00, 0.86
2023-09-17 > run NEMU 221830012 茆弘之 Linux pc 5.15.0-82-generic #91-Ubuntu SMP Mon Aug 14 14:14:14 UTC 2023 x86_64 x86_64 x86_64 GNU/Linux 22:12:25 up 4 days, 2:38, 6 users, load average: 1.12, 1.00, 0.86
2023-09-17 > compile NEMU 221830012 茆弘之 Linux pc 5.15.0-82-generic #91-Ubuntu SMP Mon Aug 14 14:14:14 UTC 2023 x86_64 x86_64 x86_64 GNU/Linux 22:12:26 up 4 days, 2:38, 6 users, load average: 1.19, 1.01, 0.87
2023-09-17 > run NEMU 221830012 茆弘之 Linux pc 5.15.0-82-generic #91-Ubuntu SMP Mon Aug 14 14:14:14 UTC 2023 x86_64 x86_64 x86_64 GNU/Linux 22:12:28 up 4 days, 2:38, 6 users, load average: 1.19, 1.01, 0.87
2023-09-17 > compile NEMU 221830012 茆弘之 Linux pc 5.15.0-82-generic #91-Ubuntu SMP Mon Aug 14 14:14:14 UTC 2023 x86_64 x86_64 x86_64 GNU/Linux 22:12:30 up 4 days, 2:38, 6 users, load average: 1.19, 1.01, 0.87
2023-09-17 > run NEMU 221830012 茆弘之 Linux pc 5.15.0-82-generic #91-Ubuntu SMP Mon Aug 14 14:14:14 UTC 2023 x86_64 x86_64 x86_64 GNU/Linux 22:12:31 up 4 days, 2:38, 6 users, load average: 1.26, 1.03, 0.87
2023-09-17 > compile NEMU 221830012 茆弘之 Linux pc 5.15.0-82-generic #91-Ubuntu SMP Mon Aug 14 14:14:14 UTC 2023 x86_64 x86_64 x86_64 GNU/Linux 22:12:33 up 4 days, 2:38, 6 users, load average: 1.26, 1.03, 0.87
2023-09-17 > run NEMU 221830012 茆弘之 Linux pc 5.15.0-82-generic #91-Ubuntu SMP Mon Aug 14 14:14:14 UTC 2023 x86_64 x86_64 x86_64 GNU/Linux 22:12:35 up 4 days, 2:38, 6 users, load average: 1.26, 1.03, 0.87
2023-09-17 > compile NEMU 221830012 茆弘之 Linux pc 5.15.0-82-generic #91-Ubuntu SMP Mon Aug 14 14:14:14 UTC 2023 x86_64 x86_64 x86_64 GNU/Linux 22:12:36 up 4 days, 2:38, 6 users, load average: 1.26, 1.03, 0.87
2023-09-17 > run NEMU 221830012 茆弘之 Linux pc 5.15.0-82-generic #91-Ubuntu SMP Mon Aug 14 14:14:14 UTC 2023 x86_64 x86_64 x86_64 GNU/Linux 22:12:38 up 4 days, 2:38, 6 users, load average: 1.48, 1.08, 0.89
2023-09-17 > compile NEMU 221830012 茆弘之 Linux pc 5.15.0-82-generic #91-Ubuntu SMP Mon Aug 14 14:14:14 UTC 2023 x86_64 x86_64 x86_64 GNU/Linux 22:12:39 up 4 days, 2:38, 6 users, load average: 1.48, 1.08, 0.89
2023-09-17 > run NEMU 221830012 茆弘之 Linux pc 5.15.0-82-generic #91-Ubuntu SMP Mon Aug 14 14:14:14 UTC 2023 x86_64 x86_64 x86_64 GNU/Linux 22:12:41 up 4 days, 2:38, 6 users, load average: 1.48, 1.08, 0.89
2023-09-17 > compile NEMU 221830012 茆弘之 Linux pc 5.15.0-82-generic #91-Ubuntu SMP Mon Aug 14 14:14:14 UTC 2023 x86_64 x86_64 x86_64 GNU/Linux 22:12:42 up 4 days, 2:38, 6 users, load average: 1.52, 1.10, 0.90
2023-09-17 > run NEMU 221830012 茆弘之 Linux pc 5.15.0-82-generic #91-Ubuntu SMP Mon Aug 14 14:14:14 UTC 2023 x86_64 x86_64 x86_64 GNU/Linux 22:12:44 up 4 days, 2:38, 6 users, load average: 1.52, 1.10, 0.90
2023-09-17 > compile NEMU 221830012 茆弘之 Linux pc 5.15.0-82-generic #91-Ubuntu SMP Mon Aug 14 14:14:14 UTC 2023 x86_64 x86_64 x86_64 GNU/Linux 22:12:45 up 4 days, 2:38, 6 users, load average: 1.52, 1.10, 0.90
2023-09-17 > run NEMU 221830012 茆弘之 Linux pc 5.15.0-82-generic #91-Ubuntu SMP Mon Aug 14 14:14:14 UTC 2023 x86_64 x86_64 x86_64 GNU/Linux 22:12:47 up 4 days, 2:38, 6 users, load average: 1.72, 1.14, 0.91
2023-09-17 > compile NEMU 221830012 茆弘之 Linux pc 5.15.0-82-generic #91-Ubuntu SMP Mon Aug 14 14:14:14 UTC 2023 x86_64 x86_64 x86_64 GNU/Linux 22:12:49 up 4 days, 2:38, 6 users, load average: 1.72, 1.14, 0.91
2023-09-17 > run NEMU 221830012 茆弘之 Linux pc 5.15.0-82-generic #91-Ubuntu SMP Mon Aug 14 14:14:14 UTC 2023 x86_64 x86_64 x86_64 GNU/Linux 22:12:50 up 4 days, 2:38, 6 users, load average: 1.72, 1.14, 0.91
2023-09-17 > compile NEMU 221830012 茆弘之 Linux pc 5.15.0-82-generic #91-Ubuntu SMP Mon Aug 14 14:14:14 UTC 2023 x86_64 x86_64 x86_64 GNU/Linux 22:12:52 up 4 days, 2:38, 6 users, load average: 1.66, 1.14, 0.91
2023-09-17 > run NEMU 221830012 茆弘之 Linux pc 5.15.0-82-generic #91-Ubuntu SMP Mon Aug 14 14:14:14 UTC 2023 x86_64 x86_64 x86_64 GNU/Linux 22:12:54 up 4 days, 2:38, 6 users, load average: 1.66, 1.14, 0.91
2023-09-17 > compile NEMU 221830012 茆弘之 Linux pc 5.15.0-82-generic #91-Ubuntu SMP Mon Aug 14 14:14:14 UTC 2023 x86_64 x86_64 x86_64 GNU/Linux 22:12:55 up 4 days, 2:38, 6 users, load average: 1.66, 1.14, 0.91
2023-09-17 > run NEMU 221830012 茆弘之 Linux pc 5.15.0-82-generic #91-Ubuntu SMP Mon Aug 14 14:14:14 UTC 2023 x86_64 x86_64 x86_64 GNU/Linux 22:12:57 up 4 days, 2:38, 6 users, load average: 1.61, 1.14, 0.92
2023-09-17 > compile NEMU 221830012 茆弘之 Linux pc 5.15.0-82-generic #91-Ubuntu SMP Mon Aug 14 14:14:14 UTC 2023 x86_64 x86_64 x86_64 GNU/Linux 22:12:58 up 4 days, 2:38, 6 users, load average: 1.61, 1.14, 0.92
2023-09-17 > run NEMU 221830012 茆弘之 Linux pc 5.15.0-82-generic #91-Ubuntu SMP Mon Aug 14 14:14:14 UTC 2023 x86_64 x86_64 x86_64 GNU/Linux 22:13:00 up 4 days, 2:38, 6 users, load average: 1.61, 1.14, 0.92
2023-09-17 > compile NEMU 221830012 茆弘之 Linux pc 5.15.0-82-generic #91-Ubuntu SMP Mon Aug 14 14:14:14 UTC 2023 x86_64 x86_64 x86_64 GNU/Linux 22:13:01 up 4 days, 2:38, 6 users, load average: 1.56, 1.14, 0.92
2023-09-17 > run NEMU 221830012 茆弘之 Linux pc 5.15.0-82-generic #91-Ubuntu SMP Mon Aug 14 14:14:14 UTC 2023 x86_64 x86_64 x86_64 GNU/Linux 22:13:03 up 4 days, 2:38, 6 users, load average: 1.56, 1.14, 0.92
2023-09-17 > compile NEMU 221830012 茆弘之 Linux pc 5.15.0-82-generic #91-Ubuntu SMP Mon Aug 14 14:14:14 UTC 2023 x86_64 x86_64 x86_64 GNU/Linux 22:13:04 up 4 days, 2:38, 6 users, load average: 1.56, 1.14, 0.92
2023-09-17 > run NEMU 221830012 茆弘之 Linux pc 5.15.0-82-generic #91-Ubuntu SMP Mon Aug 14 14:14:14 UTC 2023 x86_64 x86_64 x86_64 GNU/Linux 22:13:06 up 4 days, 2:39, 6 users, load average: 1.59, 1.15, 0.92
2023-09-17 > compile NEMU 221830012 茆弘之 Linux pc 5.15.0-82-generic #91-Ubuntu SMP Mon Aug 14 14:14:14 UTC 2023 x86_64 x86_64 x86_64 GNU/Linux 22:13:08 up 4 days, 2:39, 6 users, load average: 1.59, 1.15, 0.92
2023-09-17 > run NEMU 221830012 茆弘之 Linux pc 5.15.0-82-generic #91-Ubuntu SMP Mon Aug 14 14:14:14 UTC 2023 x86_64 x86_64 x86_64 GNU/Linux 22:13:10 up 4 days, 2:39, 6 users, load average: 1.59, 1.15, 0.92
2023-09-17 > compile NEMU 221830012 茆弘之 Linux pc 5.15.0-82-generic #91-Ubuntu SMP Mon Aug 14 14:14:14 UTC 2023 x86_64 x86_64 x86_64 GNU/Linux 22:13:11 up 4 days, 2:39, 6 users, load average: 1.59, 1.15, 0.92
2023-09-17 > run NEMU 221830012 茆弘之 Linux pc 5.15.0-82-generic #91-Ubuntu SMP Mon Aug 14 14:14:14 UTC 2023 x86_64 x86_64 x86_64 GNU/Linux 22:13:13 up 4 days, 2:39, 6 users, load average: 1.55, 1.15, 0.92
2023-09-17 > compile NEMU 221830012 茆弘之 Linux pc 5.15.0-82-generic #91-Ubuntu SMP Mon Aug 14 14:14:14 UTC 2023 x86_64 x86_64 x86_64 GNU/Linux 22:13:14 up 4 days, 2:39, 6 users, load average: 1.55, 1.15, 0.92
2023-09-17 > run NEMU 221830012 茆弘之 Linux pc 5.15.0-82-generic #91-Ubuntu SMP Mon Aug 14 14:14:14 UTC 2023 x86_64 x86_64 x86_64 GNU/Linux 22:13:16 up 4 days, 2:39, 6 users, load average: 1.50, 1.14, 0.92
2023-09-17 > compile NEMU 221830012 茆弘之 Linux pc 5.15.0-82-generic #91-Ubuntu SMP Mon Aug 14 14:14:14 UTC 2023 x86_64 x86_64 x86_64 GNU/Linux 22:13:17 up 4 days, 2:39, 6 users, load average: 1.50, 1.14, 0.92
2023-09-17 > run NEMU 221830012 茆弘之 Linux pc 5.15.0-82-generic #91-Ubuntu SMP Mon Aug 14 14:14:14 UTC 2023 x86_64 x86_64 x86_64 GNU/Linux 22:13:19 up 4 days, 2:39, 6 users, load average: 1.50, 1.14, 0.92
2023-09-17 > compile NEMU 221830012 茆弘之 Linux pc 5.15.0-82-generic #91-Ubuntu SMP Mon Aug 14 14:14:14 UTC 2023 x86_64 x86_64 x86_64 GNU/Linux 22:13:21 up 4 days, 2:39, 6 users, load average: 1.50, 1.14, 0.92
2023-09-17 > run NEMU 221830012 茆弘之 Linux pc 5.15.0-82-generic #91-Ubuntu SMP Mon Aug 14 14:14:14 UTC 2023 x86_64 x86_64 x86_64 GNU/Linux 22:13:22 up 4 days, 2:39, 6 users, load average: 1.62, 1.18, 0.93
2023-09-17 > compile NEMU 221830012 茆弘之 Linux pc 5.15.0-82-generic #91-Ubuntu SMP Mon Aug 14 14:14:14 UTC 2023 x86_64 x86_64 x86_64 GNU/Linux 22:13:24 up 4 days, 2:39, 6 users, load average: 1.62, 1.18, 0.93
2023-09-17 > run NEMU 221830012 茆弘之 Linux pc 5.15.0-82-generic #91-Ubuntu SMP Mon Aug 14 14:14:14 UTC 2023 x86_64 x86_64 x86_64 GNU/Linux 22:13:26 up 4 days, 2:39, 6 users, load average: 2.53, 1.37, 1.00
2023-09-17 > compile NEMU 221830012 茆弘之 Linux pc 5.15.0-82-generic #91-Ubuntu SMP Mon Aug 14 14:14:14 UTC 2023 x86_64 x86_64 x86_64 GNU/Linux 22:13:28 up 4 days, 2:39, 6 users, load average: 2.53, 1.37, 1.00
2023-09-17 > run NEMU 221830012 茆弘之 Linux pc 5.15.0-82-generic #91-Ubuntu SMP Mon Aug 14 14:14:14 UTC 2023 x86_64 x86_64 x86_64 GNU/Linux 22:13:30 up 4 days, 2:39, 6 users, load average: 2.53, 1.37, 1.00
2023-09-17 > compile NEMU 221830012 茆弘之 Linux pc 5.15.0-82-generic #91-Ubuntu SMP Mon Aug 14 14:14:14 UTC 2023 x86_64 x86_64 x86_64 GNU/Linux 22:13:32 up 4 days, 2:39, 6 users, load average: 2.65, 1.42, 1.02
2023-09-17 > run NEMU 221830012 茆弘之 Linux pc 5.15.0-82-generic #91-Ubuntu SMP Mon Aug 14 14:14:14 UTC 2023 x86_64 x86_64 x86_64 GNU/Linux 22:13:34 up 4 days, 2:39, 6 users, load average: 2.65, 1.42, 1.02
2023-09-17 > compile NEMU 221830012 茆弘之 Linux pc 5.15.0-82-generic #91-Ubuntu SMP Mon Aug 14 14:14:14 UTC 2023 x86_64 x86_64 x86_64 GNU/Linux 22:13:35 up 4 days, 2:39, 6 users, load average: 2.65, 1.42, 1.02
2023-09-17 > run NEMU 221830012 茆弘之 Linux pc 5.15.0-82-generic #91-Ubuntu SMP Mon Aug 14 14:14:14 UTC 2023 x86_64 x86_64 x86_64 GNU/Linux 22:13:37 up 4 days, 2:39, 6 users, load average: 2.76, 1.46, 1.03
2023-09-17 > compile NEMU 221830012 茆弘之 Linux pc 5.15.0-82-generic #91-Ubuntu SMP Mon Aug 14 14:14:14 UTC 2023 x86_64 x86_64 x86_64 GNU/Linux 22:13:39 up 4 days, 2:39, 6 users, load average: 2.76, 1.46, 1.03
2023-09-17 > run NEMU 221830012 茆弘之 Linux pc 5.15.0-82-generic #91-Ubuntu SMP Mon Aug 14 14:14:14 UTC 2023 x86_64 x86_64 x86_64 GNU/Linux 22:13:41 up 4 days, 2:39, 6 users, load average: 2.76, 1.46, 1.03
2023-09-17 > compile NEMU 221830012 茆弘之 Linux pc 5.15.0-82-generic #91-Ubuntu SMP Mon Aug 14 14:14:14 UTC 2023 x86_64 x86_64 x86_64 GNU/Linux 22:13:42 up 4 days, 2:39, 6 users, load average: 2.94, 1.52, 1.05
2023-09-17 > run NEMU 221830012 茆弘之 Linux pc 5.15.0-82-generic #91-Ubuntu SMP Mon Aug 14 14:14:14 UTC 2023 x86_64 x86_64 x86_64 GNU/Linux 22:13:44 up 4 days, 2:39, 6 users, load average: 2.94, 1.52, 1.05
2023-09-17 > compile NEMU 221830012 茆弘之 Linux pc 5.15.0-82-generic #91-Ubuntu SMP Mon Aug 14 14:14:14 UTC 2023 x86_64 x86_64 x86_64 GNU/Linux 22:13:45 up 4 days, 2:39, 6 users, load average: 2.94, 1.52, 1.05
2023-09-17 > run NEMU 221830012 茆弘之 Linux pc 5.15.0-82-generic #91-Ubuntu SMP Mon Aug 14 14:14:14 UTC 2023 x86_64 x86_64 x86_64 GNU/Linux 22:13:47 up 4 days, 2:39, 6 users, load average: 2.86, 1.53, 1.06
2023-09-17 > compile NEMU 221830012 茆弘之 Linux pc 5.15.0-82-generic #91-Ubuntu SMP Mon Aug 14 14:14:14 UTC 2023 x86_64 x86_64 x86_64 GNU/Linux 22:13:48 up 4 days, 2:39, 6 users, load average: 2.86, 1.53, 1.06
2023-09-17 > run NEMU 221830012 茆弘之 Linux pc 5.15.0-82-generic #91-Ubuntu SMP Mon Aug 14 14:14:14 UTC 2023 x86_64 x86_64 x86_64 GNU/Linux 22:13:50 up 4 days, 2:39, 6 users, load average: 2.86, 1.53, 1.06
2023-09-17 > compile NEMU 221830012 茆弘之 Linux pc 5.15.0-82-generic #91-Ubuntu SMP Mon Aug 14 14:14:14 UTC 2023 x86_64 x86_64 x86_64 GNU/Linux 22:13:52 up 4 days, 2:39, 6 users, load average: 2.87, 1.55, 1.07
2023-09-17 > run NEMU 221830012 茆弘之 Linux pc 5.15.0-82-generic #91-Ubuntu SMP Mon Aug 14 14:14:14 UTC 2023 x86_64 x86_64 x86_64 GNU/Linux 22:13:54 up 4 days, 2:39, 6 users, load average: 2.87, 1.55, 1.07
2023-09-17 > compile NEMU 221830012 茆弘之 Linux pc 5.15.0-82-generic #91-Ubuntu SMP Mon Aug 14 14:14:14 UTC 2023 x86_64 x86_64 x86_64 GNU/Linux 22:13:55 up 4 days, 2:39, 6 users, load average: 2.87, 1.55, 1.07
2023-09-17 > run NEMU 221830012 茆弘之 Linux pc 5.15.0-82-generic #91-Ubuntu SMP Mon Aug 14 14:14:14 UTC 2023 x86_64 x86_64 x86_64 GNU/Linux 22:13:57 up 4 days, 2:39, 6 users, load average: 2.72, 1.54, 1.07
2023-09-17 > compile NEMU 221830012 茆弘之 Linux pc 5.15.0-82-generic #91-Ubuntu SMP Mon Aug 14 14:14:14 UTC 2023 x86_64 x86_64 x86_64 GNU/Linux 22:20:24 up 4 days, 2:46, 6 users, load average: 0.73, 1.00, 0.96
2023-09-17 > run NEMU 221830012 茆弘之 Linux pc 5.15.0-82-generic #91-Ubuntu SMP Mon Aug 14 14:14:14 UTC 2023 x86_64 x86_64 x86_64 GNU/Linux 22:20:26 up 4 days, 2:46, 6 users, load average: 0.73, 1.00, 0.96
2023-09-17 > compile NEMU 221830012 茆弘之 Linux pc 5.15.0-82-generic #91-Ubuntu SMP Mon Aug 14 14:14:14 UTC 2023 x86_64 x86_64 x86_64 GNU/Linux 22:20:27 up 4 days, 2:46, 6 users, load average: 0.67, 0.98, 0.95
2023-09-17 > run NEMU 221830012 茆弘之 Linux pc 5.15.0-82-generic #91-Ubuntu SMP Mon Aug 14 14:14:14 UTC 2023 x86_64 x86_64 x86_64 GNU/Linux 22:20:29 up 4 days, 2:46, 6 users, load average: 0.67, 0.98, 0.95
2023-09-17 > compile NEMU 221830012 茆弘之 Linux pc 5.15.0-82-generic #91-Ubuntu SMP Mon Aug 14 14:14:14 UTC 2023 x86_64 x86_64 x86_64 GNU/Linux 22:20:30 up 4 days, 2:46, 6 users, load average: 0.67, 0.98, 0.95
2023-09-17 > run NEMU 221830012 茆弘之 Linux pc 5.15.0-82-generic #91-Ubuntu SMP Mon Aug 14 14:14:14 UTC 2023 x86_64 x86_64 x86_64 GNU/Linux 22:20:32 up 4 days, 2:46, 6 users, load average: 0.70, 0.98, 0.96
2023-09-17 > compile NEMU 221830012 茆弘之 Linux pc 5.15.0-82-generic #91-Ubuntu SMP Mon Aug 14 14:14:14 UTC 2023 x86_64 x86_64 x86_64 GNU/Linux 22:20:33 up 4 days, 2:46, 6 users, load average: 0.70, 0.98, 0.96
2023-09-17 > run NEMU 221830012 茆弘之 Linux pc 5.15.0-82-generic #91-Ubuntu SMP Mon Aug 14 14:14:14 UTC 2023 x86_64 x86_64 x86_64 GNU/Linux 22:20:35 up 4 days, 2:46, 6 users, load average: 0.70, 0.98, 0.96
2023-09-17 > compile NEMU 221830012 茆弘之 Linux pc 5.15.0-82-generic #91-Ubuntu SMP Mon Aug 14 14:14:14 UTC 2023 x86_64 x86_64 x86_64 GNU/Linux 22:20:37 up 4 days, 2:46, 6 users, load average: 1.04, 1.05, 0.98
2023-09-17 > run NEMU 221830012 茆弘之 Linux pc 5.15.0-82-generic #91-Ubuntu SMP Mon Aug 14 14:14:14 UTC 2023 x86_64 x86_64 x86_64 GNU/Linux 22:20:39 up 4 days, 2:46, 6 users, load average: 1.04, 1.05, 0.98
2023-09-17 > compile NEMU 221830012 茆弘之 Linux pc 5.15.0-82-generic #91-Ubuntu SMP Mon Aug 14 14:14:14 UTC 2023 x86_64 x86_64 x86_64 GNU/Linux 22:20:40 up 4 days, 2:46, 6 users, load average: 1.04, 1.05, 0.98
2023-09-17 > run NEMU 221830012 茆弘之 Linux pc 5.15.0-82-generic #91-Ubuntu SMP Mon Aug 14 14:14:14 UTC 2023 x86_64 x86_64 x86_64 GNU/Linux 22:20:42 up 4 days, 2:46, 6 users, load average: 1.04, 1.04, 0.98
2023-09-17 > compile NEMU 221830012 茆弘之 Linux pc 5.15.0-82-generic #91-Ubuntu SMP Mon Aug 14 14:14:14 UTC 2023 x86_64 x86_64 x86_64 GNU/Linux 22:20:43 up 4 days, 2:46, 6 users, load average: 1.04, 1.04, 0.98
2023-09-17 > run NEMU 221830012 茆弘之 Linux pc 5.15.0-82-generic #91-Ubuntu SMP Mon Aug 14 14:14:14 UTC 2023 x86_64 x86_64 x86_64 GNU/Linux 22:20:45 up 4 days, 2:46, 6 users, load average: 1.04, 1.04, 0.98
2023-09-17 > compile NEMU 221830012 茆弘之 Linux pc 5.15.0-82-generic #91-Ubuntu SMP Mon Aug 14 14:14:14 UTC 2023 x86_64 x86_64 x86_64 GNU/Linux 22:20:47 up 4 days, 2:46, 6 users, load average: 1.04, 1.04, 0.98
2023-09-17 > run NEMU 221830012 茆弘之 Linux pc 5.15.0-82-generic #91-Ubuntu SMP Mon Aug 14 14:14:14 UTC 2023 x86_64 x86_64 x86_64 GNU/Linux 22:20:48 up 4 days, 2:46, 6 users, load average: 1.04, 1.04, 0.98
2023-09-17 > compile NEMU 221830012 茆弘之 Linux pc 5.15.0-82-generic #91-Ubuntu SMP Mon Aug 14 14:14:14 UTC 2023 x86_64 x86_64 x86_64 GNU/Linux 22:20:50 up 4 days, 2:46, 6 users, load average: 1.04, 1.04, 0.98
2023-09-17 > run NEMU 221830012 茆弘之 Linux pc 5.15.0-82-generic #91-Ubuntu SMP Mon Aug 14 14:14:14 UTC 2023 x86_64 x86_64 x86_64 GNU/Linux 22:20:52 up 4 days, 2:46, 6 users, load average: 1.03, 1.04, 0.98
2023-09-17 > compile NEMU 221830012 茆弘之 Linux pc 5.15.0-82-generic #91-Ubuntu SMP Mon Aug 14 14:14:14 UTC 2023 x86_64 x86_64 x86_64 GNU/Linux 22:20:53 up 4 days, 2:46, 6 users, load average: 1.03, 1.04, 0.98
2023-09-17 > run NEMU 221830012 茆弘之 Linux pc 5.15.0-82-generic #91-Ubuntu SMP Mon Aug 14 14:14:14 UTC 2023 x86_64 x86_64 x86_64 GNU/Linux 22:20:55 up 4 days, 2:46, 6 users, load average: 1.03, 1.04, 0.98
2023-09-17 > compile NEMU 221830012 茆弘之 Linux pc 5.15.0-82-generic #91-Ubuntu SMP Mon Aug 14 14:14:14 UTC 2023 x86_64 x86_64 x86_64 GNU/Linux 22:20:56 up 4 days, 2:46, 6 users, load average: 1.03, 1.04, 0.98
2023-09-17 > run NEMU 221830012 茆弘之 Linux pc 5.15.0-82-generic #91-Ubuntu SMP Mon Aug 14 14:14:14 UTC 2023 x86_64 x86_64 x86_64 GNU/Linux 22:20:58 up 4 days, 2:46, 6 users, load average: 1.03, 1.04, 0.98
2023-09-17 > compile NEMU 221830012 茆弘之 Linux pc 5.15.0-82-generic #91-Ubuntu SMP Mon Aug 14 14:14:14 UTC 2023 x86_64 x86_64 x86_64 GNU/Linux 22:21:00 up 4 days, 2:46, 6 users, load average: 1.03, 1.04, 0.98
2023-09-17 > run NEMU 221830012 茆弘之 Linux pc 5.15.0-82-generic #91-Ubuntu SMP Mon Aug 14 14:14:14 UTC 2023 x86_64 x86_64 x86_64 GNU/Linux 22:21:02 up 4 days, 2:46, 6 users, load average: 1.03, 1.04, 0.98
2023-09-17 > compile NEMU 221830012 茆弘之 Linux pc 5.15.0-82-generic #91-Ubuntu SMP Mon Aug 14 14:14:14 UTC 2023 x86_64 x86_64 x86_64 GNU/Linux 22:21:03 up 4 days, 2:46, 6 users, load average: 1.03, 1.04, 0.98
2023-09-17 > run NEMU 221830012 茆弘之 Linux pc 5.15.0-82-generic #91-Ubuntu SMP Mon Aug 14 14:14:14 UTC 2023 x86_64 x86_64 x86_64 GNU/Linux 22:21:05 up 4 days, 2:46, 6 users, load average: 1.03, 1.04, 0.98
2023-09-17 > compile NEMU 221830012 茆弘之 Linux pc 5.15.0-82-generic #91-Ubuntu SMP Mon Aug 14 14:14:14 UTC 2023 x86_64 x86_64 x86_64 GNU/Linux 22:21:06 up 4 days, 2:47, 6 users, load average: 1.03, 1.04, 0.98
2023-09-17 > run NEMU 221830012 茆弘之 Linux pc 5.15.0-82-generic #91-Ubuntu SMP Mon Aug 14 14:14:14 UTC 2023 x86_64 x86_64 x86_64 GNU/Linux 22:21:08 up 4 days, 2:47, 6 users, load average: 1.02, 1.04, 0.98
2023-09-17 > compile NEMU 221830012 茆弘之 Linux pc 5.15.0-82-generic #91-Ubuntu SMP Mon Aug 14 14:14:14 UTC 2023 x86_64 x86_64 x86_64 GNU/Linux 22:21:10 up 4 days, 2:47, 6 users, load average: 1.02, 1.04, 0.98
2023-09-17 > run NEMU 221830012 茆弘之 Linux pc 5.15.0-82-generic #91-Ubuntu SMP Mon Aug 14 14:14:14 UTC 2023 x86_64 x86_64 x86_64 GNU/Linux 22:21:12 up 4 days, 2:47, 6 users, load average: 1.02, 1.04, 0.98
2023-09-17 > compile NEMU 221830012 茆弘之 Linux pc 5.15.0-82-generic #91-Ubuntu SMP Mon Aug 14 14:14:14 UTC 2023 x86_64 x86_64 x86_64 GNU/Linux 22:21:13 up 4 days, 2:47, 6 users, load average: 1.02, 1.04, 0.98
2023-09-17 > run NEMU 221830012 茆弘之 Linux pc 5.15.0-82-generic #91-Ubuntu SMP Mon Aug 14 14:14:14 UTC 2023 x86_64 x86_64 x86_64 GNU/Linux 22:21:15 up 4 days, 2:47, 6 users, load average: 1.02, 1.04, 0.98
2023-09-17 > compile NEMU 221830012 茆弘之 Linux pc 5.15.0-82-generic #91-Ubuntu SMP Mon Aug 14 14:14:14 UTC 2023 x86_64 x86_64 x86_64 GNU/Linux 22:21:16 up 4 days, 2:47, 6 users, load average: 1.02, 1.04, 0.98
2023-09-17 > run NEMU 221830012 茆弘之 Linux pc 5.15.0-82-generic #91-Ubuntu SMP Mon Aug 14 14:14:14 UTC 2023 x86_64 x86_64 x86_64 GNU/Linux 22:21:18 up 4 days, 2:47, 6 users, load average: 1.02, 1.04, 0.98
2023-09-17 > compile NEMU 221830012 茆弘之 Linux pc 5.15.0-82-generic #91-Ubuntu SMP Mon Aug 14 14:14:14 UTC 2023 x86_64 x86_64 x86_64 GNU/Linux 22:21:20 up 4 days, 2:47, 6 users, load average: 1.02, 1.04, 0.98
2023-09-17 > run NEMU 221830012 茆弘之 Linux pc 5.15.0-82-generic #91-Ubuntu SMP Mon Aug 14 14:14:14 UTC 2023 x86_64 x86_64 x86_64 GNU/Linux 22:21:22 up 4 days, 2:47, 6 users, load average: 1.18, 1.07, 0.99
2023-09-17 > compile NEMU 221830012 茆弘之 Linux pc 5.15.0-82-generic #91-Ubuntu SMP Mon Aug 14 14:14:14 UTC 2023 x86_64 x86_64 x86_64 GNU/Linux 22:21:23 up 4 days, 2:47, 6 users, load average: 1.18, 1.07, 0.99
2023-09-17 > run NEMU 221830012 茆弘之 Linux pc 5.15.0-82-generic #91-Ubuntu SMP Mon Aug 14 14:14:14 UTC 2023 x86_64 x86_64 x86_64 GNU/Linux 22:21:25 up 4 days, 2:47, 6 users, load average: 1.18, 1.07, 0.99
2023-09-17 > compile NEMU 221830012 茆弘之 Linux pc 5.15.0-82-generic #91-Ubuntu SMP Mon Aug 14 14:14:14 UTC 2023 x86_64 x86_64 x86_64 GNU/Linux 22:21:26 up 4 days, 2:47, 6 users, load average: 1.18, 1.07, 0.99
2023-09-17 > run NEMU 221830012 茆弘之 Linux pc 5.15.0-82-generic #91-Ubuntu SMP Mon Aug 14 14:14:14 UTC 2023 x86_64 x86_64 x86_64 GNU/Linux 22:21:28 up 4 days, 2:47, 6 users, load average: 1.24, 1.09, 1.00
2023-09-17 > compile NEMU 221830012 茆弘之 Linux pc 5.15.0-82-generic #91-Ubuntu SMP Mon Aug 14 14:14:14 UTC 2023 x86_64 x86_64 x86_64 GNU/Linux 22:21:30 up 4 days, 2:47, 6 users, load average: 1.24, 1.09, 1.00
2023-09-17 > run NEMU 221830012 茆弘之 Linux pc 5.15.0-82-generic #91-Ubuntu SMP Mon Aug 14 14:14:14 UTC 2023 x86_64 x86_64 x86_64 GNU/Linux 22:21:32 up 4 days, 2:47, 6 users, load average: 1.31, 1.10, 1.00
2023-09-17 > compile NEMU 221830012 茆弘之 Linux pc 5.15.0-82-generic #91-Ubuntu SMP Mon Aug 14 14:14:14 UTC 2023 x86_64 x86_64 x86_64 GNU/Linux 22:21:33 up 4 days, 2:47, 6 users, load average: 1.31, 1.10, 1.00
2023-09-17 > run NEMU 221830012 茆弘之 Linux pc 5.15.0-82-generic #91-Ubuntu SMP Mon Aug 14 14:14:14 UTC 2023 x86_64 x86_64 x86_64 GNU/Linux 22:21:35 up 4 days, 2:47, 6 users, load average: 1.31, 1.10, 1.00
2023-09-17 > compile NEMU 221830012 茆弘之 Linux pc 5.15.0-82-generic #91-Ubuntu SMP Mon Aug 14 14:14:14 UTC 2023 x86_64 x86_64 x86_64 GNU/Linux 22:21:36 up 4 days, 2:47, 6 users, load average: 1.31, 1.10, 1.00
2023-09-17 > run NEMU 221830012 茆弘之 Linux pc 5.15.0-82-generic #91-Ubuntu SMP Mon Aug 14 14:14:14 UTC 2023 x86_64 x86_64 x86_64 GNU/Linux 22:21:38 up 4 days, 2:47, 6 users, load average: 1.36, 1.12, 1.01
2023-09-17 > compile NEMU 221830012 茆弘之 Linux pc 5.15.0-82-generic #91-Ubuntu SMP Mon Aug 14 14:14:14 UTC 2023 x86_64 x86_64 x86_64 GNU/Linux 22:21:40 up 4 days, 2:47, 6 users, load average: 1.36, 1.12, 1.01
2023-09-17 > run NEMU 221830012 茆弘之 Linux pc 5.15.0-82-generic #91-Ubuntu SMP Mon Aug 14 14:14:14 UTC 2023 x86_64 x86_64 x86_64 GNU/Linux 22:21:42 up 4 days, 2:47, 6 users, load average: 1.33, 1.12, 1.01
2023-09-17 > compile NEMU 221830012 茆弘之 Linux pc 5.15.0-82-generic #91-Ubuntu SMP Mon Aug 14 14:14:14 UTC 2023 x86_64 x86_64 x86_64 GNU/Linux 22:21:43 up 4 days, 2:47, 6 users, load average: 1.33, 1.12, 1.01
2023-09-17 > run NEMU 221830012 茆弘之 Linux pc 5.15.0-82-generic #91-Ubuntu SMP Mon Aug 14 14:14:14 UTC 2023 x86_64 x86_64 x86_64 GNU/Linux 22:21:45 up 4 days, 2:47, 6 users, load average: 1.33, 1.12, 1.01
2023-09-17 > compile NEMU 221830012 茆弘之 Linux pc 5.15.0-82-generic #91-Ubuntu SMP Mon Aug 14 14:14:14 UTC 2023 x86_64 x86_64 x86_64 GNU/Linux 22:21:46 up 4 days, 2:47, 6 users, load average: 1.33, 1.12, 1.01
2023-09-17 > run NEMU 221830012 茆弘之 Linux pc 5.15.0-82-generic #91-Ubuntu SMP Mon Aug 14 14:14:14 UTC 2023 x86_64 x86_64 x86_64 GNU/Linux 22:21:48 up 4 days, 2:47, 6 users, load average: 1.55, 1.16, 1.03
2023-09-17 > compile NEMU 221830012 茆弘之 Linux pc 5.15.0-82-generic #91-Ubuntu SMP Mon Aug 14 14:14:14 UTC 2023 x86_64 x86_64 x86_64 GNU/Linux 22:21:50 up 4 days, 2:47, 6 users, load average: 1.55, 1.16, 1.03
2023-09-17 > run NEMU 221830012 茆弘之 Linux pc 5.15.0-82-generic #91-Ubuntu SMP Mon Aug 14 14:14:14 UTC 2023 x86_64 x86_64 x86_64 GNU/Linux 22:21:52 up 4 days, 2:47, 6 users, load average: 1.66, 1.19, 1.04
2023-09-17 > compile NEMU 221830012 茆弘之 Linux pc 5.15.0-82-generic #91-Ubuntu SMP Mon Aug 14 14:14:14 UTC 2023 x86_64 x86_64 x86_64 GNU/Linux 22:21:53 up 4 days, 2:47, 6 users, load average: 1.66, 1.19, 1.04
2023-09-17 > run NEMU 221830012 茆弘之 Linux pc 5.15.0-82-generic #91-Ubuntu SMP Mon Aug 14 14:14:14 UTC 2023 x86_64 x86_64 x86_64 GNU/Linux 22:21:55 up 4 days, 2:47, 6 users, load average: 1.66, 1.19, 1.04
2023-09-17 > compile NEMU 221830012 茆弘之 Linux pc 5.15.0-82-generic #91-Ubuntu SMP Mon Aug 14 14:14:14 UTC 2023 x86_64 x86_64 x86_64 GNU/Linux 22:21:56 up 4 days, 2:47, 6 users, load average: 1.66, 1.19, 1.04
2023-09-17 > run NEMU 221830012 茆弘之 Linux pc 5.15.0-82-generic #91-Ubuntu SMP Mon Aug 14 14:14:14 UTC 2023 x86_64 x86_64 x86_64 GNU/Linux 22:21:58 up 4 days, 2:47, 6 users, load average: 1.61, 1.19, 1.04
2023-09-17 > compile NEMU 221830012 茆弘之 Linux pc 5.15.0-82-generic #91-Ubuntu SMP Mon Aug 14 14:14:14 UTC 2023 x86_64 x86_64 x86_64 GNU/Linux 22:22:00 up 4 days, 2:47, 6 users, load average: 1.61, 1.19, 1.04
2023-09-17 > run NEMU 221830012 茆弘之 Linux pc 5.15.0-82-generic #91-Ubuntu SMP Mon Aug 14 14:14:14 UTC 2023 x86_64 x86_64 x86_64 GNU/Linux 22:22:02 up 4 days, 2:47, 6 users, load average: 1.64, 1.20, 1.04
2023-09-17 > compile NEMU 221830012 茆弘之 Linux pc 5.15.0-82-generic #91-Ubuntu SMP Mon Aug 14 14:14:14 UTC 2023 x86_64 x86_64 x86_64 GNU/Linux 22:22:03 up 4 days, 2:47, 6 users, load average: 1.64, 1.20, 1.04
2023-09-17 > run NEMU 221830012 茆弘之 Linux pc 5.15.0-82-generic #91-Ubuntu SMP Mon Aug 14 14:14:14 UTC 2023 x86_64 x86_64 x86_64 GNU/Linux 22:22:05 up 4 days, 2:47, 6 users, load average: 1.64, 1.20, 1.04
2023-09-17 > compile NEMU 221830012 茆弘之 Linux pc 5.15.0-82-generic #91-Ubuntu SMP Mon Aug 14 14:14:14 UTC 2023 x86_64 x86_64 x86_64 GNU/Linux 22:22:06 up 4 days, 2:48, 6 users, load average: 1.64, 1.20, 1.04
2023-09-17 > run NEMU 221830012 茆弘之 Linux pc 5.15.0-82-generic #91-Ubuntu SMP Mon Aug 14 14:14:14 UTC 2023 x86_64 x86_64 x86_64 GNU/Linux 22:22:08 up 4 days, 2:48, 6 users, load average: 1.59, 1.20, 1.04
2023-09-17 > compile NEMU 221830012 茆弘之 Linux pc 5.15.0-82-generic #91-Ubuntu SMP Mon Aug 14 14:14:14 UTC 2023 x86_64 x86_64 x86_64 GNU/Linux 22:22:09 up 4 days, 2:48, 6 users, load average: 1.59, 1.20, 1.04
2023-09-17 > run NEMU 221830012 茆弘之 Linux pc 5.15.0-82-generic #91-Ubuntu SMP Mon Aug 14 14:14:14 UTC 2023 x86_64 x86_64 x86_64 GNU/Linux 22:22:11 up 4 days, 2:48, 6 users, load average: 1.59, 1.20, 1.04
2023-09-17 > compile NEMU 221830012 茆弘之 Linux pc 5.15.0-82-generic #91-Ubuntu SMP Mon Aug 14 14:14:14 UTC 2023 x86_64 x86_64 x86_64 GNU/Linux 22:22:13 up 4 days, 2:48, 6 users, load average: 1.62, 1.21, 1.05
2023-09-17 > run NEMU 221830012 茆弘之 Linux pc 5.15.0-82-generic #91-Ubuntu SMP Mon Aug 14 14:14:14 UTC 2023 x86_64 x86_64 x86_64 GNU/Linux 22:22:15 up 4 days, 2:48, 6 users, load average: 1.62, 1.21, 1.05
2023-09-17 > compile NEMU 221830012 茆弘之 Linux pc 5.15.0-82-generic #91-Ubuntu SMP Mon Aug 14 14:14:14 UTC 2023 x86_64 x86_64 x86_64 GNU/Linux 22:22:16 up 4 days, 2:48, 6 users, load average: 1.62, 1.21, 1.05
2023-09-17 > run NEMU 221830012 茆弘之 Linux pc 5.15.0-82-generic #91-Ubuntu SMP Mon Aug 14 14:14:14 UTC 2023 x86_64 x86_64 x86_64 GNU/Linux 22:22:18 up 4 days, 2:48, 6 users, load average: 1.57, 1.21, 1.05
2023-09-17 > compile NEMU 221830012 茆弘之 Linux pc 5.15.0-82-generic #91-Ubuntu SMP Mon Aug 14 14:14:14 UTC 2023 x86_64 x86_64 x86_64 GNU/Linux 22:22:19 up 4 days, 2:48, 6 users, load average: 1.57, 1.21, 1.05
2023-09-17 > run NEMU 221830012 茆弘之 Linux pc 5.15.0-82-generic #91-Ubuntu SMP Mon Aug 14 14:14:14 UTC 2023 x86_64 x86_64 x86_64 GNU/Linux 22:22:21 up 4 days, 2:48, 6 users, load average: 1.57, 1.21, 1.05
2023-09-17 > compile NEMU 221830012 茆弘之 Linux pc 5.15.0-82-generic #91-Ubuntu SMP Mon Aug 14 14:14:14 UTC 2023 x86_64 x86_64 x86_64 GNU/Linux 23:52:21 up 4 days, 4:18, 4 users, load average: 0.56, 0.76, 0.82
2023-09-17 > run NEMU 221830012 茆弘之 Linux pc 5.15.0-82-generic #91-Ubuntu SMP Mon Aug 14 14:14:14 UTC 2023 x86_64 x86_64 x86_64 GNU/Linux 23:52:22 up 4 days, 4:18, 4 users, load average: 0.68, 0.78, 0.82
2023-09-17 > compile NEMU 221830012 茆弘之 Linux pc 5.15.0-82-generic #91-Ubuntu SMP Mon Aug 14 14:14:14 UTC 2023 x86_64 x86_64 x86_64 GNU/Linux 00:00:19 up 4 days, 4:26, 4 users, load average: 0.66, 0.63, 0.73
2023-09-17 > run NEMU 221830012 茆弘之 Linux pc 5.15.0-82-generic #91-Ubuntu SMP Mon Aug 14 14:14:14 UTC 2023 x86_64 x86_64 x86_64 GNU/Linux 00:00:20 up 4 days, 4:26, 4 users, load average: 0.66, 0.63, 0.73
2023-09-17 > compile NEMU 221830012 茆弘之 Linux pc 5.15.0-82-generic #91-Ubuntu SMP Mon Aug 14 14:14:14 UTC 2023 x86_64 x86_64 x86_64 GNU/Linux 00:00:49 up 4 days, 4:26, 4 users, load average: 0.63, 0.64, 0.73
2023-09-17 > run NEMU 221830012 茆弘之 Linux pc 5.15.0-82-generic #91-Ubuntu SMP Mon Aug 14 14:14:14 UTC 2023 x86_64 x86_64 x86_64 GNU/Linux 00:00:51 up 4 days, 4:26, 4 users, load average: 0.63, 0.64, 0.73
2023-09-17 > compile NEMU 221830012 茆弘之 Linux pc 5.15.0-82-generic #91-Ubuntu SMP Mon Aug 14 14:14:14 UTC 2023 x86_64 x86_64 x86_64 GNU/Linux 00:02:24 up 4 days, 4:28, 4 users, load average: 1.22, 0.87, 0.80
2023-09-17 > run NEMU 221830012 茆弘之 Linux pc 5.15.0-82-generic #91-Ubuntu SMP Mon Aug 14 14:14:14 UTC 2023 x86_64 x86_64 x86_64 GNU/Linux 00:02:26 up 4 days, 4:28, 4 users, load average: 1.22, 0.87, 0.80
2023-09-17 > compile NEMU 221830012 茆弘之 Linux pc 5.15.0-82-generic #91-Ubuntu SMP Mon Aug 14 14:14:14 UTC 2023 x86_64 x86_64 x86_64 GNU/Linux 07:53:06 up 4 days, 12:19, 4 users, load average: 0.31, 0.27, 0.42
2023-09-17 > run NEMU 221830012 茆弘之 Linux pc 5.15.0-82-generic #91-Ubuntu SMP Mon Aug 14 14:14:14 UTC 2023 x86_64 x86_64 x86_64 GNU/Linux 07:53:07 up 4 days, 12:19, 4 users, load average: 0.45, 0.30, 0.43
2023-09-17 > compile NEMU 221830012 茆弘之 Linux pc 5.15.0-82-generic #91-Ubuntu SMP Mon Aug 14 14:14:14 UTC 2023 x86_64 x86_64 x86_64 GNU/Linux 07:53:53 up 4 days, 12:19, 4 users, load average: 0.69, 0.38, 0.45
2023-09-17 > run NEMU 221830012 茆弘之 Linux pc 5.15.0-82-generic #91-Ubuntu SMP Mon Aug 14 14:14:14 UTC 2023 x86_64 x86_64 x86_64 GNU/Linux 07:53:55 up 4 days, 12:19, 4 users, load average: 0.69, 0.38, 0.45
2023-09-17 > compile NEMU 221830012 茆弘之 Linux pc 5.15.0-82-generic #91-Ubuntu SMP Mon Aug 14 14:14:14 UTC 2023 x86_64 x86_64 x86_64 GNU/Linux 07:56:28 up 4 days, 12:22, 4 users, load average: 1.14, 0.59, 0.52
2023-09-17 > run NEMU 221830012 茆弘之 Linux pc 5.15.0-82-generic #91-Ubuntu SMP Mon Aug 14 14:14:14 UTC 2023 x86_64 x86_64 x86_64 GNU/Linux 07:56:30 up 4 days, 12:22, 4 users, load average: 1.14, 0.59, 0.52
2023-09-18 > compile NEMU 221830012 茆弘之 Linux pc 5.15.0-82-generic #91-Ubuntu SMP Mon Aug 14 14:14:14 UTC 2023 x86_64 x86_64 x86_64 GNU/Linux 08:49:44 up 4 days, 13:15, 4 users, load average: 0.97, 0.74, 0.60
2023-09-18 > run NEMU 221830012 茆弘之 Linux pc 5.15.0-82-generic #91-Ubuntu SMP Mon Aug 14 14:14:14 UTC 2023 x86_64 x86_64 x86_64 GNU/Linux 08:49:46 up 4 days, 13:15, 4 users, load average: 0.97, 0.74, 0.60
2023-09-18 > compile NEMU 221830012 茆弘之 Linux pc 5.15.0-82-generic #91-Ubuntu SMP Mon Aug 14 14:14:14 UTC 2023 x86_64 x86_64 x86_64 GNU/Linux 08:51:43 up 4 days, 13:17, 4 users, load average: 0.48, 0.69, 0.61
2023-09-18 > run NEMU 221830012 茆弘之 Linux pc 5.15.0-82-generic #91-Ubuntu SMP Mon Aug 14 14:14:14 UTC 2023 x86_64 x86_64 x86_64 GNU/Linux 08:51:45 up 4 days, 13:17, 4 users, load average: 0.61, 0.71, 0.61
2023-09-18 > compile NEMU 221830012 茆弘之 Linux pc 5.15.0-82-generic #91-Ubuntu SMP Mon Aug 14 14:14:14 UTC 2023 x86_64 x86_64 x86_64 GNU/Linux 08:51:52 up 4 days, 13:17, 4 users, load average: 0.56, 0.70, 0.61
2023-09-18 > run NEMU 221830012 茆弘之 Linux pc 5.15.0-82-generic #91-Ubuntu SMP Mon Aug 14 14:14:14 UTC 2023 x86_64 x86_64 x86_64 GNU/Linux 08:51:54 up 4 days, 13:17, 4 users, load average: 0.56, 0.70, 0.61
2023-09-18 > compile NEMU 221830012 茆弘之 Linux pc 5.15.0-82-generic #91-Ubuntu SMP Mon Aug 14 14:14:14 UTC 2023 x86_64 x86_64 x86_64 GNU/Linux 08:52:40 up 4 days, 13:18, 4 users, load average: 0.93, 0.78, 0.64
2023-09-18 > run NEMU 221830012 茆弘之 Linux pc 5.15.0-82-generic #91-Ubuntu SMP Mon Aug 14 14:14:14 UTC 2023 x86_64 x86_64 x86_64 GNU/Linux 08:52:41 up 4 days, 13:18, 4 users, load average: 0.93, 0.78, 0.64
2023-09-19 > compile NEMU 221830012 茆弘之 Linux pc 5.15.0-82-generic #91-Ubuntu SMP Mon Aug 14 14:14:14 UTC 2023 x86_64 x86_64 x86_64 GNU/Linux 08:09:38 up 5 days, 12:35, 4 users, load average: 0.38, 0.55, 0.60
2023-09-19 > run NEMU 221830012 茆弘之 Linux pc 5.15.0-82-generic #91-Ubuntu SMP Mon Aug 14 14:14:14 UTC 2023 x86_64 x86_64 x86_64 GNU/Linux 08:09:40 up 5 days, 12:35, 4 users, load average: 0.38, 0.55, 0.60
2023-09-19 > compile NEMU 221830012 茆弘之 Linux pc 5.15.0-82-generic #91-Ubuntu SMP Mon Aug 14 14:14:14 UTC 2023 x86_64 x86_64 x86_64 GNU/Linux 08:10:11 up 5 days, 12:36, 4 users, load average: 1.42, 0.79, 0.68
2023-09-19 > run NEMU 221830012 茆弘之 Linux pc 5.15.0-82-generic #91-Ubuntu SMP Mon Aug 14 14:14:14 UTC 2023 x86_64 x86_64 x86_64 GNU/Linux 08:10:13 up 5 days, 12:36, 4 users, load average: 1.42, 0.79, 0.68
2023-09-19 > compile NEMU 221830012 茆弘之 Linux pc 5.15.0-82-generic #91-Ubuntu SMP Mon Aug 14 14:14:14 UTC 2023 x86_64 x86_64 x86_64 GNU/Linux 08:11:47 up 5 days, 12:37, 4 users, load average: 1.48, 0.96, 0.75
2023-09-19 > run NEMU 221830012 茆弘之 Linux pc 5.15.0-82-generic #91-Ubuntu SMP Mon Aug 14 14:14:14 UTC 2023 x86_64 x86_64 x86_64 GNU/Linux 08:11:49 up 5 days, 12:37, 4 users, load average: 1.48, 0.96, 0.75
2023-09-19 > compile NEMU 221830012 茆弘之 Linux pc 5.15.0-82-generic #91-Ubuntu SMP Mon Aug 14 14:14:14 UTC 2023 x86_64 x86_64 x86_64 GNU/Linux 08:53:19 up 5 days, 13:19, 4 users, load average: 0.31, 0.46, 0.53
2023-09-19 > run NEMU 221830012 茆弘之 Linux pc 5.15.0-82-generic #91-Ubuntu SMP Mon Aug 14 14:14:14 UTC 2023 x86_64 x86_64 x86_64 GNU/Linux 08:53:21 up 5 days, 13:19, 4 users, load average: 0.31, 0.46, 0.53
2023-09-19 > compile NEMU 221830012 茆弘之 Linux pc 5.15.0-82-generic #91-Ubuntu SMP Mon Aug 14 14:14:14 UTC 2023 x86_64 x86_64 x86_64 GNU/Linux 08:55:30 up 5 days, 13:21, 4 users, load average: 0.45, 0.48, 0.53
2023-09-19 > run NEMU 221830012 茆弘之 Linux pc 5.15.0-82-generic #91-Ubuntu SMP Mon Aug 14 14:14:14 UTC 2023 x86_64 x86_64 x86_64 GNU/Linux 08:55:32 up 5 days, 13:21, 4 users, load average: 0.45, 0.48, 0.53
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2023-11-29 OpenXiangShan/chisel-playground master initialized
    OpenXiangShan/chisel-playground 6d9522ad6bfafbadd88f0820ec47570601141c61 build.sc: fix compile error with latest mill
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2023-12-01 [framework] fixed ld script sections.
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2023-12-02 [doc] fixed spec mem restrictions.
    [ioe.c]
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2023-12-19 [device] Waiting for correct Keyboard.
    [Keyboard.sv, top.sv]
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
